Kieran-who/kia-tasman-fitout/docs/v0.8-concept.md

# v0.8: detailed model and full wiring diagram

Status: **eighth iteration.** The interference check reports **0 clashes** (travel + camp) after all detail passes were merged. Measurements are still the `[EST]` values in `cad/params.py` unless a published figure replaced them (listed below).

- Renders: [`renders/v0.8/`](../renders/v0.8) (26 images)
- Wiring diagram: [`docs/wiring/`](wiring) (eight A3 sheets as HTML, PDF and SVG)

## 1. More detail in every component

Every purchased component and fabricated part was redrawn from published drawings and photos. Part names, anchors and groups are unchanged, so the BOM, wiring and viewer still line up.

| Area | What changed | Renders |
|---|---|---|
| Vehicle | Tasman cab and body shape, published overhangs (5410 mm overall) and track, 265/70R17 wheels, C-section chassis. The tub liner follows the owner photo: ribs, arch hump with its recessed well, recessed wall panels, tie-down rails, corner cleats, factory outlet housing, tailgate panel and tail lights | `vehicle_01`, `vehicle_02` |
| Lid, rack, tent | Load-Lid with hinges, gas struts and lock. Destroyer rails. Teardrop Vortex bars on tapered brackets. Panther Horizon shell lofted from the 23Zero drawing, with hinges, latches, ladder bracket and eArc cells | `vehicle_03` |
| Tent services box | Real IP66 inlet and outlet faces, Anderson SB50 and MC4 pair. The box grew to 315 × 125 so the Clipsal 56-series faces fit, and still clears the lid by 38 mm | `vehicle_04` |
| Roof | Wedgetail extrusions, fairing with flush light bar, BlueSolar frames and cells, Starlink Mini, cargo bars | `vehicle_05` |
| Battery bay | MultiPlus-II with connection area and glands; Orion XS and MPPTs with heatsinks and terminal hoods; iTech400X Pro cases, terminals and straps; MRBFs, PowerBars, ML-RBS, Class-T, SmartShunt, MIDI/MEGA holders, lugs, fan, slotted guard | `bay_01`–`bay_04` |
| Cabinets | Jointed ply carcasses; 48" and 22" three-member runners; finger-jointed drawer boxes; divider channels; paddle latches. Full rear control panel. Behind it: RCBO enclosure, fuse block, Cerbo, wiring duct and glands | `cabinets_01`–`04` |
| Slides | DZ9308 three-member profile with ball races and holes, lock lever worked from the rear pull by cable, L-track profile, flanged receivers, power-pod sockets at real size, igus-style chain links, fold-out legs with clevis, pins and swivel foot | `slides_01`–`04` |
| Example payload | CFX3 45 (694 × 398 × 476, published), NCE microwave, drawer module, food crate, straps with buckles | `slides_05` |

**Model size:** each GLB is 6.4 MB (was 3.6 MB) and the build takes about 85 s (was about 35 s). Small round features are low-poly prisms to keep the viewer responsive.

## 2. Full wiring diagram

Sheets **E1–E8** are generated by `tools/wiring/diagram.py` from the same cable list that routes the 3D cables. Cable IDs and lengths always match `bom/cable-schedule-v0.8.csv`, and the generator fails if a cable isn't drawn.

| Sheet | Content |
|---|---|
| E1 | Locations, and which cables share each run (computed from the routed model) |
| E2 | Battery bank, MRBFs, busbars, ML-RBS isolation, SmartShunt, Class-T, MultiPlus DC, earthing |
| E3 | FB1 fuse block ways and every 12 V outlet |
| E4 | Alternator → Orion XS with ignition sense; roof and tent arrays → MPPTs |
| E5 | 230 V: shore inlet + RCBO → MultiPlus → RCBOs → outlets, earth path |
| E6 | Cerbo GX ports, GX Touch, Home Assistant, switch wiring, remote on/off |
| E7 | Tent harness, gap-junction connectors J1–J4 with pinouts, and the detach procedure |
| E8 | Cable routes (plan and side), bundles, cable to buy |

The schedules are on the same page: cables, protection, fuse-block ways and the component register.

**Design changes made while drawing it:**
- **Cerbo GX MK2:** it has only 3 VE.Direct ports. The Orion XS now connects through a **VE.Direct-to-USB** interface (D4).
- **ML-RBS:** its control circuit gets its own **2 A feed from the bank side** (F10/RBF), so the switch can close the RBS again. SW1 is now 4-core.
- **New circuits:**
  - IGN: ignition sense to the Orion's remote H, so smart-alternator voltage detection isn't relied on.
  - FAN: fused inverter fan.
  - CGX: Cerbo power.
  - PE1: inverter case to the system − bus (Victron: same size as the DC −).
  - CHB: one chassis bond.
- **Rear-panel DC outlets:** each now has its own fuse (DO1A–D) instead of sharing one cable.
- **Pod and cabin boxes:** each gets local 15 A and 10 A fuses for its 12 V and USB-C sockets.
- **Roof panels now in parallel.** The 190 W and 130 W panels have different currents, so in series the 190 W panel would be held back. Both arrays get 2-pole DC isolators.
- **MPPT 100/30 fuse:** reduced to 40 A.
- **Keyed tent connectors:**
  - The two 230 V connectors differ in rating and gender: J1 is a 10 A socket on the vehicle side, J2 is a 15 A inlet on the vehicle side. The tent's outlet can't be plugged into its own inlet.
  - The 12 V Anderson is red and the PV Anderson is grey; the two colours don't mate.
- **Shore power:** gets its own RCBO in the tent services box.

## 3. Real products that changed the model

| Item | Was | Now (published) |
|---|---|---|
| iTech400X Pro terminals | + and − at opposite ends | **Both at one end** (top), so the bank cables are shorter |
| MultiPlus-II 12/3000 | 20 kg; DC at the rear end | **19 kg; DC terminals toward the front wall, AC toward the rear** |
| SmartSolar 100/30 | 130 wide × 186 tall | **186 wide × 130 tall × 70** |
| ML-RBS 7713 | 110 × 95 × 100 | **139 × 95 × 52**, studs out of the bottom end |
| PowerBar 600 A / Class-T 5502 / MRBF 5191 | smaller placeholders | 178 × 51 × 51 / ~178 × 51 × 58 / 61 × 45 × 20 |
| Blue Sea 5026 fuse block | 211 × 45 × 140 | **164 × 84 × 39** |
| Clipsal Iconic double GPO (pod) | 70 mm pod | 120 × 78 → **pod deepened to 85 mm**. Fridge well is now 751 mm (CFX3 45 is 694) |
| Rear panel GPO | "56-series double" | There is no 56-series double. An IP66 twin is ~146 × 117, bigger than the panel's 120 × 86 space |
| DZ9308 runners | 6.3 kg/pair | ~5.75 kg (interpolated; confirm a 46" E4 length exists) |
| Divider channel | 12 × 12 × 1.6 | too tight for 9 mm ply → 12.7 × 8 × 1.2 |
| Utility drawer runners | ~600 mm | 22" (559 mm) to fit the 609 mm box |
| Tasman | – | overhangs 855 / 1285 mm, track 1636 / 1624 mm |

## 4. Layout issues the detail exposed (need decisions)

1. **MultiPlus cable entry.** Its cable-entry end is only **8 mm** from the distribution board, which was also true in v0.7. The 2 × 50 mm² DC cables and the AC glands need about 100 mm to bend.
   - Proposed fix: pass-through grommets in the board, in line with the inverter's entries, with the Class-T and busbars directly behind.
   - The alternative is re-shuffling the distribution column; the bay is about 90 mm short for that.
2. **DZ9308 front lock lever.** The real lever sticks out 27 mm, but there are only 2.6 mm to the rear plate. The model works the lever by Bowden cable from the rear pull. On the build: trim the lever or use a cable-release kit.
3. **Cable chain.** A real igus E2.26 with 38 mm inner width is 55 wide, and the lane is 50 mm. Use a chain no more than 40 mm wide outside (smaller series, ~25 mm inner width), or widen the lane, which costs deck width.
4. **Rear-panel GPO.** It needs a smaller twin, two single 56-series outlets, or a panel re-layout.
5. **Tent fold-out side.** The detail agent read `reference/vehicle-tent-open.jpg` as opening toward the passenger side. The model keeps the **driver side**, as you specified. Shout if the photo is right.
6. **Load-Lid gas struts.** They are modelled inside the top of the tub walls `[CONFIRM]`. If yours mount inside the tub, they would affect the passenger cable tray and the upper drawers.

**Also fixed:** the cable chain was 69 mm short at full extension. Its fixed end now sits at mid-travel, and its length is travel/2 + πR.

## 5. Numbers (model)

| | v0.7 | v0.8 |
|---|---|---|
| Fit-out total | 483.7 kg | **496.7 kg** (+13 kg). Mostly the drawer boxes, which were under-weighted before and are now real 9 mm panels. Then the runner plate, latches and stile. Runners got lighter |
| Rear axle added (fit-out, travel) | 459 kg | **471 kg** |
| Example payload | 108.2 kg | 108.2 kg |
| Cables | 35 | **46**, 104.9 m routed |
| GLB per state | 3.6 MB | 6.4 MB |

## 6. Questions for v0.9

1. MultiPlus cable entry: is the pass-through-grommet fix OK?
2. Rear-panel GPO: smaller twin, two singles, or re-layout the panel?
3. Tent fold-out side and gas-strut position: can you confirm both?
4. Still open: fridge model, and real measurements (tub floor height for the legs, arch well, tie-down points).
