Kieran-who/kia-tasman-fitout/reference/23zero-panther-horizon-1600-top-drawing.png

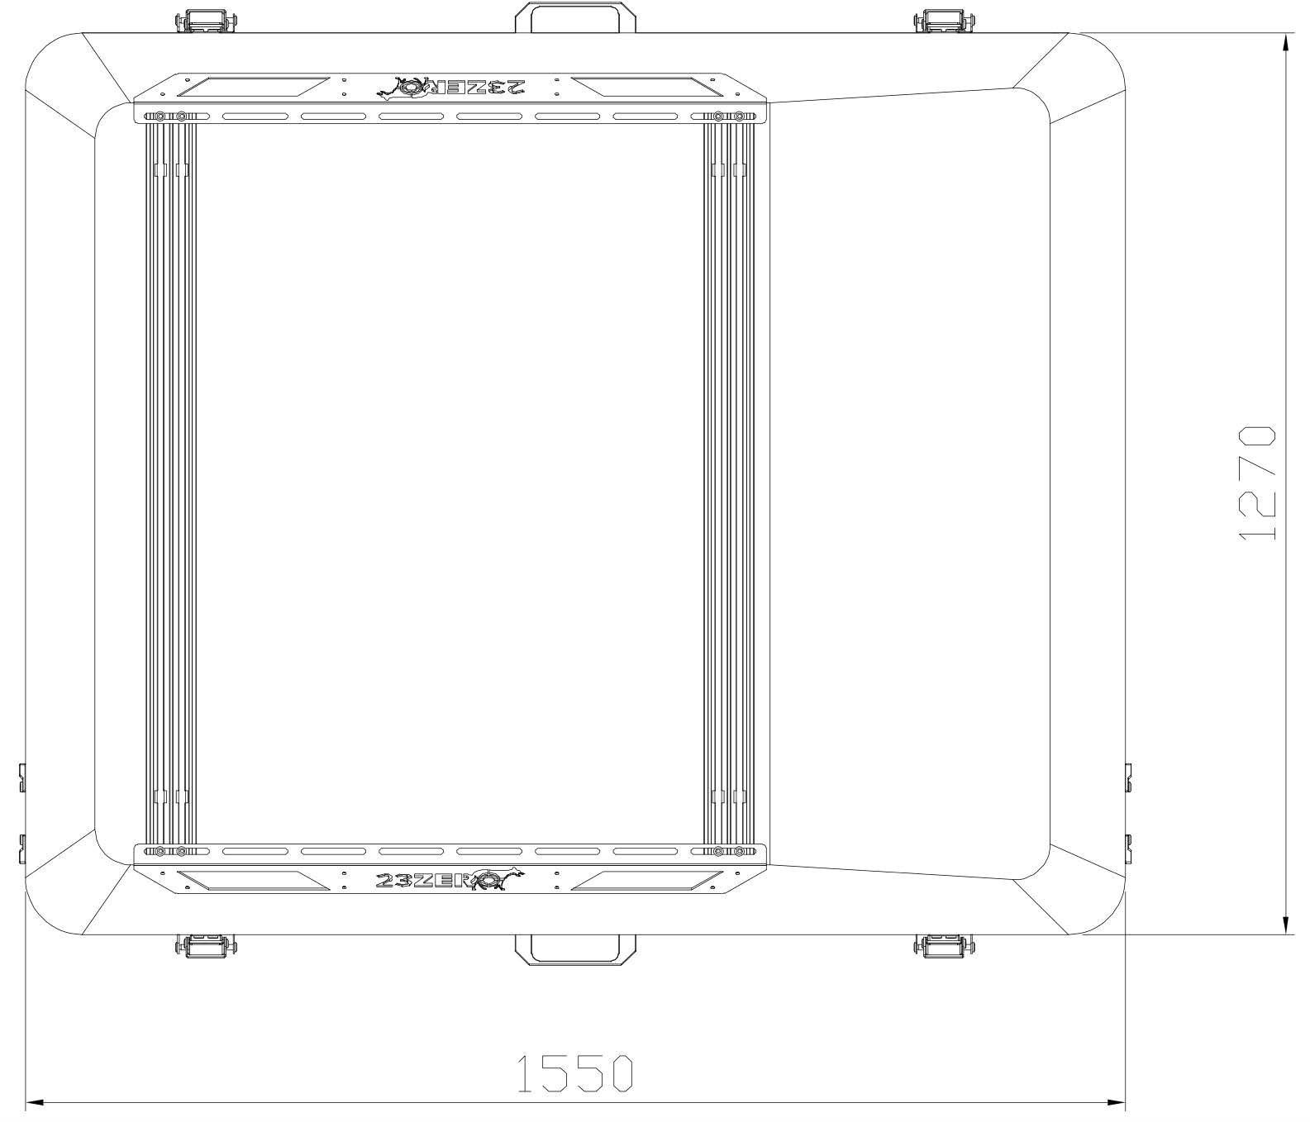
reference/23zero-panther-horizon-1600-top-drawing.png
