Kieran-who/kia-tasman-fitout/reference/tasman-tub-liner-arch-well.jpg

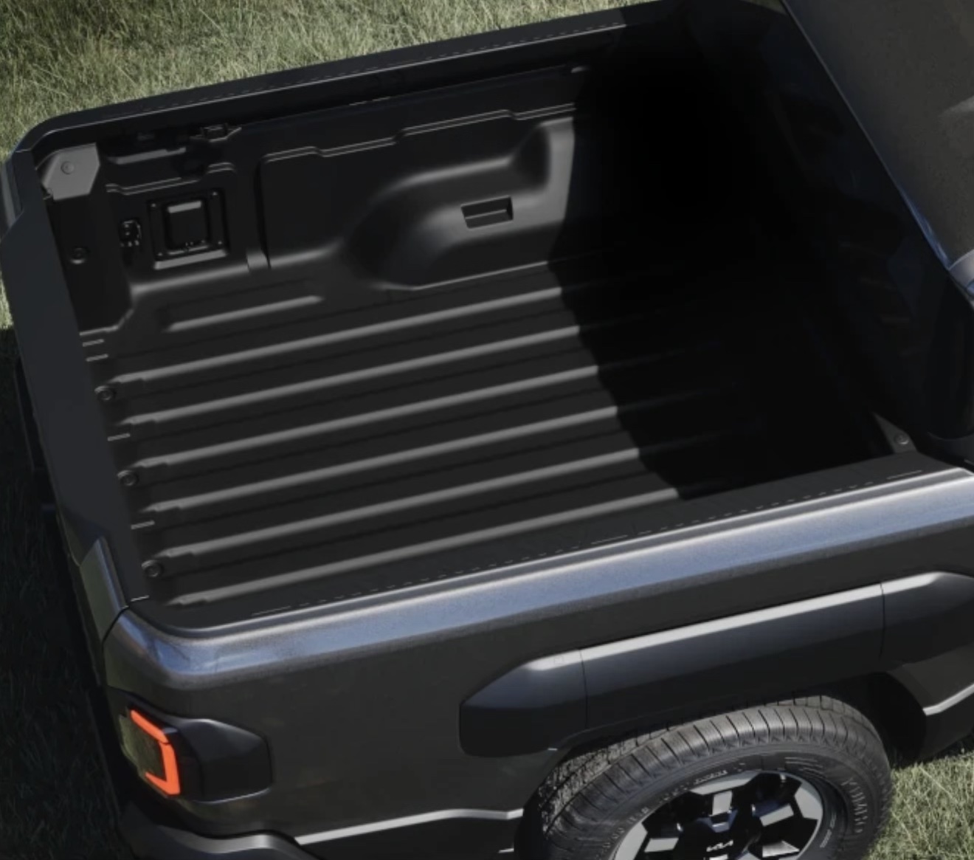
reference/tasman-tub-liner-arch-well.jpg
