Kieran-who/kia-tasman-fitout/reference/tent-closed-on-load-lid.jpg

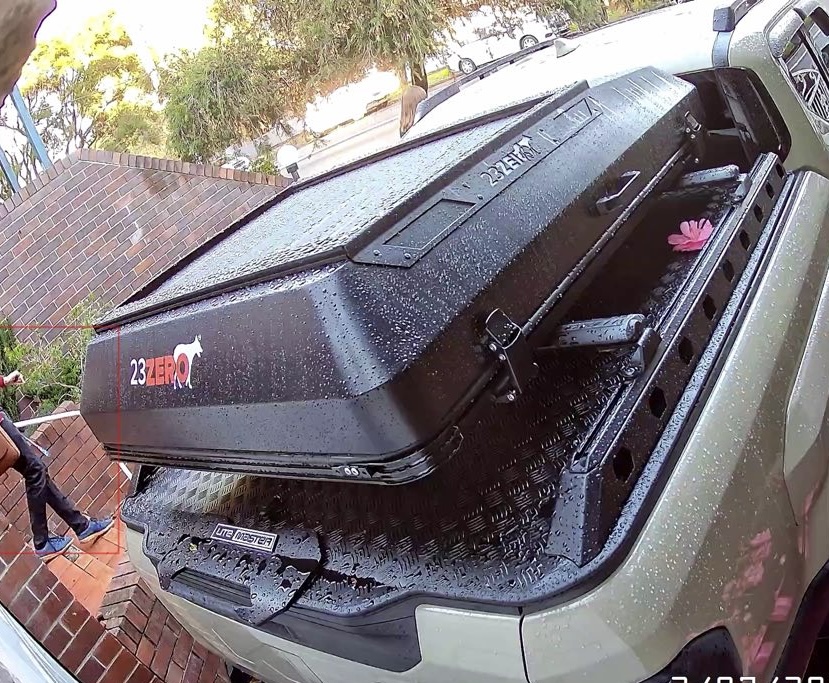
reference/tent-closed-on-load-lid.jpg
