Kieran-who/kia-tasman-fitout/reference/vehicle-tent-open.jpg

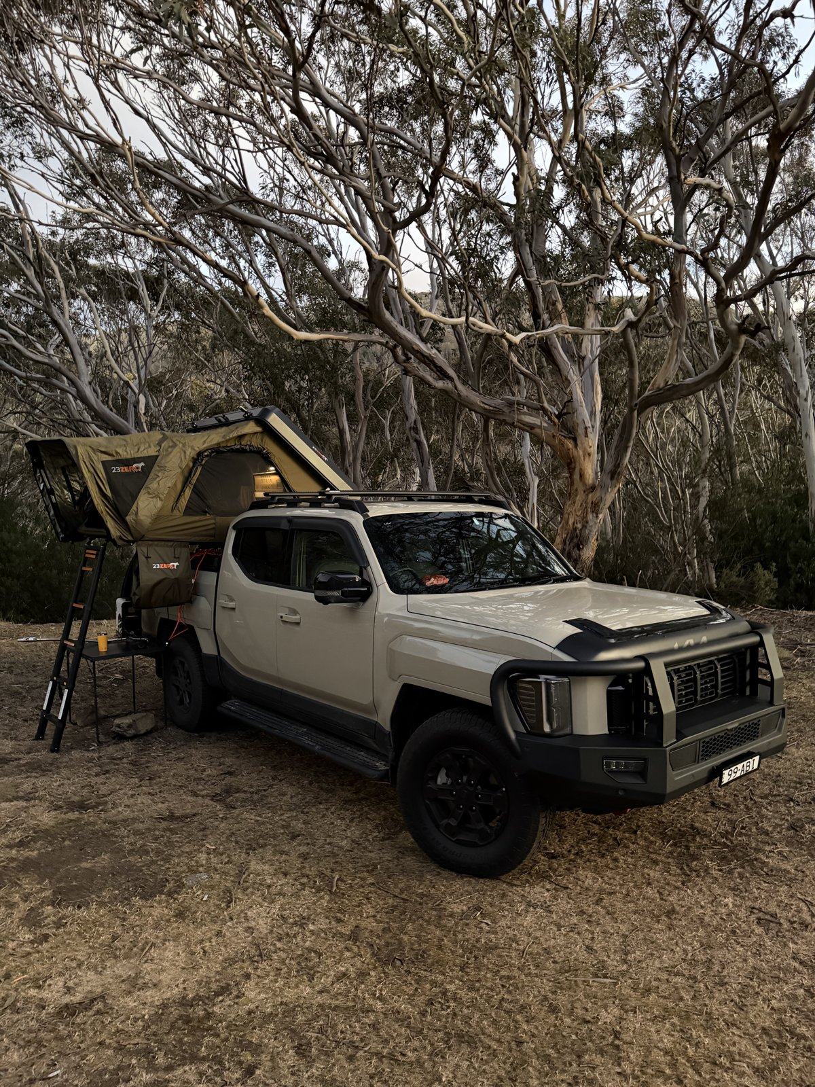
reference/vehicle-tent-open.jpg
