Kieran-who/kia-tasman-fitout/bom/cost-by-stage-v0.14.csv

stage | name | products AUD | cable AUD | materials AUD | stage total AUD | real prices AUD | running total AUD
1 | Power core | 7309 | 1234 | 769 | 9312 | 6374 | 9312
2 | Roof platform and solar | 3097 | 351 | 229 | 3677 | 2675 | 12989
3 | Slides and storage | 4268 | 131 | 1811 | 6210 | 32 | 19198
4 | 230 V and monitoring | 3688 | 578 | 0 | 4266 | 3104 | 23464
5 | Tent solar and cabin compute feed | 759 | 134 | 104 | 997 | 644 | 24462
6 | Under-tent storage | 996 | 5 | 371 | 1371 | 370 | 25833
7 | Visor and roof extras | 2944 | 108 | 41 | 3093 | 813 | 28926
