Kieran-who/kia-tasman-fitout/bom/product-list-v0.14.csv

system | item | model / part no. | qty | unit AUD inc GST | line AUD inc GST | price | source | price checked | dimensions mm | unit kg | status | stage | notes
energy storage | Lithium battery 12V 400Ah | iTechworld iTech400X Pro | 2 | 1996.0 | 3992.0 | actual | https://itechworld.com.au/products/12v-400ah-lithium-battery-with-bluetooth-itech400x-pro (iTechworld; sale price A$1,996 on 2026-10-23, regular A$3,499; has also shown A$2,499) | 2026-10-23 | 525x240x235 | 38 | owner-specified | 1 | mounted ON END (any orientation except upside down per iTechworld); 200 A continuous / 640 A 5 s, 150 A max charge (maker page 2026-10-23); no published low-temperature charge cut-off
distribution | MIDI/MEGA fuse holders + fuses | Blue Sea 5151 (MIDI) / 5502-type MEGA | 4 | 62.6 | 250.4 | actual | https://www.bluebottlemarine.com/products/blue-sea-systems-fuse-block-ami-or-midi.html + https://bluebottlemarine.com/products/blue-sea-ami-or-midi-fuses.html (Blue Bottle Marine; Blue Sea 7720B AMI/MIDI block A$57.60 + MIDI fuse A$5.00 (both sale); no AU listing for 5151; check the 7720B fuse range) | 2026-10-20 |  | 0.1 | proposed | 1:2,2:1,5:1 | F4 Orion 70 A, F5 MPPT roof 60 A, F6 MPPT tent 20 A, F7 fuse block 100 A MEGA (sheet E2)
monitoring | GX device | Victron Cerbo GX MK2 | 1 | 337.63 | 337.63 | actual | https://www.outbackmarine.com.au/victron-cerbo-gx-mk2 (Outback Marine; sale price, RRP A$526) | 2026-10-20 | 48x154x78 | 0.4 | proposed | 4 | Home Assistant: core Victron GX (MQTT) integration
monitoring | Touch display | Victron GX Touch 50 | 1 | 300.3 | 300.3 | actual | https://www.outbackmarine.com.au/victron-gx-touch-50-display (Outback Marine; sale price, RRP A$468) | 2026-10-20 | 87x128x12.5 | 0.2 | proposed | 4 | rear power panel
DC charging | DC-DC charger 50A | Victron Orion XS 12/12-50A | 1 | 465.0 | 465.0 | actual | https://www.mygenerator.com.au/victron-orion-xs-12-12-50a-dc-dc-battery-charger (MyGenerator; sale price, was A$587) | 2026-10-20 | 137x123x40 | 0.33 | proposed | 1 | input limit 25-30 A until alternator rating known
solar | MPPT roof array (PV1 + PV2) | Victron SmartSolar MPPT 100/30 | 1 | 199.0 | 199.0 | estimate | estimate: AU sale prices ~A$190-215 (RRP ~A$300); not checked this round |  | 130x186x70 | 1.3 | proposed | 2 | v0.13: back to the 100/30 - the visor panel moved to its own MPPT (U13)
solar | MPPT tent array | Victron SmartSolar MPPT 75/15 | 1 | 86.59 | 86.59 | actual | https://www.outbackmarine.com.au/victron-smartsolar-mppt-75-15-retail (Outback Marine; sale price, RRP A$135) | 2026-10-20 | 100x113x40 | 0.5 | proposed | 5
solar | Roof panel 190W | Victron BlueSolar 190 W (SPM041903903) | 1 | 180.07 | 180.07 | actual | https://www.outbackmarine.com.au/victron-solar-panel-190w-39-cells-mono-1485x668x30~211745 (Outback Marine; sale price, RRP A$270; current variant SPM041903904) | 2026-10-20 | 1485x668x30 | 10.5 | proposed | 2
solar | Roof panel 130W | Victron BlueSolar 130 W | 1 | 131.52 | 131.52 | actual | https://www.outbackmarine.com.au/victron-solar-panel-130w-36-cells-mono-1020x668x30 (Outback Marine; sale price, RRP A$197; SPM041303603) | 2026-10-20 | 1020x668x30 | 7.1 | proposed | 2 | leaves the Starlink pocket
solar | Tent flexible panel 100W | Sunman eArc 100 W | 2 | 229.0 | 458.0 | actual | https://www.solar4rvs.com.au/products/sunman-earc-100w-flexible-solar-panel (Solar4RVs; Sunman eArc 100 W Narrow SMF100J-2X14UW; MyGenerator A$299) | 2026-10-20 | 1093x552x2 | 2 | proposed | 5 | bonded to 3 mm ACM sheet across tent top bars
protection | DC fuse block 12-way + neg bus | Blue Sea 5026 | 1 | 86.35 | 86.35 | actual | https://www.bluebottlemarine.com/products/blue-sea-st-blade-fuse-block-with-cover-12-circuit-with-negative-bus.html (Blue Bottle Marine; sale price, RRP A$96.75) | 2026-10-20 | 164x84x39 | 0.6 | proposed | 1 | FB1 (sheet E3)
AC | RCBO 10 A 30 mA | Clipsal/Hager 1P+N | 3 | 33.1 | 99.3 | actual | https://www.sparkydirect.com.au/p/CLIPSAL-RCBE21030S-10amp-rcbo-1p-ResiMax (Sparky Direct; Clipsal RCBE210/30S; possibly clearance) | 2026-10-20 |  | 0.2 | proposed | 4 | rear GPOs / slide / tent - licensed electrician
AC | IP66 enclosure for RCBOs | Clipsal 56 series (TBC) | 1 | 30.0 | 30.0 | estimate | Jaycar SF4158 4-way IP66 breaker enclosure ~A$27-32 (listing unavailable) |  | 140x180x100 | 0.6 | proposed | 4 | inside power cabinet
AC | Flush double GPO (slide pod top) | Clipsal Iconic (TBC) | 1 | 8.53 | 8.53 | actual | https://www.sparkydirect.com.au/p/Clipsal-Iconic-3025VW-Double-Power-Point-10Amp-Vivid-White (Sparky Direct; Iconic 3025-VW, sale to 31 Oct 2026 (was A$9.89)) | 2026-10-20 | 116x73 | 0.2 | proposed | 4 | faces up on the power pod
AC | IP66 inlet 15A (shore) | Clipsal 56AI315 | 1 | 135.04 | 135.04 | actual | https://www.sparkydirect.com.au/p/CLIPSAL-56AI315-Appliance-Inlet-3-Flat-Pin-15Amp-IP66-56-SERIES (Sparky Direct; A$122.76 ex GST; Clipsal RRP A$290) | 2026-10-20 | 101x107x82 | 0.42 | proposed | 4 | tent services box
AC | Gap junction 230 V connectors | J1: IP66 10 A socket outlet 56SO310 (vehicle) + 10 A plug (tent); J2: IP66 15 A inlet 56AI315 (vehicle) + 15 A extension socket (tent) | 1 | 289.68 | 289.68 | actual | Sparky Direct: 56C310-GY A$71.54 + 56P310-EO plug A$25.34 (https://www.sparkydirect.com.au/p/CLIPSAL-56P310-EO-3-Pin-Flat-10Amp-Straight-Plug-IP66-56-Series) + 56AI315 A$135.04 + 56CSC315-EO extension socket A$57.76 (https://www.sparkydirect.com.au/p/CLIPSAL-56CSC315-EO-Extension-Socket-3-Flat-Pin-15Amp-IP66-56-series-Orange) (Sparky Direct; sum of four listed prices) | 2026-10-20 |  | 0.8 | proposed | 4 | keyed by rating and gender so the tent can't feed its own outlet (sheet E7)
DC | Anderson SB50 + flush housings | Anderson SB50 red / Altronics P7862 | 6 | 35.0 | 210.0 | estimate | Altronics P7862 flush housing A$23.25 inc GST + genuine SB50 red ~A$12 (Altronics) |  |  | 0.1 | proposed | 1:2,3:1,4:2,5:1 | X1-X5 + J3 (rear x2, pod, compute-box inlet in the cabin, tent 12 V, gap junction)
DC | 12V socket | Narva / Blue Sea | 2 | 31.99 | 63.98 | actual | https://autopro.com.au/ap/Autopro-Category/Brands/Narva/Narva-Heavy-Duty-Accessory-Socket/p/EL01840 (Autopro; Narva 81026BL) | 2026-10-20 |  | 0.05 | proposed | 1:1,3:1 | rear panel + power-slide pod (none in the cabin, v0.11)
wiring | IP66 junction box | generic polycarbonate | 1 | 55.0 | 55.0 | estimate | IP66 polycarbonate box ~200x150x100 ~A$40-50 + 3-4 IP68 glands (RS PRO IP66 120x200x75 is A$63 inc GST) |  | 175x40x175 | 1.8 | proposed | 4 | cab-tub gap (passenger front corner) - measure gap
wiring | Cable gland plate / split cable entry | icotek KEL (or plate + glands) | 2 | 85.0 | 170.0 | estimate | icotek KEL-ER split frame ~GBP35 ex VAT at RS UK (~A$80 inc GST) + grommets (RS Components; generic split entry plates ~A$20-30) |  |  | 0.2 | proposed | 1 | v0.13: gland plate in the old outlet hole (12 V rows + 230 V row) and the 12 V slot into the cabinet top
wiring | Cables | see bom/cable-totals-v0.13.csv | 1 |  | 0 | in cables | priced per metre in the cost summary (cable schedule) |  |  |  | proposed | 1 | lengths from the routed model (46 cables)
slides | L-track heavy duty | 35x13 | 3 | 35.0 | 105.0 | estimate | heavy-duty aluminium L-track in AU ~A$30-45/m (per metre) |  |  | 0.75 | proposed | 3 | deck centres + well filler (v0.12: no tracks in the well pan); model need 2.2 m
slides | Ball-lock receiver (flanged stainless bush 8mm) |  | 150 | 1.5 | 225.0 | estimate | 8 mm ID flanged stainless sleeve in bulk ~A$0.80-2.00 each (AliExpress / eBay) (AliExpress / eBay AU; locally machined stainless would cost several times more) |  | 22 OD | 0.03 | proposed | 3 | v0.6 edge-to-edge grid: 106 in the decks + 32 in the well filler, + spares
slides | Ball-lock pin 8 mm stainless (>= 32 mm grip) |  | 52 | 18.0 | 936.0 | estimate | 8 mm stainless ball-lock pin, 32-40 mm grip ~A$15-25 each in AU (bulk price may be lower) |  |  | 0.05 | proposed | 3 | 4 per module; 3 per leg (clevis lock + 2 section joints); edge fences 6 each, cross dividers 2 each; grip must reach under the RHS top wall at the edge rows
roof | Roof platform | Wedgetail Adventure WT-KT-1614U + WTM-KT-1614 | 1 | 2195.0 | 2195.0 | actual | https://roofrack.com.au/product/kia-tasman-dual-cab-2025-current-wedgetail-adventure-platform/ (Roof Rack Superstore; WT-KT-1614U incl. WTM-KT-1614 Tasman mount kit; pre-order discount seen at A$2,085) | 2026-10-20 | 1600x1450 | TBC | proposed | 2 | factory roof points
roof | Recessed solar brackets | Wedgetail | 1 | 199.0 | 199.0 | estimate | no product page found for Wedgetail recessed solar brackets; standard WTA-SPB pair is A$117 at roofrack.com.au |  |  |  | proposed | 2
roof | Light bar ~40in flush | TBC | 1 | 309.0 | 309.0 | actual | https://frankiesautoelectrics.com.au/products/stedi-ledst3k-40l-st3k-41-5-low-profile-40-led-slim-light-bar (Frankie's Auto Electrics; Stedi ST3K 41.5 in slim bar; may be out of stock; Wedgetail light-bar plate WTA-LBS A$157 extra if needed) | 2026-10-20 |  | 3 | proposed | 7
roof | Starlink Mini mount | Wedgetail / Front Runner RRAC352 | 1 | 60.0 | 60.0 | actual | https://www.dometic.com/en-au/product/starlink-mini-quick-release-mount-rrac352 (Dometic / Front Runner; RRAC352 is made for Front Runner rails and may need adapting; Wedgetail WTA-LSLMM lockable mount is A$300) | 2026-10-20 |  | 0.7 | proposed | 2 | inside frame
roof | Cargo bars + risers | platform-compatible | 1 | 420.0 | 420.0 | estimate | Wedgetail Sides for 1600 mm platforms WTA-S16 A$360 (https://roofrack.com.au/product/wedgetail-adventure-accessory-sides-for-1600mm-platforms-wta-s16/) + ~A$60 risers/hardware (A$360 if the sides alone do the job) |  |  | 8.4 | proposed | 7 | removable
tent | Rhino-Rack Vortex bars + raised brackets | existing | 2 | 560.0 | 0 | owned | already owned, not counted; reference price: Vortex bar ~A$119 each + ~A$300-350 tall legs |  |  |  | existing | -
inverter/charger | Inverter/charger 3000 VA (2400 W) | Victron MultiPlus-II 12/3000/120-32 230V | 1 | 1667.45 | 1667.45 | actual | https://www.outbackmarine.com.au/multiplus-ii-12-3000-70-32-230v-PMP122305010 (Outback Marine; sale price, RRP A$2,597; PMP122305010) | 2026-10-20 | 546x275x147 | 20 | proposed | 4 | lying flat beside the batteries (not above); 120 A charger; 32 A transfer; kettle OR microwave
inverter/charger | Cooling fan 12V 92mm thermostatic | generic | 1 | 19.95 | 19.95 | actual | https://jaycar-prod.australia-southeast1.gcp.storefrontcloud.io/90mm-12v-dc-2-wire-fan/p/YX2521 (Jaycar; YX2521 92 mm, sale price; plain fan, not thermostatic) | 2026-10-20 | 92x92x25 | 0.3 | proposed | 4 | above the inverter, under the charging board
protection | Terminal fuse 300 A (per battery) | Blue Sea 5191 MRBF + 300 A | 2 | 70.55 | 141.1 | estimate | holder BS-5191B A$40.60 at https://www.bluebottlemarine.com/products/blue-sea-mrbf-terminal-fuse-block-30-to-300a.html + 300 A MRBF fuse ~A$30 (top of the A$23-30 range) (Blue Bottle Marine; holder price real, fuse estimated) |  | 40x35x14 | 0.1 | proposed | 1 | on each battery + terminal
protection | Terminal fuse 30 A (power-slide feed, F17) | Blue Sea 5191 MRBF block + 30 A MRBF fuse | 1 | 65.0 | 65.0 | estimate | block A$40.60 at https://www.bluebottlemarine.com/products/blue-sea-mrbf-terminal-fuse-block-30-to-300a.html + MRBF fuse ~A$23-30 |  | 61x45x20 | 0.05 | proposed | 3 | v0.12: on the BB3 spare stud; DO2 now fed from the bay (FB1 way 5 freed)
protection | Class-T 400 A (inverter feed) | Blue Sea 5502 + 5121 | 1 | 207.9 | 207.9 | estimate | 5502 holder A$100 at https://www.bluebottlemarine.com/products/blue-sea-class-t-fuse-block-with-insulating-cover-225-to-400a.html + 400 A Class-T fuse ~A$108 (top of the A$73-108 range) (Blue Bottle Marine; holder price real, fuse estimated) |  | 115x70x75 | 0.5 | proposed | 4 | Victron spec for MultiPlus-II 12/3000
protection | Remote battery switch 500 A | Blue Sea ML-RBS 7713 (12 V) | 1 | 478.4 | 478.4 | actual | https://www.bluebottlemarine.com/products/blue-sea-ml-series-remote-battery-switch-auto-release-500a.html (Blue Bottle Marine; sale price, RRP A$536; control switch not included) | 2026-10-20 | 110x95x100 | 0.9 | proposed | 1 | latching, manual override; controlled from the rear panel
protection | Switch for ML-RBS + inverter remote | IP66 illuminated rockers / Blue Sea ML-RBS contura switch | 2 | 36.0 | 72.0 | estimate | Carling Contura II illuminated base A$27.35 inc GST at swe-check.com.au + actuator ~A$8-9 (Swe-Check) |  |  | 0.05 | proposed | 1:1,4:1 | rear control panel
distribution | Busbars 600 A (bank +/-, system +/-) | Blue Sea PowerBar 600A (part TBC) | 4 | 169.95 | 679.8 | actual | https://www.bluebottlemarine.com/products/blue-sea-powerbar-4-terminal-bus-bar-600a.html (Blue Bottle Marine; 2104B 4-stud, sale price, RRP A$190.40) | 2026-10-20 | 200x50x45 | 0.6 | proposed | 1
monitoring | Battery shunt 500A | Victron SmartShunt 500A | 1 | 143.39 | 143.39 | actual | https://www.outbackmarine.com.au/victron-smartshunt-500a-50mv (Outback Marine; sale price, RRP A$223) | 2026-10-20 | 46x120x54 | 0.2 | proposed | 1
AC | Rear double GPO + weatherproof cover | Clipsal Iconic horizontal double (120x78, as on the power pod) + clear flip cover | 1 | 33.1 | 33.1 | actual | https://www.sparkydirect.com.au/p/CLIPSAL-Iconic-O3025-XW-Double-Weatherproof-Power-Point-10amp-White-IP54 (Sparky Direct; Iconic Outdoor O3025-XW IP54 with hinged cover (instead of a separate flip cover)) | 2026-10-20 | 120x78 | 0.4 | proposed | 4 | v0.9: fits the panel envelope; panel is recessed 105 mm behind the tailgate, under the lid - electrician to confirm the IP rating needed
AC | IP66 outlet 10A | Clipsal 56SO310A | 1 | 71.54 | 71.54 | actual | https://www.sparkydirect.com.au/p/Clipsal-56C310-GY-3-Pin-10Amp-Switched-Socket-Outlet-IP66-56-Series (Sparky Direct; Clipsal 56C310-GY (no listing for 56SO310)) | 2026-10-20 | 101x107x77 | 0.4 | proposed | 4 | tent heater
storage | Full-extension runners 48in light/medium duty | TBC (e.g. 1219 mm, 45-70 kg/pair) | 4 | 65.0 | 260.0 | estimate | 1219 mm 45-70 kg full-extension runners ~A$110-150 per pair in AU (per runner) |  | 1219x45x13 | 1.6 | proposed | 3 | upper drawers (2 pairs)
storage | Side-mount runners 22 in (559 mm) | TBC | 2 | 18.0 | 36.0 | estimate | 22 in (559 mm) full-extension side-mount runners ~A$30-40 per pair (per runner) |  | 559x45x13 | 1.0 | proposed | 3 | lower utility drawer (1 pair; ~600 mm runners do not fit the 609 mm box)
storage | Cable tray / wall channel | 3 mm aluminium angle (fabricated) | 1 |  | 0 | in materials | raw material priced in the cost summary (cut list) |  | 1380 long |  | proposed | 1 | passenger wall above the upper drawer
slides | Locking slide 46in (handed L/R) | Accuride DZ9308 46" | 4 | 520.0 | 2080.0 | estimate | no AU listing for DZ9308 46 in; EU retail DZ9308 ~EUR241 per slide at shorter length, scaled to 46 in ~A$500-550 per runner (per runner; ask RS Australia or Metrol for a quote) |  | 1168.4x76.2x19.1 | 6.3 | proposed | 3 | 1 pair per slide, side-mounted under the covered deck
slides | Cable drag chain | igus E2.15.30 (30 mm inner, 37.8 x 19.3 outer), R75, ~0.82 m lying on its side + end brackets | 1 | 110.0 | 110.0 | estimate | igus E2.15 ~A$50-70 for 0.8 m + ~A$40 mounting brackets |  | 38 wide | 0.8 | proposed | 3 | v0.12: under the power deck on a 3 mm glide tray (below the raised fridge-well pan); fixed end at mid-travel
slides | Fold-out telescopic legs (fabricated) | 6060 SHS 32x32x2 / 25x25x2 / 19x19x1.6 nested, 380/370/360 long; 8 mm holes at 25 mm | 4 |  | 0 | in materials | raw material priced in the cost summary (cut list) |  | closed 380, reach ~1000 below the pivot | 0.6 | proposed | 3 | v0.7: clevis-mounted under each deck, fold across + clip; nylon/UHMW slide pads in each joint
slides | Leg clevis + pivot | 2 x 6 mm 5052 plates + M10 shoulder bolt + nyloc | 4 | 30.0 | 120.0 | estimate | 2 small 6 mm aluminium plates (laser cut) ~A$8-10 each + M10 stainless shoulder bolt ~A$8-10 + nyloc |  |  | 0.1 | proposed | 3 | bolts through the RHS side member; second hole for a ball-lock pin locks the leg vertical
slides | Swivel levelling foot M10 | 40 mm pad | 4 | 6.0 | 24.0 | estimate | M10 swivel levelling foot 40 mm pad ~A$4-8 |  |  | 0.15 | proposed | 3 | final height trim after the leg is pinned
slides | Leg stow clip | spring tool clip 32 mm on a UHMW block under the deck | 4 | 6.0 | 24.0 | estimate | 32 mm spring tool clip ~A$1.50 + UHMW block offcut ~A$4 |  |  | 0.05 | proposed | 3 | holds the folded leg; add a velcro/rubber strap if it rattles
DC | Dual USB-C socket (100 W PD + 20 W) | Treklo dual USB-C 120 W flush mount (100 W PD + 20 W), 12-24 V | 2 | 88.0 | 176.0 | actual | https://campervanbuilders.com.au/products/dual-usb-c-120w-socket-flush-mount-waterproof (Campervan Builders; showed sold out) | 2026-10-20 | ~29 round cutout | 0.05 | proposed | 1 | rear panel x2: 2 x 100 W + 2 x 20 W ports on one ATC 25 A / 4 mm2 feed; none on the pod or in the cabin (v0.11)
storage | Aluminium U-channel for divider slots | 12.7x8x1.2 6060 (10.3 mm gap for 9 mm ply) | 40 | 3.5 | 140.0 | estimate | small aluminium channel ~A$10/m at Bunnings (Metal Mate 16x12x1.6 1 m A$10.38), per 300 mm piece (Bunnings / metal supplier; 12.7x8x1.2 is not a Bunnings size) |  | ~190 long each | 0.03 | proposed | 3 | upper drawers, 120 mm pitch both sides (12x12x1.6 is too tight for 9 mm ply)
storage | Lift-out dividers | 9 mm ply | 6 |  | 0 | in materials | raw material priced in the cost summary (cut list) |  | ~125x190 |  | proposed | 3 | upper drawers
slides | Deck carrier L-angle | 60x40x3 6060 aluminium | 4 |  | 0 | in materials | raw material priced in the cost summary (cut list) |  | 1174 long | 0.9 | proposed | 3 | top leg over the runner carries the ply edge
slides | Fridge-well filler (fabricated) | 15 mm ply panel 758x415 on 2 x 18 mm ply risers + L-track 736 | 1 |  | 0 | in materials | raw material priced in the cost summary (cut list) |  | 758x415x~90 | 5.0 | option | 3 | v0.6: lifts out when a fridge is fitted; risers stud into the well L-tracks; see cut list (well_filler)
slides | Flush folding tie-down rings (fridge straps) | stainless flush D-ring, riveted to the well pan | 4 | 12.0 | 48.0 | estimate | flush folding tie-down ring ~A$8-15 each |  |  | 0.05 | proposed | 3 | v0.12: replace the pan L-tracks (the fridge now stands on the pan, 18 mm under the lid)
slides | Example edge fence / cross divider (fabricated) | 12 mm ply wall 95 high on 60x6 6060 flat foot | 6 |  | 0 | in materials | raw material priced in the cost summary (cut list) |  |  | 1.7 | option | 3 | v0.6 example modules: wall flush with the deck edge, pins in the edge receiver row; see cut list (modules)
monitoring | VE.Direct to USB interface | Victron ASS030530010 | 2 | 39.45 | 78.9 | actual | https://www.solar4rvs.com.au/products/victron-ve-direct-to-usb-interface-cable (Solar4RVs; sale price; Outback Marine A$48.01) | 2026-10-20 |  | 0.05 | proposed | 4:1,7:1 | Orion XS (D4) and the visor MPPT (D5)
monitoring | VE.Direct cables | Victron VE.Direct cable (lengths per schedule) | 3 | 18.79 | 56.37 | actual | https://www.outbackmarine.com.au/ve.direct-1.8m-cable-victron-ass030530218 (Outback Marine; 1.8 m, sale price) | 2026-10-20 |  | 0.05 | proposed | 4 | SmartShunt, MPPT 100/50, MPPT 75/15 - D2
monitoring | RJ45 VE.Bus cable | Victron RJ45 UTP 5 m | 1 | 25.0 | 25.0 | actual | https://www.solar4rvs.com.au/products/victron-cat5e-rj45-utp-ethernet-patch-cable-5m (Solar4RVs; sale price) | 2026-10-20 |  | 0.1 | proposed | 4 | D1
protection | ML-RBS remote switch | Blue Sea 2155 Contura SPDT ON-ON with LED | 1 | 50.75 | 50.75 | actual | https://bluebottlemarine.com/products/blue-sea-contura-remote-control-switch-spdt-on-on.html (Blue Bottle Marine; Blue Sea 2155, sale price, RRP A$56.90) | 2026-10-20 |  | 0.05 | proposed | 1 | S1 - check whether it is included with the 7713
protection | Inline ATC fuse holders | weatherproof inline ATC | 4 | 10.14 | 40.56 | actual | https://maxiparts.com.au/ELN5440610-weatherproof-ats-blade-fuse-holder-bulk (Maxiparts; Narva 54406BL single) | 2026-10-20 |  | 0.03 | proposed | 1:2,4:2 | F10 2 A (RBS feed), F12 5 A (fan), + spares
protection | Add-a-fuse (ignition sense) | mini/micro add-a-fuse to suit the Tasman fuse box | 1 | 5.95 | 5.95 | actual | https://jaycar.com.au/p/SF5125 (Jaycar; sale price (was A$7.95)) | 2026-10-20 |  | 0.02 | proposed | 1 | F9 2 A - IGN to Orion XS remote H
protection | MIDI fuse holder at start battery | Blue Sea 5151 + 60 A MIDI | 1 | 62.6 | 62.6 | actual | https://www.bluebottlemarine.com/products/blue-sea-systems-fuse-block-ami-or-midi.html + https://bluebottlemarine.com/products/blue-sea-ami-or-midi-fuses.html (Blue Bottle Marine; 7720B block A$57.60 + 60 A MIDI fuse A$5.00 (sale)) | 2026-10-20 |  | 0.1 | proposed | 1 | F8 - ALT
protection | RCBO 16 A 30 mA 2-pole (shore in, Q4) | 2-pole RCBO 16 A 30 mA (switches active and neutral) | 1 | 95.0 | 95.0 | estimate | estimate: 2-pole RCBO 16 A 30 mA ~A$80-110 at AU wholesalers |  |  | 0.2 | proposed | 4 | v0.13: double-pole isolation at the inlet (campsite polarity unknown), AS/NZS 3001.2
protection | 2-pole DC PV isolator 32 A | e.g. NHP / Suntree 2P 32 A DC | 3 | 36.78 | 110.34 | actual | https://sparkydirect.com.au/p/NHP-NL432PV-Enclosed-DC-Isolating-Switch-32A-1500V-IP66-4-Pole (Sparky Direct; NHP NL432PV enclosed 4-pole (wire as 2-pole); unusually low price) | 2026-10-20 |  | 0.3 | proposed | 2:1,5:1,7:1 | QP1 roof, QP2 tent, QP3 visor (v0.13)
solar | MC4 Y-branch pair | MC4 2-to-1 branch (+ and -) | 1 | 8.8 | 8.8 | actual | https://solarshop.baywa-re.com.au/MC4-compatible-Y-branch-socket-Pair (BayWa r.e. Solar Shop; A$8.00 ex GST) | 2026-10-20 |  | 0.1 | proposed | 2 | roof panels in parallel
DC | Anderson SB50 grey (PV) | Anderson SB50 grey + housing | 2 | 37.0 | 74.0 | estimate | Altronics P7862 housing ~A$23.25 + genuine SB50 grey ~A$13-14 |  |  | 0.1 | proposed | 5 | J4 tent PV - grey and red SB50 can't mate
DC | Local fuse holder (pod) | 2-way ATC holder + M6 +/- studs | 1 | 12.0 | 12.0 | estimate | 2-way ATC holder ~A$10-15 (Jaycar SZ2044 single A$10.25) |  |  | 0.1 | proposed | 3 | FB2: X3 Anderson 20 A (F14), X7 12 V socket 15 A (F13)
wiring | Earth conductor | 50 mm2 green/yellow + lugs | 1 |  | 0 | in cables | priced per metre in the cost summary (cable schedule) |  |  |  | proposed | 4 | PE1 MultiPlus case to BB4 (Victron: same size as DC -)
wiring | Chassis bond | 25 mm2 black + lug to chassis rail | 1 |  | 0 | in cables | priced per metre in the cost summary (cable schedule) |  |  |  | proposed | 1 | CHB single DC-/PE bond
distribution | Edge grommet strip | rubber U-section edge trim for 6 mm plate (~0.5 m) | 1 | 8.0 | 8.0 | estimate | rubber U-section edge trim ~A$5-15/m |  |  | 0.05 | proposed | 4 | v0.9: lines the cable window in the distribution board (MultiPlus DC/AC cables pass straight through)
under-tent | Flat jerry can 30 L (water) | OnTrack Outdoor slimline 30 L (army green) | 1 | 259.9 | 259.9 | actual | https://ontrackoutdoor.com.au/products/jerry-can (OnTrack Outdoor; 30 L army green; yellow/black is A$229.90) | 2026-10-20 | 860x340x150 | 3.5 | proposed | 6 | captive on the lid, filled/drawn in place; confirm food-grade for drinking water
under-tent | Diesel pack 1 gal (3.8 L) | RotopaX 1 gal diesel + pack mount (+ lock) | 1 | 270.0 | 270.0 | estimate | 1 gal fuel pack ~A$100-120 (Barrett A$100) + LOX lockable mount A$125-207 |  | 340x240x76 | 1.0 | proposed | 6 | refills the 3 L heater tank once
under-tent | Fire extinguisher 2 kg ABE dry powder | AS/NZS 1841.5 | 1 | 55.0 | 55.0 | estimate | 2 kg ABE ~A$50-67 in AU (Atom Fireworld snippet A$66.96; FirePro 2.5 kg ~A$46) |  | ~110 dia x 430 | 3.6 | proposed | 1 | rear-passenger corner of the lid, quick-release bracket
under-tent | Quick-release extinguisher bracket | strap-type quick release (e.g. Front Runner / Rhino-Rack) | 1 | 60.0 | 60.0 | estimate | generic quick-release vehicle extinguisher bracket ~A$40-80 |  |  | 0.6 | proposed | 1
under-tent | Drawer runners 36 in full-extension locking | side-mount pair ~45 kg rated (TBC) | 1 | 120.0 | 120.0 | estimate | Giantz 227 kg locking slides 914-1829 mm ~A$120 per pair (914 mm variant not confirmed) (per pair) |  | 914 long | 3.0 | proposed | 6 | rear-loading under-tent drawer
under-tent | Rivnuts M8 aluminium | flanged M8 rivnuts | 80 | 1.37 | 109.6 | actual | https://au.element14.com/laser/3643/riveting-nuts-8mm-pk10/dp/2503743 (element14 Australia; Laser 3643 M8 aluminium rivnut, 10-pack A$13.73 inc GST / 10) | 2026-10-20 |  |  | proposed | 6 | cross-bars at 100 mm pitch
under-tent | Rail T-track clamps | T-bolts/nuts to suit Destroyer rail T-track + 40x40 angle brackets | 10 | 5.0 | 50.0 | estimate | M8 T-bolt/T-nut ~A$1-2 + 40x40 angle bracket ~A$2-3 (must match the rail T-slot) |  |  | 0.1 | proposed | 6 | clamp each cross-bar end
under-tent | Cam-buckle straps 25 mm |  | 2 | 8.0 | 16.0 | estimate | 25 mm cam-buckle strap ~A$5-10 |  |  | 0.15 | proposed | 6 | water can hold-down
under-tent | Folding table | Wanderer Lightweight Steel Folding Table II (BCF 652538) | 1 | 69.99 | 0 | owned | already owned, not counted; reference price: https://www.bcf.com.au/p/wanderer-lightweight-steel-folding-table-ii/652538.html (BCF; Club BCF A$49.99) | 2026-10-20 | 800x600x40 packed | 4.6 | owner | - | stored flat in the drawer
visor | Visor solar panel ~250 W | semi-flexible monocrystalline, bonded to 10 mm aluminium honeycomb; ~1300 x 1000 | 1 | 399.0 | 399.0 | actual | https://www.solar4rvs.com.au/products/sunman-earc-230w-flexible-solar-panel (Solar4RVs; nearest match: Sunman eArc 230 W flexible SMF230J-8X8UW-S; size not confirmed; honeycomb backing not included) | 2026-10-20 | 1300x1000x25 | 8.5 | proposed | 7 | PV5 - size to the platform; confirm Voc < 25 V so the parallel array stays inside the 100/50 limits
visor | Linear guide rail + carriage | aluminium profile rail with 2 wheel/ball carriages (e.g. igus drylin W or 40-series V-slot) | 2 | 140.0 | 280.0 | estimate | V-slot 2040 x 1500 mm + 2 gantry plates + 8 wheel kits (Maker Store AU range ~A$147 per profile, gantry plate A$14.65) (Maker Store (AU); igus drylin W rail alone is ~A$280+) |  | 1400 long | 3.0 | proposed | 7 | under the platform at Y +/-560; hung on 40x5 straps from the platform side rails
visor | Slide gearmotor 12 V worm, self-locking | e.g. 12 V 50-80 rpm worm gearmotor, ~10 Nm, hex-ended shaft | 1 | 65.0 | 65.0 | estimate | 5840-class / wiper-style 12 V worm gearmotor ~A$45-80 delivered; no AU stockist of a ~10 Nm self-locking unit found (eBay AU / AliExpress; check rated (not stall) torque) |  |  | 2.6 | proposed | 7 | M2 - rear cross-member; manual 8 mm hex override
visor | HTD 5M belts, pulleys and cross shaft | HTD 5M 15 mm belt x2, 4 pulleys, 12 mm shaft + 2 pillow blocks | 1 | 200.0 | 200.0 | estimate | 2 x HTD 1500-5M-15 belts ~A$25, 4 x HTD5M 15 mm pulleys 12 mm bore ~A$20-30, 12 mm shaft ~A$30, 2 pillow blocks ~A$10 (Maker Store / Miniature Bearings / AliExpress) |  |  | 1.2 | proposed | 7 | one shaft drives both carriages so the panel can't rack
visor | Tilt drive, worm rotary actuator 12 V | e.g. slewing-drive / worm rotary actuator, >= 40 Nm, self-locking | 2 | 140.0 | 280.0 | estimate | 12 V worm rotary actuator / small slewing drive 40-60 Nm ~US$70-110 on AliExpress; no AU listing found (AliExpress; at ~1.52 AUD/USD, plus A$15-30 shipping; industrial slewing drives A$300+) |  |  | 1.4 | proposed | 7 | M3, M4 at the hinge-beam ends; hard stop at 22 deg
visor | Solenoid latch 12 V, spring-locked | fail-locked (power to release) bolt latch, IP65 | 2 | 14.3 | 28.6 | actual | https://core-electronics.com.au/electric-solenoid-lock.html (Core Electronics; DFRobot FIT0620, A$13.00 ex GST; fail-locked but not IP-rated (needs a boot); max ~5 s energised) | 2026-10-20 |  | 0.2 | proposed | 7 | Y1, Y2 - pins into the front stow brackets
visor | Limit switches | IP67 roller-lever micro switch, NO | 4 | 15.0 | 60.0 | estimate | IP67 sealed roller-lever micro switch (Omron D2VW / Honeywell class) ~A$10-25 at RS / element14 AU (RS / element14 AU) |  |  | 0.05 | proposed | 7 | B1 stowed, B2 deployed, B3 tilt 0, B4 tilt 21 deg
visor | Visor controller | 12 V PLC / micro-controller (e.g. Controllino MINI) + 2 x dual H-bridge (e.g. Cytron MDD20A) in an IP66 box | 1 | 470.0 | 470.0 | estimate | Controllino MINI ~A$327 inc GST (RS AU listing, page not confirmed) + 2 x Cytron MDD20A ~A$45 + IP66 enclosure ~A$45 + buzzer ~A$5 (RS Australia / Cytron; a cheaper 12 V PLC could save ~A$150) |  | 200x150x80 | 1.0 | proposed | 7 | U11 - sequence and interlocks per sheet E9; buzzer BZ1 on the lid
visor | Visor deploy / stow button | momentary ON-OFF-ON rocker with LED (e.g. Carling / Blue Sea Contura) | 1 | 40.0 | 40.0 | estimate | Illuminated momentary (ON)-OFF-(ON) Carling V-series / Blue Sea Contura ~A$35-45 in AU (e.g. Blue Sea 8234 / 7944, Carling VLD2A60B) |  |  | 0.05 | proposed | 7 | S3 - rear panel
visor | Cable chain for the visor PV and motor leads | igus E2.15 chain ~1400 mm + high-flex 4 mm2 solar cable | 1 | 150.0 | 150.0 | estimate | igus E2.15 ~EUR33/m: 1.4 m + brackets ~A$130, plus 4 m of 4 mm2 high-flex solar cable ~A$25 (igus / TME; at ~1.65 AUD/EUR, plus shipping) |  |  | 0.6 | proposed | 7 | beside the left rail; PVV 4 mm2 + tilt/latch/limit leads
visor | Visor hardware | hinge beam (RHS 50x25), hinge arms, hard-stop blocks, bumper, straps | 1 |  | 0 | in materials | raw material priced in the cost summary (cut list) |  |  | 2.0 | fabricated | 7 | see cut list
protection | ATC 20 A blade (FB1 way 10) | ATC 20 A | 1 | 1.5 | 1.5 | estimate | 20 A ATC blade fuse ~A$1-2 |  |  | 0 | proposed | 7 | VIS - visor drive feed
solar | MPPT visor panel (U13) | Victron SmartSolar MPPT 100/20 | 1 | 165.0 | 165.0 | estimate | estimate: AU sale prices ~A$150-180 (RRP ~A$240) |  | 100x113x40 | 0.6 | proposed | 7 | v0.13: visor on its own charger - its panel voltage need not match PV1/PV2
AC | Main switch 2-pole 32 A (Q0, inverter supply) | DIN 2-pole isolator 32 A in the RCBO enclosure | 1 | 30.0 | 30.0 | estimate | estimate: 2-pole DIN isolator ~A$20-40 |  |  |  | proposed | 4 | v0.13: AS/NZS 3001.2 main switch for the inverter output, in the RCBO enclosure's spare way
wiring | Split corrugated conduit NW48 (12 V, outside) | black PA split conduit ~50 mm ID, UV / heat rated | 4 | 14.0 | 56.0 | estimate | estimate: ~A$10-18/m |  |  |  | proposed | 1 | R15, R17: wall cavity, under the floor, rail to the gap
wiring | Split corrugated conduit 25-40 mm (12 V branches) | black PA split conduit, assorted | 6 | 6.0 | 36.0 | estimate | estimate: ~A$4-8/m |  |  |  | proposed | 1:4,2:1,5:1 | R18-R21, R23, R25 (cabin, engine bay, gap and cab-back risers)
wiring | Orange corrugated conduit 25 mm (230 V, outside) | heavy-duty orange corrugated conduit 25 mm | 4 | 3.5 | 14.0 | estimate | estimate: ~A$2-5/m |  |  |  | proposed | 4 | R14, R16, R22: the 230 V cables segregated from 12 V
wiring | Rubber-lined P-clips + M6 rivnuts | stainless P-clips 25-55 mm with EPDM lining, M6 steel rivnuts | 45 | 2.2 | 99.0 | estimate | estimate: ~A$1.5-3 each |  |  |  | proposed | 1:35,4:10 | every 300 mm on the rail and risers; rivnuts into the rail web, no welding or drilling the flanges
wiring | Grommets and tie mounts | floor grommet, junction-box glands, end-member grommets, adhesive tie mounts, ties | 1 | 60.0 | 60.0 | estimate | estimate |  |  |  | proposed | 1 | cabin floor, junction box (230 V / 12 V sides), platform end member, wall channel
wiring | Spiral wrap, UV stable (tent harnesses) | black spiral wrap 20-25 mm | 4 | 4.0 | 16.0 | estimate | estimate: ~A$3-5/m |  |  |  | proposed | 4 | T1A / T1D
wiring | Stick-on cable clamps (cab back riser) | VHB-backed cable clamps for 32 mm conduit | 6 | 3.0 | 18.0 | estimate | estimate |  |  |  | proposed | 2 | R25 up the back of the cab
slides | Chain separator | igus E2.15 separators (230 V / 12 V) | 4 | 4.0 | 16.0 | estimate | estimate |  |  |  | proposed | 3 | AC3 and DO2 kept apart in the chain
cold weather | Battery temperature sensor (TT1) | Victron temperature sensor for BMV-712 / SmartShunt (ASS000100000) | 1 | 45.2 | 45.2 | actual | https://www.solar4rvs.com.au/products/victron-temperature-sensor-smart-shunt-bmv-712 (Solar4RVs; sale price, was A$59.40; Frankie's Auto Electrics A$43.19) | 2026-10-23 | M10 ring lug | 0.05 | proposed | 1 | v0.14: TS1 - lug on battery 1 + post under the MRBF (M10 lug on the M8 post with a washer), red to SmartShunt V+, black to Aux; replaces the Vbatt+ lead. DVCC shared temperature sense; chargers' low-temp cut-off +3 C
cold weather | Battery heater pads 50 W (HP1/HP2) | 12 V 50 W silicone heater pad ~175 x 215, self-adhesive, with bonded 50 C NC thermal cut-out | 2 | 35.0 | 70.0 | estimate | made-to-size 12 V silicone pads ~A$25-45 each (UK Wolverine 50 W 3400051 GBP 77 is the branded option) |  | 175x215x1.5 | 0.1 | proposed | 1 | v0.14: one on each battery's facing side, between the cage straps; 0.13 W/cm2; confirm with iTechworld the case tolerates 50 C locally
cold weather | Battery heater control (TH1) | 12 V digital thermostat with NTC probe + 30 A automotive relay + IP65 box 60 x 22 x 64 | 1 | 55.0 | 55.0 | estimate | thermostat module ~A$15-25 + relay/base ~A$15 + small IP65 box ~A$15 |  | 22x60x64 | 0.25 | proposed | 1 | v0.14: ON below +3 C, OFF above +8 C; probe (HTS) on battery 2's lid face; sits on the rear foam behind the batteries
cold weather | Battery bay insulation | Closed-cell foil-faced foam: 20 mm (rear), 15 mm (inboard), 6 mm (top, on the lid), 4 mm (front, outer) | 1 | 60.0 | 60.0 | estimate | closed-cell foam / foil-faced XPE sheets ~A$40-70 for the set |  | see model | 0.53 | proposed | 1 | v0.14: rear 242-262 x, notched for the pad leads; nothing above or below the batteries (no room)
cold weather | Inline ATC fuse holders (F18 battery heater 10 A) | weatherproof inline ATC + 10 A blade | 1 | 11.5 | 11.5 | actual | https://maxiparts.com.au/ELN5440610-weatherproof-ats-blade-fuse-holder-bulk (Maxiparts; Narva 54406BL single) + ATC blade ~A$1.5 | 2026-10-20 |  | 0.03 | proposed | 1 | v0.14: HTR on BB3 stud 4 (after QS1)
cold weather | Water can jacket | Closed-cell foam jacket, fabric covered: 30 mm top (grooved over the tent under-rail), 18-20 mm sides and closed end, cap end open | 1 | 80.0 | 80.0 | estimate | DIY: closed-cell foam ~A$35 + canvas/Cordura cover ~A$45 |  | 380x880x183 | 0.6 | proposed | 6 | v0.14: sits over the can straps; 3 mm under the tent base
cold weather | Water can heater pad 50 W (HP3) | 12 V 50 W silicone pad ~160 x 735 with bonded 45 C NC cut-out, on 3 mm closed-cell foam | 1 | 45.0 | 45.0 | estimate | made-to-size 12 V silicone pad ~A$35-50 + foam strip |  | 160x735x1.5 | 0.15 | proposed | 6 | v0.14: between cross-bars 0 and 1, under the can
cold weather | Water heater control (TH2 + F19 + XW) | 12 V thermostat + relay, inline ATC 5 A, Deutsch DT 4-pin plug pair | 1 | 45.0 | 45.0 | estimate | thermostat ~A$20 + ATC holder ~A$11 + DT 4-pin kit ~A$15 |  |  | 0.15 | proposed | 6 | v0.14: inside the tent services box, from X5's 12 V (T1D / DO5); WHT lead unplugs at XW when the tent comes off
