Kieran-who/kia-tasman-fitout/docs/measurements/measurements.csv

id | section | measure | how | model assumes | param | value label | your value | notes
T1 | 1 Tub: floor, walls and tailgate | Floor length on the centreline | FROM the inside face of the closed tailgate TO the X0 straight edge on the front wall, along the centreline tape at rib-top height (laser: back of the laser on the tailgate). Your laser photo read 1.508 m: say where the laser's back was | 1512 | TUB_L | mm
T2 | 1 Tub: floor, walls and tailgate | Floor length beside the arches | Rear end of each arch → tailgate inside face, 50 mm in from the side wall | 652 | TL − ARCH_L | Driver
T2 | 1 Tub: floor, walls and tailgate | Floor length beside the arches | Rear end of each arch → tailgate inside face, 50 mm in from the side wall | 652 | TL − ARCH_L | Passenger
T3 | 1 Tub: floor, walls and tailgate | Width wall to wall behind the arches | FROM the passenger wall TO the driver wall, square across at X ≈ 1000 (between the arch and the rib), on the flat of the liner: at the floor, 270 high, and just under the lid rail | 1572 | TUB_W | Floor
T3 | 1 Tub: floor, walls and tailgate | Width wall to wall behind the arches | FROM the passenger wall TO the driver wall, square across at X ≈ 1000 (between the arch and the rib), on the flat of the liner: at the floor, 270 high, and just under the lid rail | 1572 | TUB_W | 270 high
T3 | 1 Tub: floor, walls and tailgate | Width wall to wall behind the arches | FROM the passenger wall TO the driver wall, square across at X ≈ 1000 (between the arch and the rib), on the flat of the liner: at the floor, 270 high, and just under the lid rail | 1572 | TUB_W | Rail
T4 | 1 Tub: floor, walls and tailgate | Width at the tailgate | FROM housing face TO housing face (between the two tail-light housings, C1/C2) at X ≈ 1460; and wall to wall just forward of the housings | 1572 | TUB_W | Housings
T4 | 1 Tub: floor, walls and tailgate | Width at the tailgate | FROM housing face TO housing face (between the two tail-light housings, C1/C2) at X ≈ 1460; and wall to wall just forward of the housings | 1572 | TUB_W | Walls fwd
T5 | 1 Tub: floor, walls and tailgate | Width above the arches at the front | Wall to wall at X ≈ 50, just above arch height and at rail height | 1572 | TUB_W | Above arch
T5 | 1 Tub: floor, walls and tailgate | Width above the arches at the front | Wall to wall at X ≈ 50, just above arch height and at rail height | 1572 | TUB_W | Rail
T6 | 1 Tub: floor, walls and tailgate | Tub depth | Rib top → top of the tub rail (inside edge), at each corner | 540 | TUB_D | Front D
T6 | 1 Tub: floor, walls and tailgate | Tub depth | Rib top → top of the tub rail (inside edge), at each corner | 540 | TUB_D | Front P
T6 | 1 Tub: floor, walls and tailgate | Tub depth | Rib top → top of the tub rail (inside edge), at each corner | 540 | TUB_D | Rear D
T6 | 1 Tub: floor, walls and tailgate | Tub depth | Rib top → top of the tub rail (inside edge), at each corner | 540 | TUB_D | Rear P
T7 | 1 Tub: floor, walls and tailgate | Front wall lean | Level held vertical against the front wall: gap at rail height (+ = wall leans back) | 0 | - | mm
T8 | 1 Tub: floor, walls and tailgate | Side wall lean | Same on each side wall behind the arch (+ = tub wider at the top) | 0 | - | Driver
T8 | 1 Tub: floor, walls and tailgate | Side wall lean | Same on each side wall behind the arch (+ = tub wider at the top) | 0 | - | Passenger
T9 | 1 Tub: floor, walls and tailgate | Corner radii | Floor-to-wall radius, and the radius in the front corners (vertical) | – | - | Floor/wall
T9 | 1 Tub: floor, walls and tailgate | Corner radii | Floor-to-wall radius, and the radius in the front corners (vertical) | – | - | Front corners
T10 | 1 Tub: floor, walls and tailgate | Floor ribs (detail a) | Rib height above the valleys, rib top width, pitch, how many, Y of the middle rib, X where they start and end | 14 / 45 / 100 | RIB_H, RIB_W, RIB_PITCH | Height
T10 | 1 Tub: floor, walls and tailgate | Floor ribs (detail a) | Rib height above the valleys, rib top width, pitch, how many, Y of the middle rib, X where they start and end | 14 / 45 / 100 | RIB_H, RIB_W, RIB_PITCH | Top width
T10 | 1 Tub: floor, walls and tailgate | Floor ribs (detail a) | Rib height above the valleys, rib top width, pitch, how many, Y of the middle rib, X where they start and end | 14 / 45 / 100 | RIB_H, RIB_W, RIB_PITCH | Pitch
T10 | 1 Tub: floor, walls and tailgate | Floor ribs (detail a) | Rib height above the valleys, rib top width, pitch, how many, Y of the middle rib, X where they start and end | 14 / 45 / 100 | RIB_H, RIB_W, RIB_PITCH | Count
T10 | 1 Tub: floor, walls and tailgate | Floor ribs (detail a) | Rib height above the valleys, rib top width, pitch, how many, Y of the middle rib, X where they start and end | 14 / 45 / 100 | RIB_H, RIB_W, RIB_PITCH | Mid rib Y
T10 | 1 Tub: floor, walls and tailgate | Floor ribs (detail a) | Rib height above the valleys, rib top width, pitch, how many, Y of the middle rib, X where they start and end | 14 / 45 / 100 | RIB_H, RIB_W, RIB_PITCH | Start X
T10 | 1 Tub: floor, walls and tailgate | Floor ribs (detail a) | Rib height above the valleys, rib top width, pitch, how many, Y of the middle rib, X where they start and end | 14 / 45 / 100 | RIB_H, RIB_W, RIB_PITCH | End X
T11 | 1 Tub: floor, walls and tailgate | Liner thickness (detail f) | Calipers on an exposed liner edge (rail lip or tailgate gap) | 8 | LINER_ALLOW | mm
T12 | 1 Tub: floor, walls and tailgate | Liner type | Drop-in or spray-in? How is it fixed? Can it come out to bolt through the floor? | drop-in | - | notes
T13 | 1 Tub: floor, walls and tailgate | Tub rail cap (detail f) | Width of the rail's flat top, how far its inside lip overhangs the wall, lip depth | – | - | Cap width
T13 | 1 Tub: floor, walls and tailgate | Tub rail cap (detail f) | Width of the rail's flat top, how far its inside lip overhangs the wall, lip depth | – | - | Lip overhang
T13 | 1 Tub: floor, walls and tailgate | Tub rail cap (detail f) | Width of the rail's flat top, how far its inside lip overhangs the wall, lip depth | – | - | Lip depth
T14 | 1 Tub: floor, walls and tailgate | Tailgate inner panel | Thickness inside face → outer skin at mid-height; note any handles or bulges facing the tub | 60 | TAILGATE_T | Thickness
T14 | 1 Tub: floor, walls and tailgate | Tailgate inner panel | Thickness inside face → outer skin at mid-height; note any handles or bulges facing the tub | 60 | TAILGATE_T | Bulges?
T15 | 1 Tub: floor, walls and tailgate | Tailgate opening | Clear width between the latch pillars at the floor and at the top; height of the closed tailgate top above the floor | – / 525 | TAILGATE_H | Width floor
T15 | 1 Tub: floor, walls and tailgate | Tailgate opening | Clear width between the latch pillars at the floor and at the top; height of the closed tailgate top above the floor | – / 525 | TAILGATE_H | Width top
T15 | 1 Tub: floor, walls and tailgate | Tailgate opening | Clear width between the latch pillars at the floor and at the top; height of the closed tailgate top above the floor | – / 525 | TAILGATE_H | Height
T16 | 1 Tub: floor, walls and tailgate | Tailgate open | Tailgate down: its top surface vs the tub floor (+ above / − below), its length from the hinge, the cable stay rating | – | - | Height diff
T16 | 1 Tub: floor, walls and tailgate | Tailgate open | Tailgate down: its top surface vs the tub floor (+ above / − below), its length from the hinge, the cable stay rating | – | - | Length
T16 | 1 Tub: floor, walls and tailgate | Tailgate open | Tailgate down: its top surface vs the tub floor (+ above / − below), its length from the hinge, the cable stay rating | – | - | Rating kg
T17 | 1 Tub: floor, walls and tailgate | Holes in the floor | X, Y of any drain holes or existing bolt holes (lift the liner if it's drop-in) | – | - | notes
W1 | 2 Wheel arches | Arch start | Gap from the front wall to the front of each arch at the floor and at the top (0 if they meet) | 0 | - | D floor
W1 | 2 Wheel arches | Arch start | Gap from the front wall to the front of each arch at the floor and at the top (0 if they meet) | 0 | - | D top
W1 | 2 Wheel arches | Arch start | Gap from the front wall to the front of each arch at the floor and at the top (0 if they meet) | 0 | - | P floor
W1 | 2 Wheel arches | Arch start | Gap from the front wall to the front of each arch at the floor and at the top (0 if they meet) | 0 | - | P top
W2 | 2 Wheel arches | Arch length | Front → rear end of each arch along its inner face, at the floor and at the top | 860 | ARCH_L | D floor
W2 | 2 Wheel arches | Arch length | Front → rear end of each arch along its inner face, at the floor and at the top | 860 | ARCH_L | D top
W2 | 2 Wheel arches | Arch length | Front → rear end of each arch along its inner face, at the floor and at the top | 860 | ARCH_L | P floor
W2 | 2 Wheel arches | Arch length | Front → rear end of each arch along its inner face, at the floor and at the top | 860 | ARCH_L | P top
W3 | 2 Wheel arches | Arch height | Rib top → top of each arch at the front, middle and rear of its flat top | 290 | ARCH_H | D front
W3 | 2 Wheel arches | Arch height | Rib top → top of each arch at the front, middle and rear of its flat top | 290 | ARCH_H | D mid
W3 | 2 Wheel arches | Arch height | Rib top → top of each arch at the front, middle and rear of its flat top | 290 | ARCH_H | D rear
W3 | 2 Wheel arches | Arch height | Rib top → top of each arch at the front, middle and rear of its flat top | 290 | ARCH_H | P front
W3 | 2 Wheel arches | Arch height | Rib top → top of each arch at the front, middle and rear of its flat top | 290 | ARCH_H | P mid
W3 | 2 Wheel arches | Arch height | Rib top → top of each arch at the front, middle and rear of its flat top | 290 | ARCH_H | P rear
W4 | 2 Wheel arches | Width between the arches (floor) | FROM the inner face of the passenger arch TO the inner face of the driver arch, square across just above the floor, at X ≈ 100, 430 and 760 (photo P1) | 1170 | ARCH_GAP | Front
W4 | 2 Wheel arches | Width between the arches (floor) | FROM the inner face of the passenger arch TO the inner face of the driver arch, square across just above the floor, at X ≈ 100, 430 and 760 (photo P1) | 1170 | ARCH_GAP | Mid
W4 | 2 Wheel arches | Width between the arches (floor) | FROM the inner face of the passenger arch TO the inner face of the driver arch, square across just above the floor, at X ≈ 100, 430 and 760 (photo P1) | 1170 | ARCH_GAP | Rear
W5 | 2 Wheel arches | Width between the arches (top) | Same three positions, just below the top radius | 1170 | ARCH_GAP | Front
W5 | 2 Wheel arches | Width between the arches (top) | Same three positions, just below the top radius | 1170 | ARCH_GAP | Mid
W5 | 2 Wheel arches | Width between the arches (top) | Same three positions, just below the top radius | 1170 | ARCH_GAP | Rear
W6 | 2 Wheel arches | Arch intrusion | Side wall face → arch inner face at mid-length | 201 | ARCH_IN | Driver
W6 | 2 Wheel arches | Arch intrusion | Side wall face → arch inner face at mid-length | 201 | ARCH_IN | Passenger
W7 | 2 Wheel arches | Arch top shape | Flat width of the top (wall → start of the radius) and the radius on its inboard edge | – / 70 | ARCH_R | D flat
W7 | 2 Wheel arches | Arch top shape | Flat width of the top (wall → start of the radius) and the radius on its inboard edge | – / 70 | ARCH_R | D radius
W7 | 2 Wheel arches | Arch top shape | Flat width of the top (wall → start of the radius) and the radius on its inboard edge | – / 70 | ARCH_R | P flat
W7 | 2 Wheel arches | Arch top shape | Flat width of the top (wall → start of the radius) and the radius on its inboard edge | – / 70 | ARCH_R | P radius
W8 | 2 Wheel arches | Arch rear end | Vertical, sloped or curved? How far the top's rear edge sits forward of the floor's rear edge | vertical | - | Driver
W8 | 2 Wheel arches | Arch rear end | Vertical, sloped or curved? How far the top's rear edge sits forward of the floor's rear edge | vertical | - | Passenger
W9 | 2 Wheel arches | Arch well (detail e) | The recess in each arch face: X of its front and rear edges, Z of its bottom and top, depth | 620–780 / 195–245 / 35 | ARCH_POCKET | D x0
W9 | 2 Wheel arches | Arch well (detail e) | The recess in each arch face: X of its front and rear edges, Z of its bottom and top, depth | 620–780 / 195–245 / 35 | ARCH_POCKET | D x1
W9 | 2 Wheel arches | Arch well (detail e) | The recess in each arch face: X of its front and rear edges, Z of its bottom and top, depth | 620–780 / 195–245 / 35 | ARCH_POCKET | D z0
W9 | 2 Wheel arches | Arch well (detail e) | The recess in each arch face: X of its front and rear edges, Z of its bottom and top, depth | 620–780 / 195–245 / 35 | ARCH_POCKET | D z1
W9 | 2 Wheel arches | Arch well (detail e) | The recess in each arch face: X of its front and rear edges, Z of its bottom and top, depth | 620–780 / 195–245 / 35 | ARCH_POCKET | D depth
W9 | 2 Wheel arches | Arch well (detail e) | The recess in each arch face: X of its front and rear edges, Z of its bottom and top, depth | 620–780 / 195–245 / 35 | ARCH_POCKET | P x0
W9 | 2 Wheel arches | Arch well (detail e) | The recess in each arch face: X of its front and rear edges, Z of its bottom and top, depth | 620–780 / 195–245 / 35 | ARCH_POCKET | P x1
W9 | 2 Wheel arches | Arch well (detail e) | The recess in each arch face: X of its front and rear edges, Z of its bottom and top, depth | 620–780 / 195–245 / 35 | ARCH_POCKET | P z0
W9 | 2 Wheel arches | Arch well (detail e) | The recess in each arch face: X of its front and rear edges, Z of its bottom and top, depth | 620–780 / 195–245 / 35 | ARCH_POCKET | P z1
W9 | 2 Wheel arches | Arch well (detail e) | The recess in each arch face: X of its front and rear edges, Z of its bottom and top, depth | 620–780 / 195–245 / 35 | ARCH_POCKET | P depth
W10 | 2 Wheel arches | Space above the arch | Arch top → underside of the closed Load-Lid (lowest part of its frame), front and rear of each arch | 258 | UNDER_LID_Z − ARCH_H | D front
W10 | 2 Wheel arches | Space above the arch | Arch top → underside of the closed Load-Lid (lowest part of its frame), front and rear of each arch | 258 | UNDER_LID_Z − ARCH_H | D rear
W10 | 2 Wheel arches | Space above the arch | Arch top → underside of the closed Load-Lid (lowest part of its frame), front and rear of each arch | 258 | UNDER_LID_Z − ARCH_H | P front
W10 | 2 Wheel arches | Space above the arch | Arch top → underside of the closed Load-Lid (lowest part of its frame), front and rear of each arch | 258 | UNDER_LID_Z − ARCH_H | P rear
F1 | 3 Factory fittings in the tub | Factory 240 V outlet (detail d) | Centre X from the front wall, centre Z above the floor, housing width × height, how far it stands proud | 1330 / 400 | FACTORY_OUTLET | X
F1 | 3 Factory fittings in the tub | Factory 240 V outlet (detail d) | Centre X from the front wall, centre Z above the floor, housing width × height, how far it stands proud | 1330 / 400 | FACTORY_OUTLET | Z
F1 | 3 Factory fittings in the tub | Factory 240 V outlet (detail d) | Centre X from the front wall, centre Z above the floor, housing width × height, how far it stands proud | 1330 / 400 | FACTORY_OUTLET | W
F1 | 3 Factory fittings in the tub | Factory 240 V outlet (detail d) | Centre X from the front wall, centre Z above the floor, housing width × height, how far it stands proud | 1330 / 400 | FACTORY_OUTLET | H
F1 | 3 Factory fittings in the tub | Factory 240 V outlet (detail d) | Centre X from the front wall, centre Z above the floor, housing width × height, how far it stands proud | 1330 / 400 | FACTORY_OUTLET | Proud
F2 | 3 Factory fittings in the tub | Behind the outlet | With the outlet removed: hole size in the steel, cavity depth behind (model: 49 mm between liner and skin), and the way out at the cavity bottom for a 50 mm and a 25 mm conduit (routes R14 / R15, sheet E12) | – / 49 | - | Hole W
F2 | 3 Factory fittings in the tub | Behind the outlet | With the outlet removed: hole size in the steel, cavity depth behind (model: 49 mm between liner and skin), and the way out at the cavity bottom for a 50 mm and a 25 mm conduit (routes R14 / R15, sheet E12) | – / 49 | - | Hole H
F2 | 3 Factory fittings in the tub | Behind the outlet | With the outlet removed: hole size in the steel, cavity depth behind (model: 49 mm between liner and skin), and the way out at the cavity bottom for a 50 mm and a 25 mm conduit (routes R14 / R15, sheet E12) | – / 49 | - | Cavity
F2 | 3 Factory fittings in the tub | Behind the outlet | With the outlet removed: hole size in the steel, cavity depth behind (model: 49 mm between liner and skin), and the way out at the cavity bottom for a 50 mm and a 25 mm conduit (routes R14 / R15, sheet E12) | – / 49 | - | Exit
F3 | 3 Factory fittings in the tub | Tie-down points | Every tie-down or rail: wall, X, Z, type and how far it stands proud | none on the arches | - | notes
F4 | 3 Factory fittings in the tub | Other protrusions | Bolt heads, cleats, liner bosses, light: position and how far they stand proud | – | - | notes
C1 | 3b Rear corners: tail-light housings (added 2026-10-25; photo pages P1-P5) | Tail-light housing, driver | FROM X0 TO the housing's front face where it leaves the side wall (red line on P2, mirrored), and TO where it meets the tailgate seal. How far it comes in: straight edge flat on the side wall forward of it, measure square to the housing face, at the floor, 270 high and under the rail. Z of its bottom and top | 1332 / in 80 (photo est) | TAIL_BULGE_L, TAIL_BULGE_IN | X start
C1 | 3b Rear corners: tail-light housings (added 2026-10-25; photo pages P1-P5) | Tail-light housing, driver | FROM X0 TO the housing's front face where it leaves the side wall (red line on P2, mirrored), and TO where it meets the tailgate seal. How far it comes in: straight edge flat on the side wall forward of it, measure square to the housing face, at the floor, 270 high and under the rail. Z of its bottom and top | 1332 / in 80 (photo est) | TAIL_BULGE_L, TAIL_BULGE_IN | X end
C1 | 3b Rear corners: tail-light housings (added 2026-10-25; photo pages P1-P5) | Tail-light housing, driver | FROM X0 TO the housing's front face where it leaves the side wall (red line on P2, mirrored), and TO where it meets the tailgate seal. How far it comes in: straight edge flat on the side wall forward of it, measure square to the housing face, at the floor, 270 high and under the rail. Z of its bottom and top | 1332 / in 80 (photo est) | TAIL_BULGE_L, TAIL_BULGE_IN | In floor
C1 | 3b Rear corners: tail-light housings (added 2026-10-25; photo pages P1-P5) | Tail-light housing, driver | FROM X0 TO the housing's front face where it leaves the side wall (red line on P2, mirrored), and TO where it meets the tailgate seal. How far it comes in: straight edge flat on the side wall forward of it, measure square to the housing face, at the floor, 270 high and under the rail. Z of its bottom and top | 1332 / in 80 (photo est) | TAIL_BULGE_L, TAIL_BULGE_IN | In 270
C1 | 3b Rear corners: tail-light housings (added 2026-10-25; photo pages P1-P5) | Tail-light housing, driver | FROM X0 TO the housing's front face where it leaves the side wall (red line on P2, mirrored), and TO where it meets the tailgate seal. How far it comes in: straight edge flat on the side wall forward of it, measure square to the housing face, at the floor, 270 high and under the rail. Z of its bottom and top | 1332 / in 80 (photo est) | TAIL_BULGE_L, TAIL_BULGE_IN | In rail
C1 | 3b Rear corners: tail-light housings (added 2026-10-25; photo pages P1-P5) | Tail-light housing, driver | FROM X0 TO the housing's front face where it leaves the side wall (red line on P2, mirrored), and TO where it meets the tailgate seal. How far it comes in: straight edge flat on the side wall forward of it, measure square to the housing face, at the floor, 270 high and under the rail. Z of its bottom and top | 1332 / in 80 (photo est) | TAIL_BULGE_L, TAIL_BULGE_IN | Z bottom
C1 | 3b Rear corners: tail-light housings (added 2026-10-25; photo pages P1-P5) | Tail-light housing, driver | FROM X0 TO the housing's front face where it leaves the side wall (red line on P2, mirrored), and TO where it meets the tailgate seal. How far it comes in: straight edge flat on the side wall forward of it, measure square to the housing face, at the floor, 270 high and under the rail. Z of its bottom and top | 1332 / in 80 (photo est) | TAIL_BULGE_L, TAIL_BULGE_IN | Z top
C2 | 3b Rear corners: tail-light housings (added 2026-10-25; photo pages P1-P5) | Tail-light housing, passenger | Same as C1 on the passenger (outlet) side: photo P2 | 1332 / in 80 (photo est) | TAIL_BULGE_L, TAIL_BULGE_IN | X start
C2 | 3b Rear corners: tail-light housings (added 2026-10-25; photo pages P1-P5) | Tail-light housing, passenger | Same as C1 on the passenger (outlet) side: photo P2 | 1332 / in 80 (photo est) | TAIL_BULGE_L, TAIL_BULGE_IN | X end
C2 | 3b Rear corners: tail-light housings (added 2026-10-25; photo pages P1-P5) | Tail-light housing, passenger | Same as C1 on the passenger (outlet) side: photo P2 | 1332 / in 80 (photo est) | TAIL_BULGE_L, TAIL_BULGE_IN | In floor
C2 | 3b Rear corners: tail-light housings (added 2026-10-25; photo pages P1-P5) | Tail-light housing, passenger | Same as C1 on the passenger (outlet) side: photo P2 | 1332 / in 80 (photo est) | TAIL_BULGE_L, TAIL_BULGE_IN | In 270
C2 | 3b Rear corners: tail-light housings (added 2026-10-25; photo pages P1-P5) | Tail-light housing, passenger | Same as C1 on the passenger (outlet) side: photo P2 | 1332 / in 80 (photo est) | TAIL_BULGE_L, TAIL_BULGE_IN | In rail
C2 | 3b Rear corners: tail-light housings (added 2026-10-25; photo pages P1-P5) | Tail-light housing, passenger | Same as C1 on the passenger (outlet) side: photo P2 | 1332 / in 80 (photo est) | TAIL_BULGE_L, TAIL_BULGE_IN | Z bottom
C2 | 3b Rear corners: tail-light housings (added 2026-10-25; photo pages P1-P5) | Tail-light housing, passenger | Same as C1 on the passenger (outlet) side: photo P2 | 1332 / in 80 (photo est) | TAIL_BULGE_L, TAIL_BULGE_IN | Z top
C3 | 3b Rear corners: tail-light housings (added 2026-10-25; photo pages P1-P5) | Housing shape | Flat or curved face? Square, sloped or rounded front edge (sketch it)? Any lip where it meets the wall? Same both sides? | – | - | notes
C4 | 3b Rear corners: tail-light housings (added 2026-10-25; photo pages P1-P5) | Access plugs | Each push-rivet plug or cap on the housings: X, Z, diameter, what's behind it (lamp bolts, globe, wiring) and how much hand room it needs. Anything built here must leave these reachable | – | - | D X
C4 | 3b Rear corners: tail-light housings (added 2026-10-25; photo pages P1-P5) | Access plugs | Each push-rivet plug or cap on the housings: X, Z, diameter, what's behind it (lamp bolts, globe, wiring) and how much hand room it needs. Anything built here must leave these reachable | – | - | D Z
C4 | 3b Rear corners: tail-light housings (added 2026-10-25; photo pages P1-P5) | Access plugs | Each push-rivet plug or cap on the housings: X, Z, diameter, what's behind it (lamp bolts, globe, wiring) and how much hand room it needs. Anything built here must leave these reachable | – | - | D dia
C4 | 3b Rear corners: tail-light housings (added 2026-10-25; photo pages P1-P5) | Access plugs | Each push-rivet plug or cap on the housings: X, Z, diameter, what's behind it (lamp bolts, globe, wiring) and how much hand room it needs. Anything built here must leave these reachable | – | - | P X
C4 | 3b Rear corners: tail-light housings (added 2026-10-25; photo pages P1-P5) | Access plugs | Each push-rivet plug or cap on the housings: X, Z, diameter, what's behind it (lamp bolts, globe, wiring) and how much hand room it needs. Anything built here must leave these reachable | – | - | P Z
C4 | 3b Rear corners: tail-light housings (added 2026-10-25; photo pages P1-P5) | Access plugs | Each push-rivet plug or cap on the housings: X, Z, diameter, what's behind it (lamp bolts, globe, wiring) and how much hand room it needs. Anything built here must leave these reachable | – | - | P dia
C4 | 3b Rear corners: tail-light housings (added 2026-10-25; photo pages P1-P5) | Access plugs | Each push-rivet plug or cap on the housings: X, Z, diameter, what's behind it (lamp bolts, globe, wiring) and how much hand room it needs. Anything built here must leave these reachable | – | - | Hand room
C5 | 3b Rear corners: tail-light housings (added 2026-10-25; photo pages P1-P5) | Clear length behind the arch | Rear end of the arch → front face of the tail-light housing, 50 mm in from the side wall, at the floor, 270 high and just below the rail | 652 | TL − ARCH_L | D floor
C5 | 3b Rear corners: tail-light housings (added 2026-10-25; photo pages P1-P5) | Clear length behind the arch | Rear end of the arch → front face of the tail-light housing, 50 mm in from the side wall, at the floor, 270 high and just below the rail | 652 | TL − ARCH_L | D 270
C5 | 3b Rear corners: tail-light housings (added 2026-10-25; photo pages P1-P5) | Clear length behind the arch | Rear end of the arch → front face of the tail-light housing, 50 mm in from the side wall, at the floor, 270 high and just below the rail | 652 | TL − ARCH_L | D rail
C5 | 3b Rear corners: tail-light housings (added 2026-10-25; photo pages P1-P5) | Clear length behind the arch | Rear end of the arch → front face of the tail-light housing, 50 mm in from the side wall, at the floor, 270 high and just below the rail | 652 | TL − ARCH_L | P floor
C5 | 3b Rear corners: tail-light housings (added 2026-10-25; photo pages P1-P5) | Clear length behind the arch | Rear end of the arch → front face of the tail-light housing, 50 mm in from the side wall, at the floor, 270 high and just below the rail | 652 | TL − ARCH_L | P 270
C5 | 3b Rear corners: tail-light housings (added 2026-10-25; photo pages P1-P5) | Clear length behind the arch | Rear end of the arch → front face of the tail-light housing, 50 mm in from the side wall, at the floor, 270 high and just below the rail | 652 | TL − ARCH_L | P rail
C6 | 3b Rear corners: tail-light housings (added 2026-10-25; photo pages P1-P5) | Clear width beside the housing | Inner face of the housing → centreline of the tub at 270 high (shows how much is left outboard of the slides) | 786 | TUB_W / 2 | Driver
C6 | 3b Rear corners: tail-light housings (added 2026-10-25; photo pages P1-P5) | Clear width beside the housing | Inner face of the housing → centreline of the tub at 270 high (shows how much is left outboard of the slides) | 786 | TUB_W / 2 | Passenger
C7 | 3b Rear corners: tail-light housings (added 2026-10-25; photo pages P1-P5) | Rib behind the arch | The vertical pressed rib between the arch and the outlet recess: X of its centre, width, how far it stands proud, full height or not | – | - | D X
C7 | 3b Rear corners: tail-light housings (added 2026-10-25; photo pages P1-P5) | Rib behind the arch | The vertical pressed rib between the arch and the outlet recess: X of its centre, width, how far it stands proud, full height or not | – | - | D width
C7 | 3b Rear corners: tail-light housings (added 2026-10-25; photo pages P1-P5) | Rib behind the arch | The vertical pressed rib between the arch and the outlet recess: X of its centre, width, how far it stands proud, full height or not | – | - | D proud
C7 | 3b Rear corners: tail-light housings (added 2026-10-25; photo pages P1-P5) | Rib behind the arch | The vertical pressed rib between the arch and the outlet recess: X of its centre, width, how far it stands proud, full height or not | – | - | P X
C7 | 3b Rear corners: tail-light housings (added 2026-10-25; photo pages P1-P5) | Rib behind the arch | The vertical pressed rib between the arch and the outlet recess: X of its centre, width, how far it stands proud, full height or not | – | - | P width
C7 | 3b Rear corners: tail-light housings (added 2026-10-25; photo pages P1-P5) | Rib behind the arch | The vertical pressed rib between the arch and the outlet recess: X of its centre, width, how far it stands proud, full height or not | – | - | P proud
C8 | 3b Rear corners: tail-light housings (added 2026-10-25; photo pages P1-P5) | Outlet recess | The recessed panel the factory outlet sits in: X of its front and rear edges, Z of its bottom and top, depth behind the wall face (photo P2: it looks lower and further forward than the model) | photo est X 1190, Z 210 | FACTORY_OUTLET | X front
C8 | 3b Rear corners: tail-light housings (added 2026-10-25; photo pages P1-P5) | Outlet recess | The recessed panel the factory outlet sits in: X of its front and rear edges, Z of its bottom and top, depth behind the wall face (photo P2: it looks lower and further forward than the model) | photo est X 1190, Z 210 | FACTORY_OUTLET | X rear
C8 | 3b Rear corners: tail-light housings (added 2026-10-25; photo pages P1-P5) | Outlet recess | The recessed panel the factory outlet sits in: X of its front and rear edges, Z of its bottom and top, depth behind the wall face (photo P2: it looks lower and further forward than the model) | photo est X 1190, Z 210 | FACTORY_OUTLET | Z bottom
C8 | 3b Rear corners: tail-light housings (added 2026-10-25; photo pages P1-P5) | Outlet recess | The recessed panel the factory outlet sits in: X of its front and rear edges, Z of its bottom and top, depth behind the wall face (photo P2: it looks lower and further forward than the model) | photo est X 1190, Z 210 | FACTORY_OUTLET | Z top
C8 | 3b Rear corners: tail-light housings (added 2026-10-25; photo pages P1-P5) | Outlet recess | The recessed panel the factory outlet sits in: X of its front and rear edges, Z of its bottom and top, depth behind the wall face (photo P2: it looks lower and further forward than the model) | photo est X 1190, Z 210 | FACTORY_OUTLET | Depth
C9 | 3b Rear corners: tail-light housings (added 2026-10-25; photo pages P1-P5) | Arch top profile | Photos show a stepped arch top: X of each step and the height before and after it, each side; how far the rear end slopes | flat at 290 | ARCH_H | notes
C10 | 3b Rear corners: tail-light housings (added 2026-10-25; photo pages P1-P5) | Clear height under the lid hardware | FROM the rib tops (Z0) UP TO the lowest lid part above (skirt, rail, knob or strut), 100 mm in from each side wall, at X ≈ 100, 450, 900, 1250 and 1450. This is the real ceiling for the cabinets and drawers | 548 | UNDER_LID_Z | Driver X100
C10 | 3b Rear corners: tail-light housings (added 2026-10-25; photo pages P1-P5) | Clear height under the lid hardware | FROM the rib tops (Z0) UP TO the lowest lid part above (skirt, rail, knob or strut), 100 mm in from each side wall, at X ≈ 100, 450, 900, 1250 and 1450. This is the real ceiling for the cabinets and drawers | 548 | UNDER_LID_Z | Driver X450
C10 | 3b Rear corners: tail-light housings (added 2026-10-25; photo pages P1-P5) | Clear height under the lid hardware | FROM the rib tops (Z0) UP TO the lowest lid part above (skirt, rail, knob or strut), 100 mm in from each side wall, at X ≈ 100, 450, 900, 1250 and 1450. This is the real ceiling for the cabinets and drawers | 548 | UNDER_LID_Z | Driver X900
C10 | 3b Rear corners: tail-light housings (added 2026-10-25; photo pages P1-P5) | Clear height under the lid hardware | FROM the rib tops (Z0) UP TO the lowest lid part above (skirt, rail, knob or strut), 100 mm in from each side wall, at X ≈ 100, 450, 900, 1250 and 1450. This is the real ceiling for the cabinets and drawers | 548 | UNDER_LID_Z | Driver X1250
C10 | 3b Rear corners: tail-light housings (added 2026-10-25; photo pages P1-P5) | Clear height under the lid hardware | FROM the rib tops (Z0) UP TO the lowest lid part above (skirt, rail, knob or strut), 100 mm in from each side wall, at X ≈ 100, 450, 900, 1250 and 1450. This is the real ceiling for the cabinets and drawers | 548 | UNDER_LID_Z | Driver X1450
C10 | 3b Rear corners: tail-light housings (added 2026-10-25; photo pages P1-P5) | Clear height under the lid hardware | FROM the rib tops (Z0) UP TO the lowest lid part above (skirt, rail, knob or strut), 100 mm in from each side wall, at X ≈ 100, 450, 900, 1250 and 1450. This is the real ceiling for the cabinets and drawers | 548 | UNDER_LID_Z | Passenger X100
C10 | 3b Rear corners: tail-light housings (added 2026-10-25; photo pages P1-P5) | Clear height under the lid hardware | FROM the rib tops (Z0) UP TO the lowest lid part above (skirt, rail, knob or strut), 100 mm in from each side wall, at X ≈ 100, 450, 900, 1250 and 1450. This is the real ceiling for the cabinets and drawers | 548 | UNDER_LID_Z | Passenger X450
C10 | 3b Rear corners: tail-light housings (added 2026-10-25; photo pages P1-P5) | Clear height under the lid hardware | FROM the rib tops (Z0) UP TO the lowest lid part above (skirt, rail, knob or strut), 100 mm in from each side wall, at X ≈ 100, 450, 900, 1250 and 1450. This is the real ceiling for the cabinets and drawers | 548 | UNDER_LID_Z | Passenger X900
C10 | 3b Rear corners: tail-light housings (added 2026-10-25; photo pages P1-P5) | Clear height under the lid hardware | FROM the rib tops (Z0) UP TO the lowest lid part above (skirt, rail, knob or strut), 100 mm in from each side wall, at X ≈ 100, 450, 900, 1250 and 1450. This is the real ceiling for the cabinets and drawers | 548 | UNDER_LID_Z | Passenger X1250
C10 | 3b Rear corners: tail-light housings (added 2026-10-25; photo pages P1-P5) | Clear height under the lid hardware | FROM the rib tops (Z0) UP TO the lowest lid part above (skirt, rail, knob or strut), 100 mm in from each side wall, at X ≈ 100, 450, 900, 1250 and 1450. This is the real ceiling for the cabinets and drawers | 548 | UNDER_LID_Z | Passenger X1450
C11 | 3b Rear corners: tail-light housings (added 2026-10-25; photo pages P1-P5) | Tie-down pocket in each side wall | The C-shaped moulded pocket behind the arch (driver photo): X of its front and rear edges, Z of its bottom and top, depth. Is there a factory hook or loop in it? | – | - | D X0
C11 | 3b Rear corners: tail-light housings (added 2026-10-25; photo pages P1-P5) | Tie-down pocket in each side wall | The C-shaped moulded pocket behind the arch (driver photo): X of its front and rear edges, Z of its bottom and top, depth. Is there a factory hook or loop in it? | – | - | D X1
C11 | 3b Rear corners: tail-light housings (added 2026-10-25; photo pages P1-P5) | Tie-down pocket in each side wall | The C-shaped moulded pocket behind the arch (driver photo): X of its front and rear edges, Z of its bottom and top, depth. Is there a factory hook or loop in it? | – | - | D Z0
C11 | 3b Rear corners: tail-light housings (added 2026-10-25; photo pages P1-P5) | Tie-down pocket in each side wall | The C-shaped moulded pocket behind the arch (driver photo): X of its front and rear edges, Z of its bottom and top, depth. Is there a factory hook or loop in it? | – | - | D Z1
C11 | 3b Rear corners: tail-light housings (added 2026-10-25; photo pages P1-P5) | Tie-down pocket in each side wall | The C-shaped moulded pocket behind the arch (driver photo): X of its front and rear edges, Z of its bottom and top, depth. Is there a factory hook or loop in it? | – | - | D depth
C11 | 3b Rear corners: tail-light housings (added 2026-10-25; photo pages P1-P5) | Tie-down pocket in each side wall | The C-shaped moulded pocket behind the arch (driver photo): X of its front and rear edges, Z of its bottom and top, depth. Is there a factory hook or loop in it? | – | - | P same?
C12 | 3b Rear corners: tail-light housings (added 2026-10-25; photo pages P1-P5) | Wall step (ledge line) | The horizontal step along each side wall (photos P2, P4, P5): Z of the step at the front, over the arch and at the rear; how deep the step is (straight edge on the upper wall, measure in to the lower wall) | – | - | D Z front
C12 | 3b Rear corners: tail-light housings (added 2026-10-25; photo pages P1-P5) | Wall step (ledge line) | The horizontal step along each side wall (photos P2, P4, P5): Z of the step at the front, over the arch and at the rear; how deep the step is (straight edge on the upper wall, measure in to the lower wall) | – | - | D Z rear
C12 | 3b Rear corners: tail-light housings (added 2026-10-25; photo pages P1-P5) | Wall step (ledge line) | The horizontal step along each side wall (photos P2, P4, P5): Z of the step at the front, over the arch and at the rear; how deep the step is (straight edge on the upper wall, measure in to the lower wall) | – | - | D depth
C12 | 3b Rear corners: tail-light housings (added 2026-10-25; photo pages P1-P5) | Wall step (ledge line) | The horizontal step along each side wall (photos P2, P4, P5): Z of the step at the front, over the arch and at the rear; how deep the step is (straight edge on the upper wall, measure in to the lower wall) | – | - | P Z front
C12 | 3b Rear corners: tail-light housings (added 2026-10-25; photo pages P1-P5) | Wall step (ledge line) | The horizontal step along each side wall (photos P2, P4, P5): Z of the step at the front, over the arch and at the rear; how deep the step is (straight edge on the upper wall, measure in to the lower wall) | – | - | P Z rear
C12 | 3b Rear corners: tail-light housings (added 2026-10-25; photo pages P1-P5) | Wall step (ledge line) | The horizontal step along each side wall (photos P2, P4, P5): Z of the step at the front, over the arch and at the rear; how deep the step is (straight edge on the upper wall, measure in to the lower wall) | – | - | P depth
C13 | 3b Rear corners: tail-light housings (added 2026-10-25; photo pages P1-P5) | Notch in each arch top | The triangular notch near the front wall (photos P1, P4, P5): X and Z of its centre, width, depth | – | - | D X
C13 | 3b Rear corners: tail-light housings (added 2026-10-25; photo pages P1-P5) | Notch in each arch top | The triangular notch near the front wall (photos P1, P4, P5): X and Z of its centre, width, depth | – | - | D Z
C13 | 3b Rear corners: tail-light housings (added 2026-10-25; photo pages P1-P5) | Notch in each arch top | The triangular notch near the front wall (photos P1, P4, P5): X and Z of its centre, width, depth | – | - | D w
C13 | 3b Rear corners: tail-light housings (added 2026-10-25; photo pages P1-P5) | Notch in each arch top | The triangular notch near the front wall (photos P1, P4, P5): X and Z of its centre, width, depth | – | - | D depth
C13 | 3b Rear corners: tail-light housings (added 2026-10-25; photo pages P1-P5) | Notch in each arch top | The triangular notch near the front wall (photos P1, P4, P5): X and Z of its centre, width, depth | – | - | P X
C13 | 3b Rear corners: tail-light housings (added 2026-10-25; photo pages P1-P5) | Notch in each arch top | The triangular notch near the front wall (photos P1, P4, P5): X and Z of its centre, width, depth | – | - | P Z
L1 | 4 Load-Lid and Destroyer rails | Lid size | Overall length (along) and width (across) including edge trims | 1600 × 1720 | LID_L, LID_W | Length
L1 | 4 Load-Lid and Destroyer rails | Lid size | Overall length (along) and width (across) including edge trims | 1600 × 1720 | LID_L, LID_W | Width
L2 | 4 Load-Lid and Destroyer rails | Lid front edge | Lid front edge relative to the tub front wall face (− = ahead of the wall) | -25 | LID_X0 | mm
L3 | 4 Load-Lid and Destroyer rails | Lid rear edge | Lid rear edge relative to the closed tailgate's outer face (+ = overhangs) | – | - | mm
L4 | 4 Load-Lid and Destroyer rails | Lid thickness | Top skin → lowest part of its perimeter frame | 45 | LID_T | mm
L5 | 4 Load-Lid and Destroyer rails | Gap rail → lid | Tub rail top → lid underside at the four corners | 8 | LID_CLEAR | FD
L5 | 4 Load-Lid and Destroyer rails | Gap rail → lid | Tub rail top → lid underside at the four corners | 8 | LID_CLEAR | FP
L5 | 4 Load-Lid and Destroyer rails | Gap rail → lid | Tub rail top → lid underside at the four corners | 8 | LID_CLEAR | RD
L5 | 4 Load-Lid and Destroyer rails | Gap rail → lid | Tub rail top → lid underside at the four corners | 8 | LID_CLEAR | RP
L6 | 4 Load-Lid and Destroyer rails | Lid side skirt and lid rail (each side) | The UTE MASTER plate hanging below the lid, and the aluminium rail with holes under it (photos P2, P3): Z of the LOWEST edge of each (from the rib tops), and how far each stands in from the side wall. Full length, or where do they start and stop (X)? | skirt 490 / rail 488 (photo est) | LID_SKIRT, LID_BASE_RAIL | Skirt Z
L6 | 4 Load-Lid and Destroyer rails | Lid side skirt and lid rail (each side) | The UTE MASTER plate hanging below the lid, and the aluminium rail with holes under it (photos P2, P3): Z of the LOWEST edge of each (from the rib tops), and how far each stands in from the side wall. Full length, or where do they start and stop (X)? | skirt 490 / rail 488 (photo est) | LID_SKIRT, LID_BASE_RAIL | Skirt in
L6 | 4 Load-Lid and Destroyer rails | Lid side skirt and lid rail (each side) | The UTE MASTER plate hanging below the lid, and the aluminium rail with holes under it (photos P2, P3): Z of the LOWEST edge of each (from the rib tops), and how far each stands in from the side wall. Full length, or where do they start and stop (X)? | skirt 490 / rail 488 (photo est) | LID_SKIRT, LID_BASE_RAIL | Rail Z
L6 | 4 Load-Lid and Destroyer rails | Lid side skirt and lid rail (each side) | The UTE MASTER plate hanging below the lid, and the aluminium rail with holes under it (photos P2, P3): Z of the LOWEST edge of each (from the rib tops), and how far each stands in from the side wall. Full length, or where do they start and stop (X)? | skirt 490 / rail 488 (photo est) | LID_SKIRT, LID_BASE_RAIL | Rail in
L6 | 4 Load-Lid and Destroyer rails | Lid side skirt and lid rail (each side) | The UTE MASTER plate hanging below the lid, and the aluminium rail with holes under it (photos P2, P3): Z of the LOWEST edge of each (from the rib tops), and how far each stands in from the side wall. Full length, or where do they start and stop (X)? | skirt 490 / rail 488 (photo est) | LID_SKIRT, LID_BASE_RAIL | X start
L6 | 4 Load-Lid and Destroyer rails | Lid side skirt and lid rail (each side) | The UTE MASTER plate hanging below the lid, and the aluminium rail with holes under it (photos P2, P3): Z of the LOWEST edge of each (from the rib tops), and how far each stands in from the side wall. Full length, or where do they start and stop (X)? | skirt 490 / rail 488 (photo est) | LID_SKIRT, LID_BASE_RAIL | X end
L7 | 4 Load-Lid and Destroyer rails | Hinges and lock | Hinge type and positions; lock/latch positions and how far they reach into the tub | – | - | notes
L8 | 4 Load-Lid and Destroyer rails | Gas struts (inside the tub, front) | Lid closed. For BOTH ends of each strut: X (from X0), Z (from Z0) and distance from the side wall to the strut's centre; strut diameter (photos P1, P4, P5) | x 150–480, z 495–540 (photo est) | LID_STRUT | Driver Low X
L8 | 4 Load-Lid and Destroyer rails | Gas struts (inside the tub, front) | Lid closed. For BOTH ends of each strut: X (from X0), Z (from Z0) and distance from the side wall to the strut's centre; strut diameter (photos P1, P4, P5) | x 150–480, z 495–540 (photo est) | LID_STRUT | Driver Low Z
L8 | 4 Load-Lid and Destroyer rails | Gas struts (inside the tub, front) | Lid closed. For BOTH ends of each strut: X (from X0), Z (from Z0) and distance from the side wall to the strut's centre; strut diameter (photos P1, P4, P5) | x 150–480, z 495–540 (photo est) | LID_STRUT | Driver Low in
L8 | 4 Load-Lid and Destroyer rails | Gas struts (inside the tub, front) | Lid closed. For BOTH ends of each strut: X (from X0), Z (from Z0) and distance from the side wall to the strut's centre; strut diameter (photos P1, P4, P5) | x 150–480, z 495–540 (photo est) | LID_STRUT | Driver High X
L8 | 4 Load-Lid and Destroyer rails | Gas struts (inside the tub, front) | Lid closed. For BOTH ends of each strut: X (from X0), Z (from Z0) and distance from the side wall to the strut's centre; strut diameter (photos P1, P4, P5) | x 150–480, z 495–540 (photo est) | LID_STRUT | Driver High Z
L8 | 4 Load-Lid and Destroyer rails | Gas struts (inside the tub, front) | Lid closed. For BOTH ends of each strut: X (from X0), Z (from Z0) and distance from the side wall to the strut's centre; strut diameter (photos P1, P4, P5) | x 150–480, z 495–540 (photo est) | LID_STRUT | Driver High in
L8 | 4 Load-Lid and Destroyer rails | Gas struts (inside the tub, front) | Lid closed. For BOTH ends of each strut: X (from X0), Z (from Z0) and distance from the side wall to the strut's centre; strut diameter (photos P1, P4, P5) | x 150–480, z 495–540 (photo est) | LID_STRUT | Driver Dia
L8 | 4 Load-Lid and Destroyer rails | Gas struts (inside the tub, front) | Lid closed. For BOTH ends of each strut: X (from X0), Z (from Z0) and distance from the side wall to the strut's centre; strut diameter (photos P1, P4, P5) | x 150–480, z 495–540 (photo est) | LID_STRUT | Passenger Low X
L8 | 4 Load-Lid and Destroyer rails | Gas struts (inside the tub, front) | Lid closed. For BOTH ends of each strut: X (from X0), Z (from Z0) and distance from the side wall to the strut's centre; strut diameter (photos P1, P4, P5) | x 150–480, z 495–540 (photo est) | LID_STRUT | Passenger Low Z
L8 | 4 Load-Lid and Destroyer rails | Gas struts (inside the tub, front) | Lid closed. For BOTH ends of each strut: X (from X0), Z (from Z0) and distance from the side wall to the strut's centre; strut diameter (photos P1, P4, P5) | x 150–480, z 495–540 (photo est) | LID_STRUT | Passenger Low in
L8 | 4 Load-Lid and Destroyer rails | Gas struts (inside the tub, front) | Lid closed. For BOTH ends of each strut: X (from X0), Z (from Z0) and distance from the side wall to the strut's centre; strut diameter (photos P1, P4, P5) | x 150–480, z 495–540 (photo est) | LID_STRUT | Passenger High X
L8 | 4 Load-Lid and Destroyer rails | Gas struts (inside the tub, front) | Lid closed. For BOTH ends of each strut: X (from X0), Z (from Z0) and distance from the side wall to the strut's centre; strut diameter (photos P1, P4, P5) | x 150–480, z 495–540 (photo est) | LID_STRUT | Passenger High Z
L8 | 4 Load-Lid and Destroyer rails | Gas struts (inside the tub, front) | Lid closed. For BOTH ends of each strut: X (from X0), Z (from Z0) and distance from the side wall to the strut's centre; strut diameter (photos P1, P4, P5) | x 150–480, z 495–540 (photo est) | LID_STRUT | Passenger High in
L8 | 4 Load-Lid and Destroyer rails | Gas struts (inside the tub, front) | Lid closed. For BOTH ends of each strut: X (from X0), Z (from Z0) and distance from the side wall to the strut's centre; strut diameter (photos P1, P4, P5) | x 150–480, z 495–540 (photo est) | LID_STRUT | Passenger Dia
L9 | 4 Load-Lid and Destroyer rails | Star-knob clamps | Each star knob on the lid skirt (photos P2, P3): X, how far its tip is from the side wall, Z of its lowest point. How many per side? | 1160 / 1290 (photo est) | LID_KNOBS_X | Knob 1 D X
L9 | 4 Load-Lid and Destroyer rails | Star-knob clamps | Each star knob on the lid skirt (photos P2, P3): X, how far its tip is from the side wall, Z of its lowest point. How many per side? | 1160 / 1290 (photo est) | LID_KNOBS_X | Knob 1 D in
L9 | 4 Load-Lid and Destroyer rails | Star-knob clamps | Each star knob on the lid skirt (photos P2, P3): X, how far its tip is from the side wall, Z of its lowest point. How many per side? | 1160 / 1290 (photo est) | LID_KNOBS_X | Knob 1 D Z
L9 | 4 Load-Lid and Destroyer rails | Star-knob clamps | Each star knob on the lid skirt (photos P2, P3): X, how far its tip is from the side wall, Z of its lowest point. How many per side? | 1160 / 1290 (photo est) | LID_KNOBS_X | Knob 1 P X
L9 | 4 Load-Lid and Destroyer rails | Star-knob clamps | Each star knob on the lid skirt (photos P2, P3): X, how far its tip is from the side wall, Z of its lowest point. How many per side? | 1160 / 1290 (photo est) | LID_KNOBS_X | Knob 1 P in
L9 | 4 Load-Lid and Destroyer rails | Star-knob clamps | Each star knob on the lid skirt (photos P2, P3): X, how far its tip is from the side wall, Z of its lowest point. How many per side? | 1160 / 1290 (photo est) | LID_KNOBS_X | Knob 1 P Z
L9 | 4 Load-Lid and Destroyer rails | Star-knob clamps | Each star knob on the lid skirt (photos P2, P3): X, how far its tip is from the side wall, Z of its lowest point. How many per side? | 1160 / 1290 (photo est) | LID_KNOBS_X | Knob 2 D X
L9 | 4 Load-Lid and Destroyer rails | Star-knob clamps | Each star knob on the lid skirt (photos P2, P3): X, how far its tip is from the side wall, Z of its lowest point. How many per side? | 1160 / 1290 (photo est) | LID_KNOBS_X | Knob 2 D in
L9 | 4 Load-Lid and Destroyer rails | Star-knob clamps | Each star knob on the lid skirt (photos P2, P3): X, how far its tip is from the side wall, Z of its lowest point. How many per side? | 1160 / 1290 (photo est) | LID_KNOBS_X | Knob 2 D Z
L9 | 4 Load-Lid and Destroyer rails | Star-knob clamps | Each star knob on the lid skirt (photos P2, P3): X, how far its tip is from the side wall, Z of its lowest point. How many per side? | 1160 / 1290 (photo est) | LID_KNOBS_X | Knob 2 P X
L9 | 4 Load-Lid and Destroyer rails | Star-knob clamps | Each star knob on the lid skirt (photos P2, P3): X, how far its tip is from the side wall, Z of its lowest point. How many per side? | 1160 / 1290 (photo est) | LID_KNOBS_X | Knob 2 P in
L9 | 4 Load-Lid and Destroyer rails | Star-knob clamps | Each star knob on the lid skirt (photos P2, P3): X, how far its tip is from the side wall, Z of its lowest point. How many per side? | 1160 / 1290 (photo est) | LID_KNOBS_X | Knob 2 P Z
L9 | 4 Load-Lid and Destroyer rails | Star-knob clamps | Each star knob on the lid skirt (photos P2, P3): X, how far its tip is from the side wall, Z of its lowest point. How many per side? | 1160 / 1290 (photo est) | LID_KNOBS_X | Knob 3 D X
L9 | 4 Load-Lid and Destroyer rails | Star-knob clamps | Each star knob on the lid skirt (photos P2, P3): X, how far its tip is from the side wall, Z of its lowest point. How many per side? | 1160 / 1290 (photo est) | LID_KNOBS_X | Knob 3 D in
L9 | 4 Load-Lid and Destroyer rails | Star-knob clamps | Each star knob on the lid skirt (photos P2, P3): X, how far its tip is from the side wall, Z of its lowest point. How many per side? | 1160 / 1290 (photo est) | LID_KNOBS_X | Knob 3 D Z
L9 | 4 Load-Lid and Destroyer rails | Star-knob clamps | Each star knob on the lid skirt (photos P2, P3): X, how far its tip is from the side wall, Z of its lowest point. How many per side? | 1160 / 1290 (photo est) | LID_KNOBS_X | Knob 3 P X
L9 | 4 Load-Lid and Destroyer rails | Star-knob clamps | Each star knob on the lid skirt (photos P2, P3): X, how far its tip is from the side wall, Z of its lowest point. How many per side? | 1160 / 1290 (photo est) | LID_KNOBS_X | Knob 3 P in
L9 | 4 Load-Lid and Destroyer rails | Star-knob clamps | Each star knob on the lid skirt (photos P2, P3): X, how far its tip is from the side wall, Z of its lowest point. How many per side? | 1160 / 1290 (photo est) | LID_KNOBS_X | Knob 3 P Z
L10 | 4 Load-Lid and Destroyer rails | Destroyer rails (detail b) | Height above the lid top, width, length, X of the front and rear ends, Y of the rail centre from the centreline | 55 / 45 / – / 830 | LID_RAIL_H, LID_RAIL_W, LID_RAIL_Y | Height
L10 | 4 Load-Lid and Destroyer rails | Destroyer rails (detail b) | Height above the lid top, width, length, X of the front and rear ends, Y of the rail centre from the centreline | 55 / 45 / – / 830 | LID_RAIL_H, LID_RAIL_W, LID_RAIL_Y | Width
L10 | 4 Load-Lid and Destroyer rails | Destroyer rails (detail b) | Height above the lid top, width, length, X of the front and rear ends, Y of the rail centre from the centreline | 55 / 45 / – / 830 | LID_RAIL_H, LID_RAIL_W, LID_RAIL_Y | Length
L10 | 4 Load-Lid and Destroyer rails | Destroyer rails (detail b) | Height above the lid top, width, length, X of the front and rear ends, Y of the rail centre from the centreline | 55 / 45 / – / 830 | LID_RAIL_H, LID_RAIL_W, LID_RAIL_Y | Front X
L10 | 4 Load-Lid and Destroyer rails | Destroyer rails (detail b) | Height above the lid top, width, length, X of the front and rear ends, Y of the rail centre from the centreline | 55 / 45 / – / 830 | LID_RAIL_H, LID_RAIL_W, LID_RAIL_Y | Rear X
L10 | 4 Load-Lid and Destroyer rails | Destroyer rails (detail b) | Height above the lid top, width, length, X of the front and rear ends, Y of the rail centre from the centreline | 55 / 45 / – / 830 | LID_RAIL_H, LID_RAIL_W, LID_RAIL_Y | Y
L11 | 4 Load-Lid and Destroyer rails | Rail T-slot (detail b) | Slot opening, slot depth, inner width, lip thickness; T-bolt size used | – | - | Opening
L11 | 4 Load-Lid and Destroyer rails | Rail T-slot (detail b) | Slot opening, slot depth, inner width, lip thickness; T-bolt size used | – | - | Depth
L11 | 4 Load-Lid and Destroyer rails | Rail T-slot (detail b) | Slot opening, slot depth, inner width, lip thickness; T-bolt size used | – | - | Inner w
L11 | 4 Load-Lid and Destroyer rails | Rail T-slot (detail b) | Slot opening, slot depth, inner width, lip thickness; T-bolt size used | – | - | Lip
L11 | 4 Load-Lid and Destroyer rails | Rail T-slot (detail b) | Slot opening, slot depth, inner width, lip thickness; T-bolt size used | – | - | Bolt
L15 | 4 Load-Lid and Destroyer rails | Lid rear stays | The steel bar from each rear lid corner down to 2 bolts at the tail-light housing (photos P2, P3): X and Z of each bolt; X where the bar leaves the lid; how far the bar stands off the wall (top and bottom); bar width | bolts ~1322, Z 255 (photo est) | LID_REAR_STAY | Driver Bolt1 X
L15 | 4 Load-Lid and Destroyer rails | Lid rear stays | The steel bar from each rear lid corner down to 2 bolts at the tail-light housing (photos P2, P3): X and Z of each bolt; X where the bar leaves the lid; how far the bar stands off the wall (top and bottom); bar width | bolts ~1322, Z 255 (photo est) | LID_REAR_STAY | Driver Bolt1 Z
L15 | 4 Load-Lid and Destroyer rails | Lid rear stays | The steel bar from each rear lid corner down to 2 bolts at the tail-light housing (photos P2, P3): X and Z of each bolt; X where the bar leaves the lid; how far the bar stands off the wall (top and bottom); bar width | bolts ~1322, Z 255 (photo est) | LID_REAR_STAY | Driver Bolt2 Z
L15 | 4 Load-Lid and Destroyer rails | Lid rear stays | The steel bar from each rear lid corner down to 2 bolts at the tail-light housing (photos P2, P3): X and Z of each bolt; X where the bar leaves the lid; how far the bar stands off the wall (top and bottom); bar width | bolts ~1322, Z 255 (photo est) | LID_REAR_STAY | Driver Top X
L15 | 4 Load-Lid and Destroyer rails | Lid rear stays | The steel bar from each rear lid corner down to 2 bolts at the tail-light housing (photos P2, P3): X and Z of each bolt; X where the bar leaves the lid; how far the bar stands off the wall (top and bottom); bar width | bolts ~1322, Z 255 (photo est) | LID_REAR_STAY | Driver Off top
L15 | 4 Load-Lid and Destroyer rails | Lid rear stays | The steel bar from each rear lid corner down to 2 bolts at the tail-light housing (photos P2, P3): X and Z of each bolt; X where the bar leaves the lid; how far the bar stands off the wall (top and bottom); bar width | bolts ~1322, Z 255 (photo est) | LID_REAR_STAY | Driver Off bot
L15 | 4 Load-Lid and Destroyer rails | Lid rear stays | The steel bar from each rear lid corner down to 2 bolts at the tail-light housing (photos P2, P3): X and Z of each bolt; X where the bar leaves the lid; how far the bar stands off the wall (top and bottom); bar width | bolts ~1322, Z 255 (photo est) | LID_REAR_STAY | Driver Width
L15 | 4 Load-Lid and Destroyer rails | Lid rear stays | The steel bar from each rear lid corner down to 2 bolts at the tail-light housing (photos P2, P3): X and Z of each bolt; X where the bar leaves the lid; how far the bar stands off the wall (top and bottom); bar width | bolts ~1322, Z 255 (photo est) | LID_REAR_STAY | Passenger Bolt1 X
L15 | 4 Load-Lid and Destroyer rails | Lid rear stays | The steel bar from each rear lid corner down to 2 bolts at the tail-light housing (photos P2, P3): X and Z of each bolt; X where the bar leaves the lid; how far the bar stands off the wall (top and bottom); bar width | bolts ~1322, Z 255 (photo est) | LID_REAR_STAY | Passenger Bolt1 Z
L15 | 4 Load-Lid and Destroyer rails | Lid rear stays | The steel bar from each rear lid corner down to 2 bolts at the tail-light housing (photos P2, P3): X and Z of each bolt; X where the bar leaves the lid; how far the bar stands off the wall (top and bottom); bar width | bolts ~1322, Z 255 (photo est) | LID_REAR_STAY | Passenger Bolt2 Z
L15 | 4 Load-Lid and Destroyer rails | Lid rear stays | The steel bar from each rear lid corner down to 2 bolts at the tail-light housing (photos P2, P3): X and Z of each bolt; X where the bar leaves the lid; how far the bar stands off the wall (top and bottom); bar width | bolts ~1322, Z 255 (photo est) | LID_REAR_STAY | Passenger Top X
L15 | 4 Load-Lid and Destroyer rails | Lid rear stays | The steel bar from each rear lid corner down to 2 bolts at the tail-light housing (photos P2, P3): X and Z of each bolt; X where the bar leaves the lid; how far the bar stands off the wall (top and bottom); bar width | bolts ~1322, Z 255 (photo est) | LID_REAR_STAY | Passenger Off top
L15 | 4 Load-Lid and Destroyer rails | Lid rear stays | The steel bar from each rear lid corner down to 2 bolts at the tail-light housing (photos P2, P3): X and Z of each bolt; X where the bar leaves the lid; how far the bar stands off the wall (top and bottom); bar width | bolts ~1322, Z 255 (photo est) | LID_REAR_STAY | Passenger Off bot
L15 | 4 Load-Lid and Destroyer rails | Lid rear stays | The steel bar from each rear lid corner down to 2 bolts at the tail-light housing (photos P2, P3): X and Z of each bolt; X where the bar leaves the lid; how far the bar stands off the wall (top and bottom); bar width | bolts ~1322, Z 255 (photo est) | LID_REAR_STAY | Passenger Width
L16 | 4 Load-Lid and Destroyer rails | Lid front-corner brackets | The angle bracket in each front corner with a plastic hook at its foot (photos P1, P4, P5): how far it stands off the front wall, how far its outer edge is from the side wall, its width, Z of the bottom of the hook | hook Z 285 (photo est) | LID_FRONT_BRACKET | Driver Off front
L16 | 4 Load-Lid and Destroyer rails | Lid front-corner brackets | The angle bracket in each front corner with a plastic hook at its foot (photos P1, P4, P5): how far it stands off the front wall, how far its outer edge is from the side wall, its width, Z of the bottom of the hook | hook Z 285 (photo est) | LID_FRONT_BRACKET | Driver From side
L16 | 4 Load-Lid and Destroyer rails | Lid front-corner brackets | The angle bracket in each front corner with a plastic hook at its foot (photos P1, P4, P5): how far it stands off the front wall, how far its outer edge is from the side wall, its width, Z of the bottom of the hook | hook Z 285 (photo est) | LID_FRONT_BRACKET | Driver Width
L16 | 4 Load-Lid and Destroyer rails | Lid front-corner brackets | The angle bracket in each front corner with a plastic hook at its foot (photos P1, P4, P5): how far it stands off the front wall, how far its outer edge is from the side wall, its width, Z of the bottom of the hook | hook Z 285 (photo est) | LID_FRONT_BRACKET | Driver Hook Z
L16 | 4 Load-Lid and Destroyer rails | Lid front-corner brackets | The angle bracket in each front corner with a plastic hook at its foot (photos P1, P4, P5): how far it stands off the front wall, how far its outer edge is from the side wall, its width, Z of the bottom of the hook | hook Z 285 (photo est) | LID_FRONT_BRACKET | Passenger Off front
L16 | 4 Load-Lid and Destroyer rails | Lid front-corner brackets | The angle bracket in each front corner with a plastic hook at its foot (photos P1, P4, P5): how far it stands off the front wall, how far its outer edge is from the side wall, its width, Z of the bottom of the hook | hook Z 285 (photo est) | LID_FRONT_BRACKET | Passenger From side
L16 | 4 Load-Lid and Destroyer rails | Lid front-corner brackets | The angle bracket in each front corner with a plastic hook at its foot (photos P1, P4, P5): how far it stands off the front wall, how far its outer edge is from the side wall, its width, Z of the bottom of the hook | hook Z 285 (photo est) | LID_FRONT_BRACKET | Passenger Width
L16 | 4 Load-Lid and Destroyer rails | Lid front-corner brackets | The angle bracket in each front corner with a plastic hook at its foot (photos P1, P4, P5): how far it stands off the front wall, how far its outer edge is from the side wall, its width, Z of the bottom of the hook | hook Z 285 (photo est) | LID_FRONT_BRACKET | Passenger Hook Z
L12 | 4 Load-Lid and Destroyer rails | Lid top surface | Chequer pattern height; flat or crowned (straight edge across: gap at the centre) | flat | - | Pattern
L12 | 4 Load-Lid and Destroyer rails | Lid top surface | Chequer pattern height; flat or crowned (straight edge across: gap at the centre) | flat | - | Crown
L13 | 4 Load-Lid and Destroyer rails | Lid underside over the batteries (v0.14) | Tub floor → lid underside at the driver front corner (X ≈ 100 and 250, Y ≈ 200 and 500): the battery top foam assumes 9 mm above the handle lugs | 548 | UNDER_LID_Z | X100 Y200
L13 | 4 Load-Lid and Destroyer rails | Lid underside over the batteries (v0.14) | Tub floor → lid underside at the driver front corner (X ≈ 100 and 250, Y ≈ 200 and 500): the battery top foam assumes 9 mm above the handle lugs | 548 | UNDER_LID_Z | X100 Y500
L13 | 4 Load-Lid and Destroyer rails | Lid underside over the batteries (v0.14) | Tub floor → lid underside at the driver front corner (X ≈ 100 and 250, Y ≈ 200 and 500): the battery top foam assumes 9 mm above the handle lugs | 548 | UNDER_LID_Z | X250 Y200
L13 | 4 Load-Lid and Destroyer rails | Lid underside over the batteries (v0.14) | Tub floor → lid underside at the driver front corner (X ≈ 100 and 250, Y ≈ 200 and 500): the battery top foam assumes 9 mm above the handle lugs | 548 | UNDER_LID_Z | X250 Y500
L14 | 4 Load-Lid and Destroyer rails | Space for the water-can jacket (v0.14) | Lid top → tent base underside over the water can, and lid top → the tent's under-rail; is a 30 mm jacket top possible? | 163.4 | TENT_Z0 − LID_TOP_Z | To base
L14 | 4 Load-Lid and Destroyer rails | Space for the water-can jacket (v0.14) | Lid top → tent base underside over the water can, and lid top → the tent's under-rail; is a 30 mm jacket top possible? | 163.4 | TENT_Z0 − LID_TOP_Z | To rail
R1 | 5 Rack bars and tent | Bar positions | Centre line of each Vortex bar from the lid front edge (or from the tub front wall, say which) | 180 / 1080 (from tub wall) | RACK_BAR_X | Front bar
R1 | 5 Rack bars and tent | Bar positions | Centre line of each Vortex bar from the lid front edge (or from the tub front wall, say which) | 180 / 1080 (from tub wall) | RACK_BAR_X | Rear bar
R1 | 5 Rack bars and tent | Bar positions | Centre line of each Vortex bar from the lid front edge (or from the tub front wall, say which) | 180 / 1080 (from tub wall) | RACK_BAR_X | Datum
R2 | 5 Rack bars and tent | Bar length and overhang | Overall length; overhang past each leg | 1500 | RACK_BAR_L | Length
R2 | 5 Rack bars and tent | Bar length and overhang | Overall length; overhang past each leg | 1500 | RACK_BAR_L | D overhang
R2 | 5 Rack bars and tent | Bar length and overhang | Overall length; overhang past each leg | 1500 | RACK_BAR_L | P overhang
R3 | 5 Rack bars and tent | Bar section | Width × height of the bar; top slot width | 79 × 30 | RACK_BAR | W
R3 | 5 Rack bars and tent | Bar section | Width × height of the bar; top slot width | 79 × 30 | RACK_BAR | H
R3 | 5 Rack bars and tent | Bar section | Width × height of the bar; top slot width | 79 × 30 | RACK_BAR | Slot
R4 | 5 Rack bars and tent | Bar height | Lid top → underside of each bar beside each leg | 133.4 | TENT_GAP − bar | Front D
R4 | 5 Rack bars and tent | Bar height | Lid top → underside of each bar beside each leg | 133.4 | TENT_GAP − bar | Front P
R4 | 5 Rack bars and tent | Bar height | Lid top → underside of each bar beside each leg | 133.4 | TENT_GAP − bar | Rear D
R4 | 5 Rack bars and tent | Bar height | Lid top → underside of each bar beside each leg | 133.4 | TENT_GAP − bar | Rear P
R5 | 5 Rack bars and tent | Legs / brackets | Footprint on the rail (along × across), leg height, part number | – | - | Footprint
R5 | 5 Rack bars and tent | Legs / brackets | Footprint on the rail (along × across), leg height, part number | – | - | Height
R5 | 5 Rack bars and tent | Legs / brackets | Footprint on the rail (along × across), leg height, part number | – | - | Part no.
R6 | 5 Rack bars and tent | Tent under-rails | Y of each under-rail centre from the centreline; X of the rail ends | ±400 | TENT_UNDER_RAILS_CC | D Y
R6 | 5 Rack bars and tent | Tent under-rails | Y of each under-rail centre from the centreline; X of the rail ends | ±400 | TENT_UNDER_RAILS_CC | P Y
R6 | 5 Rack bars and tent | Tent under-rails | Y of each under-rail centre from the centreline; X of the rail ends | ±400 | TENT_UNDER_RAILS_CC | Front X
R6 | 5 Rack bars and tent | Tent under-rails | Y of each under-rail centre from the centreline; X of the rail ends | ±400 | TENT_UNDER_RAILS_CC | Rear X
R7 | 5 Rack bars and tent | Tent bolt tails (detail c) | At each of the 4 crossings: bar underside → lowest point of bolt, nut or plate; plate size; bolt size | 60 | TENT_BOLT_DROP | Front D
R7 | 5 Rack bars and tent | Tent bolt tails (detail c) | At each of the 4 crossings: bar underside → lowest point of bolt, nut or plate; plate size; bolt size | 60 | TENT_BOLT_DROP | Front P
R7 | 5 Rack bars and tent | Tent bolt tails (detail c) | At each of the 4 crossings: bar underside → lowest point of bolt, nut or plate; plate size; bolt size | 60 | TENT_BOLT_DROP | Rear D
R7 | 5 Rack bars and tent | Tent bolt tails (detail c) | At each of the 4 crossings: bar underside → lowest point of bolt, nut or plate; plate size; bolt size | 60 | TENT_BOLT_DROP | Rear P
R7 | 5 Rack bars and tent | Tent bolt tails (detail c) | At each of the 4 crossings: bar underside → lowest point of bolt, nut or plate; plate size; bolt size | 60 | TENT_BOLT_DROP | Plate
R7 | 5 Rack bars and tent | Tent bolt tails (detail c) | At each of the 4 crossings: bar underside → lowest point of bolt, nut or plate; plate size; bolt size | 60 | TENT_BOLT_DROP | Bolt
R8 | 5 Rack bars and tent | Gap lid → tent | Lid top → lowest part of the tent base at the front, middle and rear, both sides | 163.4 | TENT_GAP | Front D
R8 | 5 Rack bars and tent | Gap lid → tent | Lid top → lowest part of the tent base at the front, middle and rear, both sides | 163.4 | TENT_GAP | Front P
R8 | 5 Rack bars and tent | Gap lid → tent | Lid top → lowest part of the tent base at the front, middle and rear, both sides | 163.4 | TENT_GAP | Mid D
R8 | 5 Rack bars and tent | Gap lid → tent | Lid top → lowest part of the tent base at the front, middle and rear, both sides | 163.4 | TENT_GAP | Mid P
R8 | 5 Rack bars and tent | Gap lid → tent | Lid top → lowest part of the tent base at the front, middle and rear, both sides | 163.4 | TENT_GAP | Rear D
R8 | 5 Rack bars and tent | Gap lid → tent | Lid top → lowest part of the tent base at the front, middle and rear, both sides | 163.4 | TENT_GAP | Rear P
R9 | 5 Rack bars and tent | Tent position | Tent front and rear edges from the lid front edge; overhang past the lid edge each side | -10 | TENT_X0 | Front
R9 | 5 Rack bars and tent | Tent position | Tent front and rear edges from the lid front edge; overhang past the lid edge each side | -10 | TENT_X0 | Rear
R9 | 5 Rack bars and tent | Tent position | Tent front and rear edges from the lid front edge; overhang past the lid edge each side | -10 | TENT_X0 | D overhang
R9 | 5 Rack bars and tent | Tent position | Tent front and rear edges from the lid front edge; overhang past the lid edge each side | -10 | TENT_X0 | P overhang
R10 | 5 Rack bars and tent | Tent shape | Closed height (base → top of the roof bars), length of the front slope, top-bar spacing and length | 330 / 380 / 1040 / 890 | TENT_H, TENT_SLOPE_L, TENT_BAR_CC, TENT_BAR_L | Height
R10 | 5 Rack bars and tent | Tent shape | Closed height (base → top of the roof bars), length of the front slope, top-bar spacing and length | 330 / 380 / 1040 / 890 | TENT_H, TENT_SLOPE_L, TENT_BAR_CC, TENT_BAR_L | Slope
R10 | 5 Rack bars and tent | Tent shape | Closed height (base → top of the roof bars), length of the front slope, top-bar spacing and length | 330 / 380 / 1040 / 890 | TENT_H, TENT_SLOPE_L, TENT_BAR_CC, TENT_BAR_L | Bar c/c
R10 | 5 Rack bars and tent | Tent shape | Closed height (base → top of the roof bars), length of the front slope, top-bar spacing and length | 330 / 380 / 1040 / 890 | TENT_H, TENT_SLOPE_L, TENT_BAR_CC, TENT_BAR_L | Bar length
R11 | 5 Rack bars and tent | Ladder bracket | Where it is and how far it sticks out or down | – | - | notes
R12 | 5 Rack bars and tent | Tent open | How far the open tent reaches past the driver side; floor height when open | – | - | Reach
R12 | 5 Rack bars and tent | Tent open | How far the open tent reaches past the driver side; floor height when open | – | - | Floor height
R13 | 5 Rack bars and tent | Tent to cab | Tent front face → cab rear at tent-base height | – | - | mm
B1 | 6 Body, cab gap and chassis | Cab–tub gap | Cab back wall → tub front wall at the top, middle and bottom | 55 | CAB_REAR_X | Top
B1 | 6 Body, cab gap and chassis | Cab–tub gap | Cab back wall → tub front wall at the top, middle and bottom | 55 | CAB_REAR_X | Mid
B1 | 6 Body, cab gap and chassis | Cab–tub gap | Cab back wall → tub front wall at the top, middle and bottom | 55 | CAB_REAR_X | Bottom
B2 | 6 Body, cab gap and chassis | In the gap | Body mounts, hoses, lines, wiring. Free space near the passenger top corner for a ~150 × 150 × 90 junction box? | – | - | Free W
B2 | 6 Body, cab gap and chassis | In the gap | Body mounts, hoses, lines, wiring. Free space near the passenger top corner for a ~150 × 150 × 90 junction box? | – | - | Free H
B2 | 6 Body, cab gap and chassis | In the gap | Body mounts, hoses, lines, wiring. Free space near the passenger top corner for a ~150 × 150 × 90 junction box? | – | - | Free D
B3 | 6 Body, cab gap and chassis | Tub height | Ground → top of the tub rail at the tailgate and at the front corner (the floor is this minus T6) | 1460 | FLOOR_ABOVE_GROUND | Rear
B3 | 6 Body, cab gap and chassis | Tub height | Ground → top of the tub rail at the tailgate and at the front corner (the floor is this minus T6) | 1460 | FLOOR_ABOVE_GROUND | Front
B4 | 6 Body, cab gap and chassis | Rear wheel centre | Plumb from the tub front edge and from the wheel centre; distance along the ground | 430 | REAR_AXLE_X | Driver
B4 | 6 Body, cab gap and chassis | Rear wheel centre | Plumb from the tub front edge and from the wheel centre; distance along the ground | 430 | REAR_AXLE_X | Passenger
B5 | 6 Body, cab gap and chassis | Wheelbase check | Front → rear wheel centres | 3270 | WHEELBASE | Driver
B5 | 6 Body, cab gap and chassis | Wheelbase check | Front → rear wheel centres | 3270 | WHEELBASE | Passenger
B6 | 6 Body, cab gap and chassis | Chassis rails | Centre Y of each rail; top of the rail below the tub floor; rail width × height | ±470 / -150 | CHASSIS_RAIL_Y, CHASSIS_Z | D Y
B6 | 6 Body, cab gap and chassis | Chassis rails | Centre Y of each rail; top of the rail below the tub floor; rail width × height | ±470 / -150 | CHASSIS_RAIL_Y, CHASSIS_Z | P Y
B6 | 6 Body, cab gap and chassis | Chassis rails | Centre Y of each rail; top of the rail below the tub floor; rail width × height | ±470 / -150 | CHASSIS_RAIL_Y, CHASSIS_Z | Top Z
B6 | 6 Body, cab gap and chassis | Chassis rails | Centre Y of each rail; top of the rail below the tub floor; rail width × height | ±470 / -150 | CHASSIS_RAIL_Y, CHASSIS_Z | W
B6 | 6 Body, cab gap and chassis | Chassis rails | Centre Y of each rail; top of the rail below the tub floor; rail width × height | ±470 / -150 | CHASSIS_RAIL_Y, CHASSIS_Z | H
B7 | 6 Body, cab gap and chassis | Cable route | Outlet → passenger chassis rail → cab gap: obstacles, existing clips and holes | – | - | notes
B8 | 6 Body, cab gap and chassis | Tub underside | Cross-member positions (X) under the tub floor, in case anything bolts through | – | - | notes
G1 | 7 Roof, windscreen and platform | Header to tub | Horizontal: top of the windscreen (header seal) → tub front wall (plumb line from the header) | 1790 | CAB_FRONT_X | mm
G2 | 7 Roof, windscreen and platform | Roof length | Header → rear edge of the roof skin | 1680 | - | mm
G3 | 7 Roof, windscreen and platform | Roof height | Ground → roof skin on the centreline, 200 mm behind the header, middle, 100 mm from the rear | 1880 | ROOF_Z | Front
G3 | 7 Roof, windscreen and platform | Roof height | Ground → roof skin on the centreline, 200 mm behind the header, middle, 100 mm from the rear | 1880 | ROOF_Z | Mid
G3 | 7 Roof, windscreen and platform | Roof height | Ground → roof skin on the centreline, 200 mm behind the header, middle, 100 mm from the rear | 1880 | ROOF_Z | Rear
G4 | 7 Roof, windscreen and platform | Roof crown (D6) | Straight edge across the roof: gap to the skin at each mark. Rows: front / mid / rear | flat | - | Front P 700
G4 | 7 Roof, windscreen and platform | Roof crown (D6) | Straight edge across the roof: gap to the skin at each mark. Rows: front / mid / rear | flat | - | Front P 560
G4 | 7 Roof, windscreen and platform | Roof crown (D6) | Straight edge across the roof: gap to the skin at each mark. Rows: front / mid / rear | flat | - | Front P 350
G4 | 7 Roof, windscreen and platform | Roof crown (D6) | Straight edge across the roof: gap to the skin at each mark. Rows: front / mid / rear | flat | - | Front 0
G4 | 7 Roof, windscreen and platform | Roof crown (D6) | Straight edge across the roof: gap to the skin at each mark. Rows: front / mid / rear | flat | - | Front D 350
G4 | 7 Roof, windscreen and platform | Roof crown (D6) | Straight edge across the roof: gap to the skin at each mark. Rows: front / mid / rear | flat | - | Front D 560
G4 | 7 Roof, windscreen and platform | Roof crown (D6) | Straight edge across the roof: gap to the skin at each mark. Rows: front / mid / rear | flat | - | Front D 700
G4 | 7 Roof, windscreen and platform | Roof crown (D6) | Straight edge across the roof: gap to the skin at each mark. Rows: front / mid / rear | flat | - | Mid P 700
G4 | 7 Roof, windscreen and platform | Roof crown (D6) | Straight edge across the roof: gap to the skin at each mark. Rows: front / mid / rear | flat | - | Mid P 560
G4 | 7 Roof, windscreen and platform | Roof crown (D6) | Straight edge across the roof: gap to the skin at each mark. Rows: front / mid / rear | flat | - | Mid P 350
G4 | 7 Roof, windscreen and platform | Roof crown (D6) | Straight edge across the roof: gap to the skin at each mark. Rows: front / mid / rear | flat | - | Mid 0
G4 | 7 Roof, windscreen and platform | Roof crown (D6) | Straight edge across the roof: gap to the skin at each mark. Rows: front / mid / rear | flat | - | Mid D 350
G4 | 7 Roof, windscreen and platform | Roof crown (D6) | Straight edge across the roof: gap to the skin at each mark. Rows: front / mid / rear | flat | - | Mid D 560
G4 | 7 Roof, windscreen and platform | Roof crown (D6) | Straight edge across the roof: gap to the skin at each mark. Rows: front / mid / rear | flat | - | Mid D 700
G4 | 7 Roof, windscreen and platform | Roof crown (D6) | Straight edge across the roof: gap to the skin at each mark. Rows: front / mid / rear | flat | - | Rear P 700
G4 | 7 Roof, windscreen and platform | Roof crown (D6) | Straight edge across the roof: gap to the skin at each mark. Rows: front / mid / rear | flat | - | Rear P 560
G4 | 7 Roof, windscreen and platform | Roof crown (D6) | Straight edge across the roof: gap to the skin at each mark. Rows: front / mid / rear | flat | - | Rear P 350
G4 | 7 Roof, windscreen and platform | Roof crown (D6) | Straight edge across the roof: gap to the skin at each mark. Rows: front / mid / rear | flat | - | Rear 0
G4 | 7 Roof, windscreen and platform | Roof crown (D6) | Straight edge across the roof: gap to the skin at each mark. Rows: front / mid / rear | flat | - | Rear D 350
G4 | 7 Roof, windscreen and platform | Roof crown (D6) | Straight edge across the roof: gap to the skin at each mark. Rows: front / mid / rear | flat | - | Rear D 560
G4 | 7 Roof, windscreen and platform | Roof crown (D6) | Straight edge across the roof: gap to the skin at each mark. Rows: front / mid / rear | flat | - | Rear D 700
G5 | 7 Roof, windscreen and platform | Roof width | Skin width between the drip channels at the front, middle, rear | – | - | Front
G5 | 7 Roof, windscreen and platform | Roof width | Skin width between the drip channels at the front, middle, rear | – | - | Mid
G5 | 7 Roof, windscreen and platform | Roof width | Skin width between the drip channels at the front, middle, rear | – | - | Rear
G6 | 7 Roof, windscreen and platform | Roof mounting points | How many; X (from the header) and Y of each; thread; cover type | – | - | notes
G7 | 7 Roof, windscreen and platform | Roof rails | Height, foot positions; do they come off for the Wedgetail kit? | – | - | notes
G8 | 7 Roof, windscreen and platform | Roof items | Shark-fin antenna position and height; anything else on the roof | – | - | notes
G9 | 7 Roof, windscreen and platform | Windscreen angle | Angle finder flat on the glass at the centre, from horizontal | – | - | degrees
G10 | 7 Roof, windscreen and platform | Windscreen size | Length along the glass (header → bottom edge, centre) and width at the top | – | - | Length
G10 | 7 Roof, windscreen and platform | Windscreen size | Length along the glass (header → bottom edge, centre) and width at the top | – | - | Width
G11 | 7 Roof, windscreen and platform | Bonnet rear edge | Height above ground and horizontal distance from the header at the centre; top of the parked wipers | – | - | Height
G11 | 7 Roof, windscreen and platform | Bonnet rear edge | Height above ground and horizontal distance from the header at the centre; top of the parked wipers | – | - | From header
G11 | 7 Roof, windscreen and platform | Bonnet rear edge | Height above ground and horizontal distance from the header at the centre; top of the parked wipers | – | - | Wipers
G12 | 7 Roof, windscreen and platform | Platform (once fitted) | Platform underside above the roof skin at the front and rear; front edge vs the header | 70 | PLAT_Z | Front
G12 | 7 Roof, windscreen and platform | Platform (once fitted) | Platform underside above the roof skin at the front and rear; front edge vs the header | 70 | PLAT_Z | Rear
G12 | 7 Roof, windscreen and platform | Platform (once fitted) | Platform underside above the roof skin at the front and rear; front edge vs the header | 70 | PLAT_Z | Front edge
G13 | 7 Roof, windscreen and platform | Overall height | Ground → top of the closed tent; ground → top of the platform | 2006 | - | Tent
G13 | 7 Roof, windscreen and platform | Overall height | Ground → top of the closed tent; ground → top of the platform | 2006 | - | Platform
G14 | 7 Roof, windscreen and platform | Headlining and roof cables | How far the headlining drops to reach the roof points; path for a cable roof → cab (which pillar?) | – | - | notes
E1 | 8 Engine bay and cabin | Start battery | Type and size; terminal type; room for a MIDI fuse holder within 300 mm of the + terminal | – | - | notes
E2 | 8 Engine bay and cabin | Fuse box | Location; fuse type (mini / micro2) for the add-a-fuse; an ignition-switched circuit to tap | – | - | notes
E3 | 8 Engine bay and cabin | Alternator | Rated current on its label (amps) | unknown | - | Amps
E4 | 8 Engine bay and cabin | Engine bay → chassis | Path for the 25 mm² twin from the start battery to the passenger chassis rail (R21); exhaust distance along the rail (R17–R19) | – | - | notes
E5 | 8 Engine bay and cabin | Under the rear seat | Space for the cabin outlet box: length × width × height, what's there now | 45 L | CABIN_SEAT_BOX | L
E5 | 8 Engine bay and cabin | Under the rear seat | Space for the cabin outlet box: length × width × height, what's there now | 45 L | CABIN_SEAT_BOX | W
E5 | 8 Engine bay and cabin | Under the rear seat | Space for the cabin outlet box: length × width × height, what's there now | 45 L | CABIN_SEAT_BOX | H
E6 | 8 Engine bay and cabin | Cab floor grommets | Existing grommets that could take the cabin feed from the chassis rail (R20) | – | - | notes
E8 | 8 Engine bay and cabin | Cab back (C-pillar corner) | Flat face up the passenger corner of the cab back for the 32 mm conduit (R25), and the gap between the cab top and the platform rear member | – | - | Width
E8 | 8 Engine bay and cabin | Cab back (C-pillar corner) | Flat face up the passenger corner of the cab back for the 32 mm conduit (R25), and the gap between the cab top and the platform rear member | – | - | Gap
E9 | 8 Engine bay and cabin | Chassis rail web | Height of the passenger rail web and the free length for the two conduits from the tub to the cab-tub gap (R16 / R17) | 180 / – | - | Web H
E9 | 8 Engine bay and cabin | Chassis rail web | Height of the passenger rail web and the free length for the two conduits from the tub to the cab-tub gap (R16 / R17) | 180 / – | - | Free L
E7 | 8 Engine bay and cabin | Dash switch blanks | Free switch blanks on the dash (optional visor stow switch) | – | - | notes
Q1 | 9 Equipment and vehicle details | Fridge | Confirmed Dometic CFX3 45 (694 × 398 × 476): check the handle height and that the handles fold up for the straps | CFX3 45 | - | Model
Q1 | 9 Equipment and vehicle details | Fridge | Confirmed Dometic CFX3 45 (694 × 398 × 476): check the handle height and that the handles fold up for the straps | CFX3 45 | - | L
Q1 | 9 Equipment and vehicle details | Fridge | Confirmed Dometic CFX3 45 (694 × 398 × 476): check the handle height and that the handles fold up for the straps | CFX3 45 | - | W
Q1 | 9 Equipment and vehicle details | Fridge | Confirmed Dometic CFX3 45 (694 × 398 × 476): check the handle height and that the handles fold up for the straps | CFX3 45 | - | H
Q1 | 9 Equipment and vehicle details | Fridge | Confirmed Dometic CFX3 45 (694 × 398 × 476): check the handle height and that the handles fold up for the straps | CFX3 45 | - | Lid
Q2 | 9 Equipment and vehicle details | Accessories fitted | Tow bar (ball weight), bull bar, side steps, snorkel, anything else | – | - | notes
Q3 | 9 Equipment and vehicle details | Compliance plate | GVM, GCM, rear axle rating | GVM 3250 | - | GVM
Q3 | 9 Equipment and vehicle details | Compliance plate | GVM, GCM, rear axle rating | GVM 3250 | - | GCM
Q3 | 9 Equipment and vehicle details | Compliance plate | GVM, GCM, rear axle rating | GVM 3250 | - | Rear axle
Q4 | 9 Equipment and vehicle details | Weighbridge (optional) | Front and rear axle weights, unladen, full fuel | – | - | Front
Q4 | 9 Equipment and vehicle details | Weighbridge (optional) | Front and rear axle weights, unladen, full fuel | – | - | Rear
Q5 | 9 Equipment and vehicle details | Tyres | Size and pressures | 265/70R17 | - | Size
Q5 | 9 Equipment and vehicle details | Tyres | Size and pressures | 265/70R17 | - | Pressures
