Kieran-who/kia-tasman-fitout/cad/out/fitout_fab.step

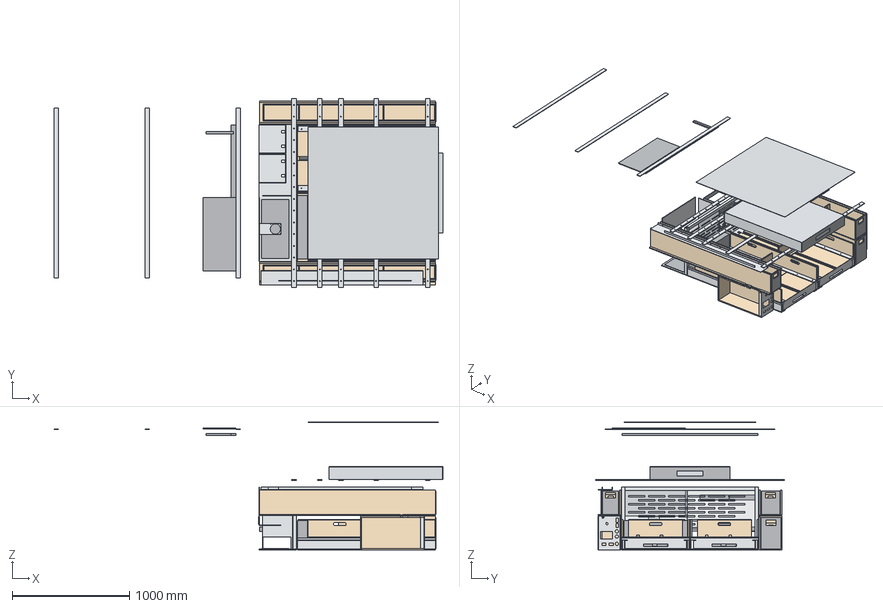
[picture p30: CAD file, 2026-11-01]
cad/out/fitout_fab.step
3315.0 x 1613.0 x 1089.4 mm
tent_solar_backing
uts_xbar_0
uts_xbar_1
uts_xbar_2
uts_xbar_3
uts_xbar_4
uts_cassette_sides
uts_cassette_top
uts_cassette_front
uts_drawer_box
uts_drawer_face
bay_base_tray
bay_rear_post_-582
bay_rear_post_552
bay_rear_top
inverter_standoffs
bay_fan_bracket
bay_fan_bracket_leg
charge_board
battery_1_strap_156
battery_1_strap_426
battery_2_strap_156
battery_2_strap_426
dist_board
bay_guard
slide_power_base_plate_-582
slide_power_base_plate_-63
slide_power_base_cross_0
slide_power_base_cross_1
slide_power_base_cross_2
slide_power_runner_plate_a
slide_power_runner_plate_b
slide_power_uhmw_stop_-552
slide_power_uhmw_stop_-73
slide_power_carr_side_0
slide_power_deck_angle_0
slide_power_carr_side_1
slide_power_deck_angle_1
slide_power_carr_cross_0
slide_power_carr_cross_3
slide_power_carr_cross_4
slide_power_deck
slide_power_edge_cap
slide_power_ltrack
slide_power_fridge_well_pan
slide_power_filler_panel
slide_power_filler_riser_0
slide_power_filler_riser_1
slide_power_filler_ltrack
slide_power_power_pod
slide_power_rear_plate
slide_power_leg_clevis_0
slide_power_leg_0_s0
slide_power_leg_0_s1
slide_power_leg_0_s2
slide_power_leg_clip_0
slide_power_leg_clevis_1
slide_power_leg_1_s0
slide_power_leg_1_s1
slide_power_leg_1_s2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
