Kieran-who/kia-tasman-fitout/docs/wiring/wiring-diagram-v0.13.pdf

A | A
B | B
C | C
D | D
E | E
F | F
G | G
H | H

## System overview: locations and cable bundles

Where each part lives and which cables share each run (from the model's runs, E8). Circuits on E2–E7 and E9; routes to scale on E8, E10–E15.

PROJECT
Kia Tasman X-Pro fit-out · electrical

SHEET
E1 of E15

TITLE
System overview: locations and cable bundles

REV / DATE
v0.13 · 2026-10-22

Generated by tools/wiring/diagram.py from cad/fitout/wiring.py — cable IDs and lengths match bom/cable-schedule-v0.13.csv. Measurements still [EST] until confirmed on the vehicle.

230 V work: licensed electrician only (AS/NZS 3000 · AS/NZS 3001.2). Not certified.

PASSENGER CHASSIS RAIL

TUB

Roof platform

PV1 190 W + PV2 130 W, PV5 visor 250 W ST1 Starlink, U11 visor controller (E9)

Tent (detachable)

services box: XI1 inlet, Q4 RCBO, XS3 outlet, X5 PV3 + PV4 2 × 100 W flexible (series)

Gap junction box

J1–J4 keyed connectors (tent)
barrier 230 V | 12 V, roof pass-through

Engine bay

BT0 start battery + F8 60 A MIDI
FBX fuse box: F9 2 A add-a-fuse (IGN)

Cabin, under the rear seat

X4 SB50 inlet → U12 compute box HA PC, router, PoE switch

Factory-outlet gland

passenger rear tub wall

Wall drop + tray

drop beside the gland; tray under the lid

Front bay

BT1/BT2, F1/F2, BB1–BB4, QS1, P1, F3
U1 MultiPlus-II, U2 Orion, U3/U4/U13 MPPTs F4–F7 MIDI/MEGA, F17 MRBF (pod), M1 fan

Rear control cabinet

FB1 fuse block, RCBO enclosure (Q0–Q3) U5 Cerbo GX, rear panel: U6, S1–S3, XS1 GPO, X1/X2, U7/U8, X6

Power slide pod

FB2, XS2 GPO, X3 Anderson, X7 12 V

2 CABLES
AC3, DO2

1 CABLE
DO3

3 CABLES
DO3, ALT, IGN

2 CABLES
ALT, IGN

13 CABLES
AC4, AC5, DO3, DO4, DO5, ALT IGN, PVR, PVT, PVS, VIS, VSW VIG

10 CABLES
AC4, AC5, DO4, DO5, PVR, PVT PVS, VIS, VSW, VIG

15 CABLES
AC4, AC5, PE2, DO3, DO4, DO5 ALT, IGN, PVR, PVT, PVS, CHB VIS, VSW, VIG

2 CABLES
ALT, IGN

18 CABLES
AC1, AC3, AC4, AC5, DCF, ALT IGN, PVR, PVT, PVS, SW1, CHB SW2, D1, D2, D4, D5, VIG

6 CABLES
DO4, PVR, PVS, VIS, VSW, VIG | 2 CABLES
| T1A, T1D

17 CABLES
AC1, AC3, AC5, DCF, ALT, IGN PVR, PVT, PVS, SW1, CHB, SW2 D1, D2, D4, D5, VIG

16 CABLES
AC1, | AC3, AC4, DCF, PE2, DO3
DO4, | DO5, SW1, SW2, D1, D2
D4, D5, VIS, VSW

internal: B1P, B1N, B2P, B2N, RB1, RB2, SH1, SH2, CT1, INVP, INVN, ORO, MPR, MPT, MPV, RBF, SHV, FAN, PE1

internal: AC2, DO1A, DO1B, DO1C, DO1D, DO1E, CGX, D3

internal: PVV, T2

ROUTING RULES

Every cable that leaves the tub goes out through the factory 240 V outlet hole (passenger rear wall) and along the passenger chassis rail. Nothing passes through the load lid.
The tent harness (dashed) unplugs at the gap junction, so the tent lifts off with its services box and solar.
All switching is at the rear panel: battery isolate (S1 → QS1), inverter on/off (S2), visor (S3), GX Touch 50.
230 V never shares a conduit or gland row with 12 V.
Line weight ∝ number of cables in the run.

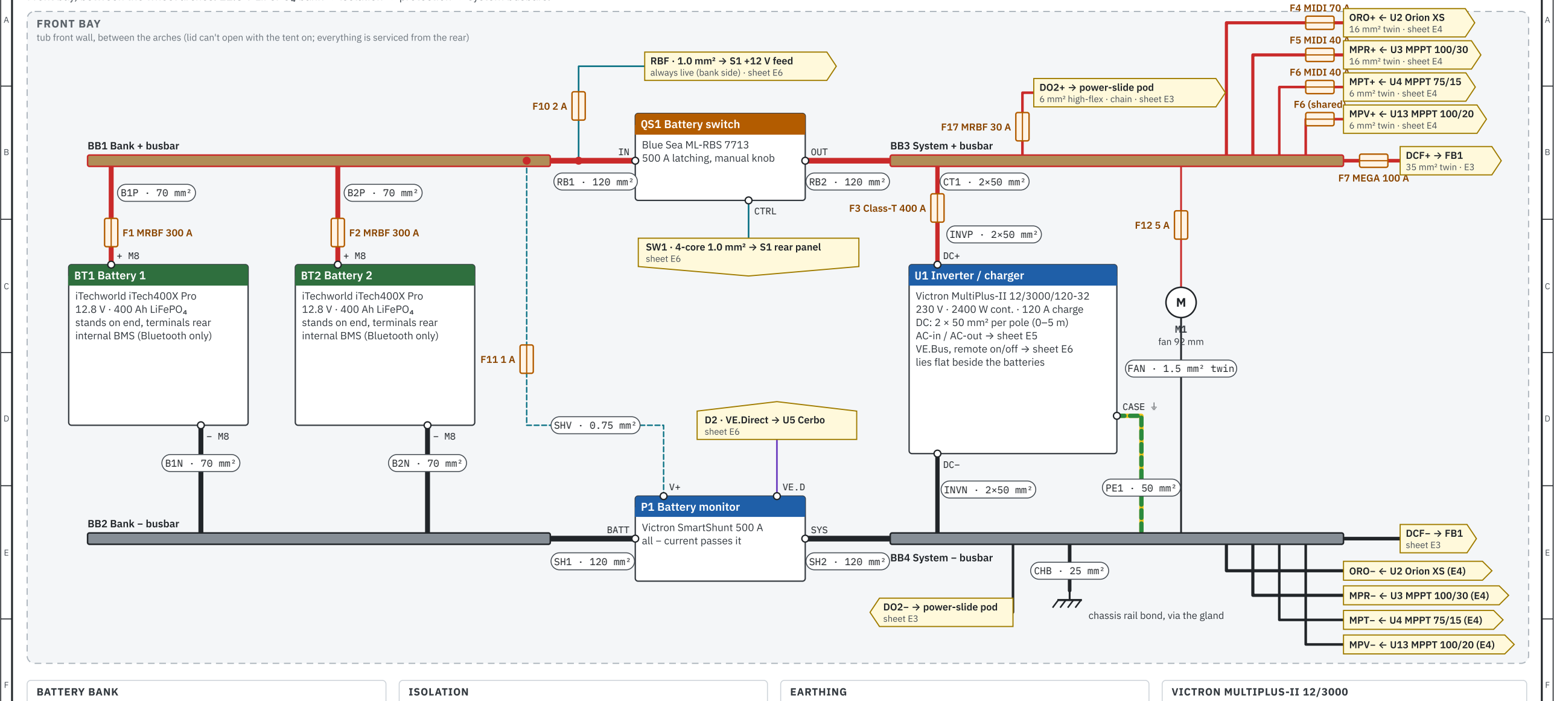
[picture p47: figure]
FRONT BAY; BB1 Bank + busbar; BB2 Bank − busbar; F1 MRBF 300 A; F2 MRBF 300 A; BB3 System + busbar; BB4 System − busbar; F3 Class-T 400 A; fan 92 mm; F4 MIDI 70 A; F5 MIDI 40 A; F6 MIDI 40 A; F6 (shared); F17 MRBF 30 A; F7 MEGA 100 A; BT1 Battery 1; iTechworld iTech400X Pro 12.8 V · 400 Ah LiFePO₄; stands on end, terminals rear internal BMS (Bluetooth only); BT2 Battery 2; QS1 Battery switch; Blue Sea ML-RBS 7713 500 A latching, manual knob; OUT; CTRL; P1 Battery monitor; Victron SmartShunt 500 A all − current passes it; BATT; SYS; U1 Inverter / charger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

G | G

### DC power: battery bank and main distribution

Front bay, between the wheel arches. 12.8 V LiFePO₄ bank → isolation → protection → system busbars.

PROJECT
Kia Tasman X-Pro fit-out · electrical

SHEET
E2 of E15

DC power: battery bank and main distribution

DC + (red) | DC − (black) | Protective earth (green/yellow) | Data (VE.Bus / VE.Direct / USB) | Control (12 V switched)
Signal / sense

LEGEND · line weight ∝ conductor size · ID · size tags = cable schedule IDs · purple ▶◀ = detachable connector · yellow flags = continues on another sheet

tub front wall, between the arches (lid can't open with the tent on; everything is serviced from the rear)

B1P = B2P and B1N = B2N: cut each pair to the longer length (schedule) with identical lugs.
F1/F2 MRBF 300 A sit directly on each + stud. RB1/RB2/SH1/SH2 120 mm² (v0.13): both MRBFs in parallel can deliver 600 A into them.
Tinned fine-strand, hex-crimped, adhesive heat-shrink; re-torque after 500 km.

QS1 opens bank + → system +. BB3 stays live from the chargers: open QP1–QP3, S2 off and ignition off BEFORE opening QS1, so no charger runs without the battery.
Only F10 (QS1 control) and F11 (shunt sense) stay live on the bank side.
S2 off before closing QS1 (MultiPlus inrush).

DC: one bond only, BB4 → chassis (CHB 25 mm²). MultiPlus case → BB4 (PE1, Victron: = DC −).
AC earth bar → chassis bond (PE2, 6 mm² G/Y), not via the DC negative (E5).
Orion XS non-isolated: ALT − lands on the body earth, chassis side of the battery sensor (E4).

F3: Class-T 400 A, holder bolted beside BB3: CT1 link < 200 mm, so F3 is at the source.
CT1 / INVP / INVN: 2 × 50 mm² per pole; INVP + CT1 ≈ 1.2 m route, through the window. MIDI F4–F6 and MEGA F7 on the BB3 studs; F6 40 A serves MPT and MPV (6 mm² each).

## DC distribution: fuse block and 12 V outlets

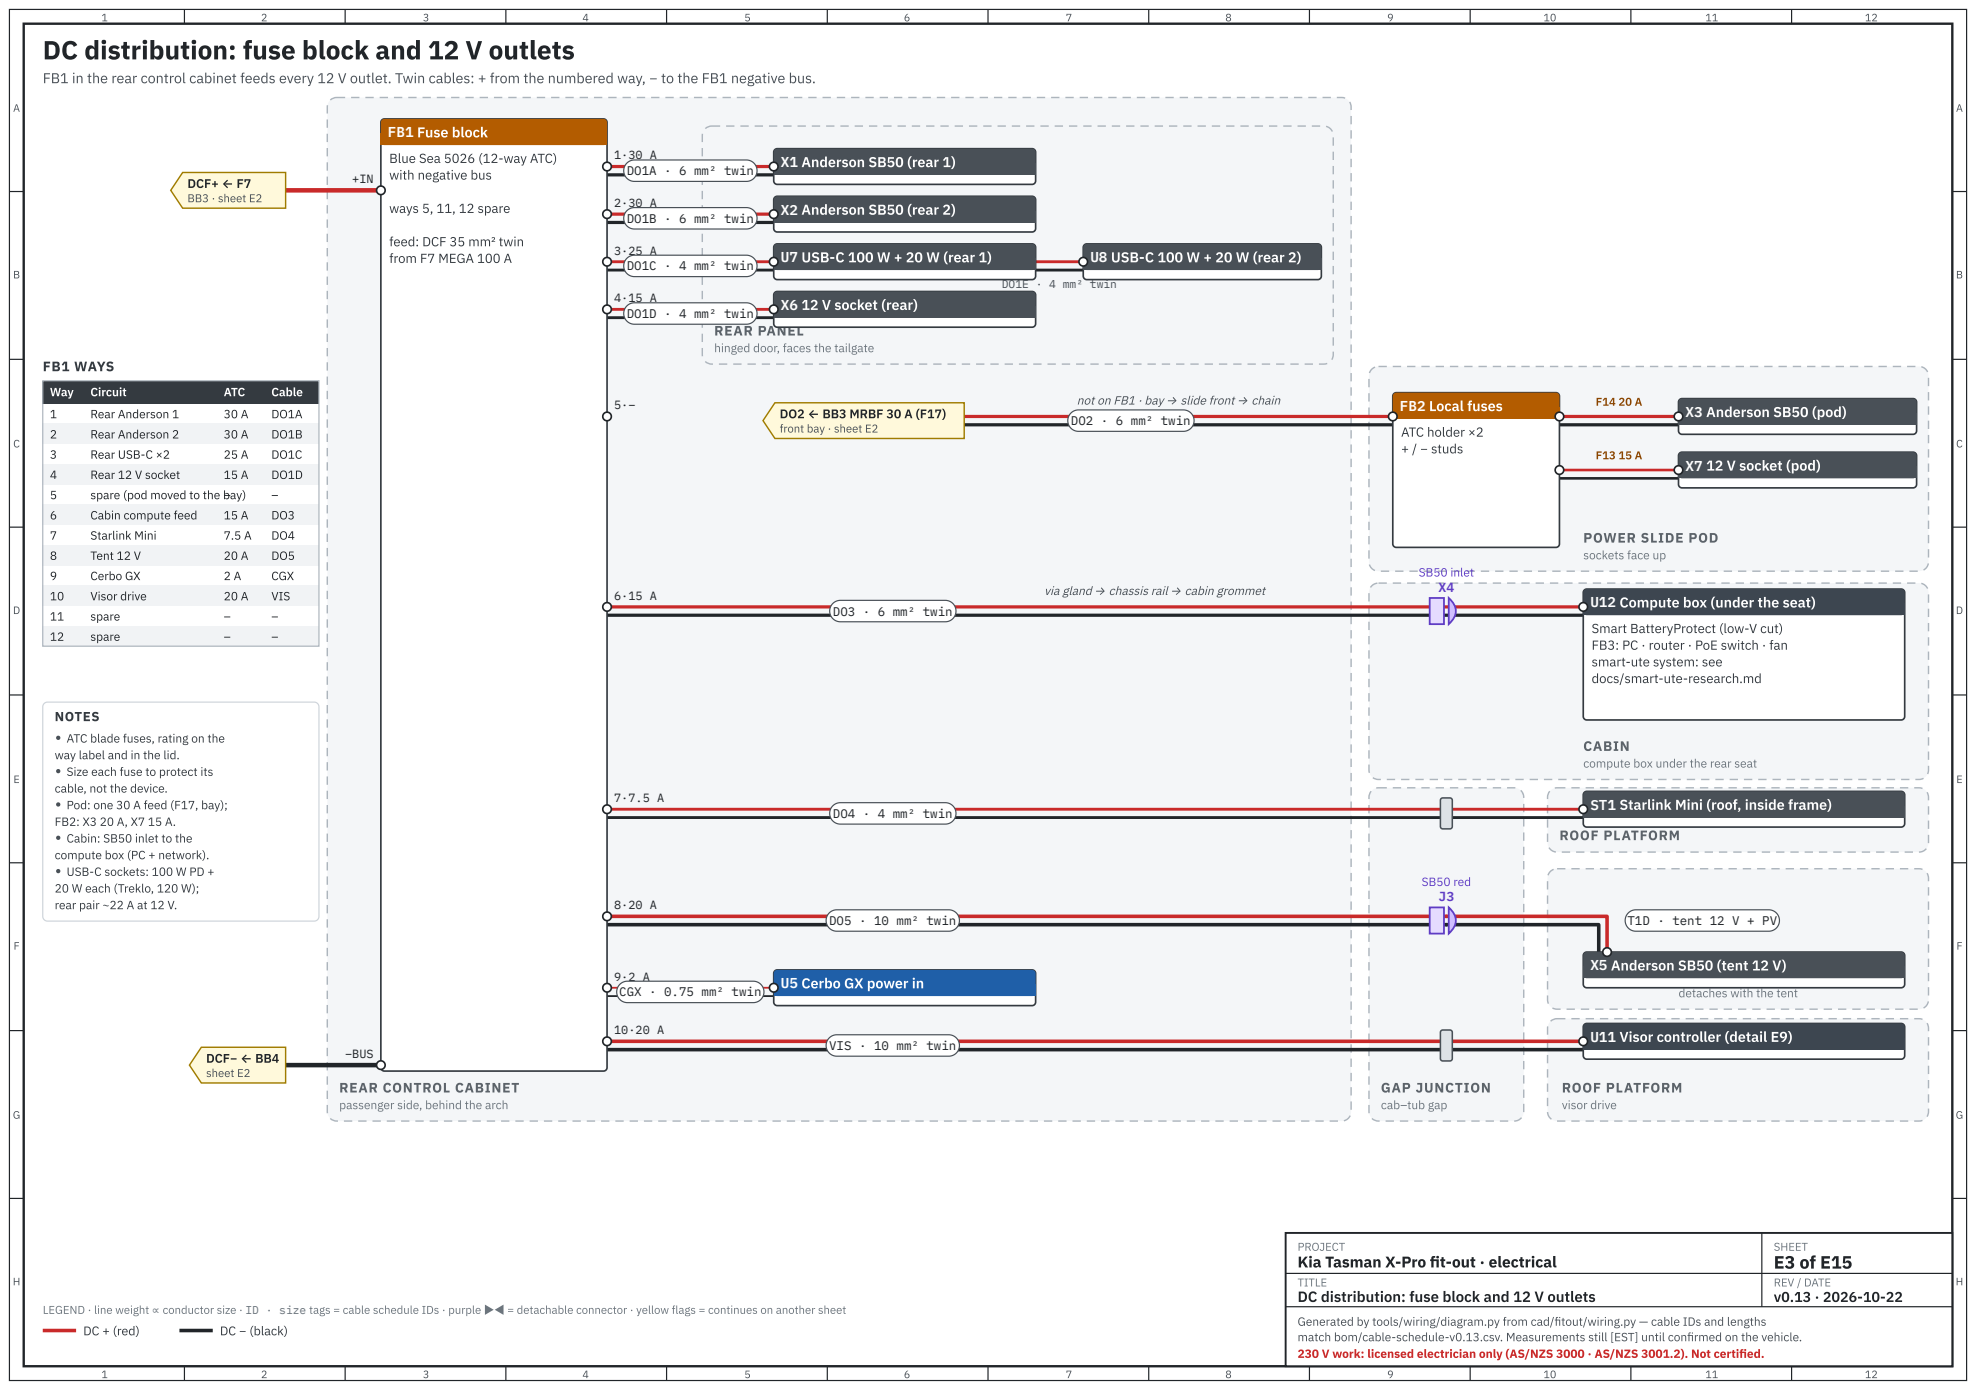
[picture p48: page 3]

FB1 in the rear control cabinet feeds every 12 V outlet. Twin cables: + from the numbered way, − to the FB1 negative bus.

Blue Sea 5026 (12-way ATC)
with negative bus

feed: DCF 35 mm² twin
from F7 MEGA 100 A

REAR PANEL
hinged door, faces the tailgate

via gland → chassis rail → cabin grommet

U12 Compute box (under the seat)

Smart BatteryProtect (low-V cut)
FB3: PC · router · PoE switch · fan
smart-ute system: see
docs/smart-ute-research.md

ATC blade fuses, rating on the
way label and in the lid.
Size each fuse to protect its
cable, not the device.
Pod: one 30 A feed (F17, bay);
Cabin: SB50 inlet to the
compute box (PC + network).
USB-C sockets: 100 W PD +
20 W each (Treklo, 120 W);
rear pair ~22 A at 12 V.

CABIN
compute box under the rear seat

ST1 Starlink Mini (roof, inside frame)

U5 Cerbo GX power in

TENT SERVICES BOX
detaches with the tent

REAR CONTROL CABINET
passenger side, behind the arch

PROJECT
Kia Tasman X-Pro fit-out · electrical

DC distribution: fuse block and 12 V outlets

LEGEND · line weight ∝ conductor size · ID · size tags = cable schedule IDs · purple ▶◀ = detachable connector · yellow flags = continues on another sheet

### Charging: alternator (DC-DC) and solar

Four independent chargers in the front bay, each output fused at the system busbars (sheet E2).

ENGINE BAY; ROOF PLATFORM; fixed array; TENT ROOF; detachable array; GAP JUNCTION; FRONT BAY: CHARGING BOARD; front wall, above the inverter; F8 MIDI 60 A; QP1 PV isolator; QP3 PV isolator; SB50 grey; QP2 PV isolator; F4 MIDI 70 A; F5 MIDI 40 A; F6 MIDI 40 A; F6 shared; G1 Alternator; smart / variable; BT0 Start battery; factory 12 V AGM/EFB; FBX Engine fuse box; ignition add-a-fuse; IGN; U2 DC-DC charger; Victron Orion XS 12/12-50A non-isolated, 50 A out input limit 25–30 A (alternator rating unknown) VE.Direct → Cerbo USB (E6); OUT+; OUT−; BlueSolar; U3 MPPT roof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

PROJECT
Kia Tasman X-Pro fit-out · electrical

SHEET
E4 of E15

Charging: alternator (DC-DC) and solar

DC + (red) | DC − (black) | PV + | PV − | Signal / sense | Factory vehicle wiring

LEGEND · line weight ∝ conductor size · ID · size tags = cable schedule IDs · purple ▶◀ = detachable connector · yellow flags = continues on another sheet

ALT − on the body earth (chassis side of the battery sensor)

Absorption / float / no temperature compensation set to iTechworld's LiFePO₄ figures in all four chargers (the BMS has no Victron link). Orion XS: charger mode, input limit 25–30 A until the alternator rating is known; IGN on H. Two panels in parallel need no string fuses. DVCC on, SmartShunt as the battery monitor (Venus OS ≥ 3.20). QP1–QP3: 2-pole DC isolators; open them before QS1 (sheet E2).

B | B
C | C
D | D
E | E
F | F
G | G

### 230 V AC: shore inlet, inverter output, RCBOs and outlets

Licensed electrician to install and certify (AS/NZS 3000, AS/NZS 3001.2). Active brown · neutral blue · earth green/yellow.

PROJECT
Kia Tasman X-Pro fit-out · electrical

SHEET
E5 of E15

230 V AC: shore inlet, inverter output, RCBOs and outlets

AC active (brown) | AC neutral (blue) | Protective earth (green/yellow)

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

TENT SERVICES BOX
under the tent, front, inset

GAP JUNCTION
cab–tub gap

FRONT BAY

REAR CONTROL CABINET

POWER SLIDE POD

J2

IP66 15 A

chassis bond

J1

IP66 10 A

XI1 Shore inlet

Clipsal 56AI315
IP66, 15 A

L N PE Q4 RCBO 2-pole

16 A 30 mA

U1 MultiPlus-II 12/3000

AC-in → transfer switch (32 A) → AC-out 1
AC-in current limit: 15 A
Ground relay bonds N–PE while inverting, so the RCBOs work off-grid (check the AU setting). AC-out 2 not used.

Case / PE → BB4 (PE1, E2)

L N PE

L N PE

CASE

RCBO RCBO enclosure

IP66, DIN rail, N bar + PE bar Q0 main switch 2P 32 A

Q1 10 A 30 mA → rear GPO

Q2 10 A 30 mA → pod GPO

Q3 10 A 30 mA → tent outlet

L N PE

PE bar

XS1 Rear double GPO

IP66, 10 A, rear panel

L N PE

XS2 Pod GPO

flush, faces up, 10 A

L N PE

XS3 Tent heater outlet

Clipsal 56SO310A
IP66, 10 A

PE N L

T1A · AC-in cores

AC5 · 2.5 mm² 3-core

AC1 · 4 mm² 3-core

PE2 · 6 mm²

AC2 · 2.5 mm² 3-core

AC3 · 2.5 mm² 3-core

AC4 · 2.5 mm² 3-core

T1A · AC-out cores

PE1 → BB4 (case to DC −)

sheet E2

tent: socket
vehicle: inlet

AC3: through the cable chain, high-flex 3-core

vehicle: socket
tent: plug

ELECTRICIAN NOTES

Every 230 V circuit is RCD-protected (30 mA): Q4 (2-pole) on the inlet, Q1–Q3 on AC-out. Q0: 2-pole main switch for the inverter supply (AS/NZS 3001.2). AC1 is 4 mm²: with PowerAssist AC-out can carry ~25 A (15 A shore + inverter).
230 V runs apart from 12 V: own tray compartment, own grommet row, orange conduit outside, separator in the slide chain, own sheath to the tent (T1A).
The tent has only two 230 V connections (J1 out, J2 in). They differ in rating and gender, so the tent's outlet can't be plugged into its own inlet.
MultiPlus-II: AC-in limit 15 A; enable the ground relay for AU; test every RCD in inverter mode and on shore power before first use.
Earth continuity: every metal enclosure and outlet earth back to U1 PE and BB4. Compliance plate and RCD test record inside the rear cabinet door.

## Control and communications

Cerbo GX gathers every Victron device for the GX Touch, Home Assistant and VRM. Hard-wired switches at the rear panel.

MONITORING; Cerbo GX in the rear cabinet; U5 Cerbo GX MK2; Victron GX device, Venus OS ≥ 3.20; 3 × VE.Direct, 2 × VE.Bus (RJ45) 3 × USB, HDMI, Ethernet, Wi-Fi, BLE VE.Can 1/2, relays, tank / temp / digital inputs: unused; power: FB1 way 9, 2 A (CGX); PWR; HDMI; USB 3; VE.Bus; VE.Direct 1; VE.Direct 2; VE.Direct 3; USB 1; USB 2; U6 GX Touch 50; 5" touch display, rear panel; VE.Bus U1 MultiPlus-II; VE.Direct P1 SmartShunt 500 A; VE.Direct U3 MPPT 100/30 (roof); VE.Direct U4 MPPT 75/15 (tent); VE.Direct U2 Orion XS 12/12-50A; VE.Direct U13 MPPT 100/20 (visor); HA Home Assistant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
CONTROL CIRCUITS; switches on the rear panel; S1 Battery isolate switch; Blue Sea 2155 Contura SPDT ON-ON with LED rear panel; CTRL; LED; GND; QS1 ML-RBS 7713 control harness; red: CONTROL (high = close) yellow: LED OUTPUT black: GROUND verify colours vs Blue Sea doc; red; yel; blk; S2 Inverter on/off; SPST rocker, rear panel; U1 MultiPlus-II remote on/off; remove the factory L–H bridge; S3 Visor deploy / stow; momentary rocker + LED, rear panel; DEP STOW LED COM; U2 Orion XS remote on/off; H ← ignition 12 V (IGN); remove the L–H bridge; RBF ← BB1 via F10 2 A; bank side, always live · E2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

PROJECT
Kia Tasman X-Pro fit-out · electrical

SHEET
E6 of E15

Control and communications

DC + (red) | DC − (black) | Data (VE.Bus / VE.Direct / USB) | Control (12 V switched) | Signal / sense | Wireless (Wi-Fi / BLE)

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

S1 drives QS1 open/closed; QS1 latches, so S1 position is the command and the LED confirms the contacts.
S2 open = MultiPlus fully off (inverter and charger).
Modes (on / charger only) are also on the GX Touch.

B | B
C | C
D | D
E | E
F | F
G | G

## Detachable tent harness and gap junction

Four keyed connectors at the cab–tub gap. Unplug J1–J4, cap them, and the tent lifts off with its harness and services box.

PROJECT
Kia Tasman X-Pro fit-out · electrical

SHEET
E7 of E15

Detachable tent harness and gap junction

DC + (red) | DC − (black) | PV + | PV − | AC active (brown) | AC neutral (blue) | Protective earth (green/yellow)
Control (12 V switched) | | Signal / sense

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

TENT SERVICES BOX
under the tent, front, inset · stays with the tent

GAP JUNCTION BOX
IP66, barrier: 230 V side | 12 V side | VEHICLE

J1

230 V OUT · IP66 10 A

J2

230 V IN · IP66 15 A

J3

12 V · Anderson SB50 red

J4

PV · Anderson SB50 grey

XS3 Heater outlet

IP66 10 A

L N PE

XI1 Shore inlet

IP66 15 A

L N PE
Q4 RCBO 2-pole

16 A 30 mA

X5 Anderson SB50

tent 12 V (lights, fans)

+
−

PVJ PV bulkhead (MC4)

T2 ← tent-top junction box PV3 + PV4 in series (E4)

+
−

AC4 ← Q3 RCBO

sheet E5

AC5 → U1 AC-in

sheet E5

DO5 ← FB1 way 8 (20 A)

sheet E3

PVT → QP2 → U4 MPPT 75/15

sheet E4

T1A · 230 V: 2 × 2.5 mm² 3-core

T1D · 12 V 10 mm² + PV 6 mm²

T2 · tent top → box, via the front hinge

DO4 Starlink 4 mm² twin · pass-through (not detachable)

PVR roof PV 10 mm² pair · pass-through (not detachable)

PVS visor PV 6 mm² pair · pass-through (not detachable)

VIS visor drive 10 mm² twin · pass-through (not detachable)

VSW visor button 4-core · pass-through (not detachable)

VIG visor interlock 1 mm² · pass-through (not detachable)

J1 · 230 V OUT TO TENT · IP66 10 A (CLIPSAL 56 SERIES)

Pin | Function | Conductor | Vehicle side | Tent side
A | Active | 2.5 mm² brown | socket (live) | plug
N | Neutral | 2.5 mm² blue
E | Earth | 2.5 mm² green/yellow

J2 · 230 V SHORE IN · IP66 15 A INLET + EXTENSION SOCKET

Pin | Function | Conductor | Vehicle side | Tent side
A | Active (shore) | 2.5 mm² brown | appliance inlet | socket (live)
N | Neutral | 2.5 mm² blue
E | Earth | 2.5 mm² green/yellow

J3 · 12 V · ANDERSON SB50 RED

Pin | Function | Conductor
+ | 12 V + | 10 mm² red
− | 12 V − | 10 mm² black

J4 · PV · ANDERSON SB50 GREY

Pin | Function | Conductor
+ | PV + | 6 mm² solar
− | PV − | 6 mm² solar

DETACH / REFIT

1. Switch the inverter off (S2) and isolate shore power at the source.
2. Unplug J2 (shore in) first, then J1, J3, J4.
3. Fit the caps to all eight halves (IP66 caps / SB50 dust covers).
4. Unclip T1A and T1D from the lid-front saddles, then lift the tent. Refit in reverse. SB50 colours are keyed: red and grey won't mate, and J1/J2 differ in rating and gender, so nothing can cross-connect.

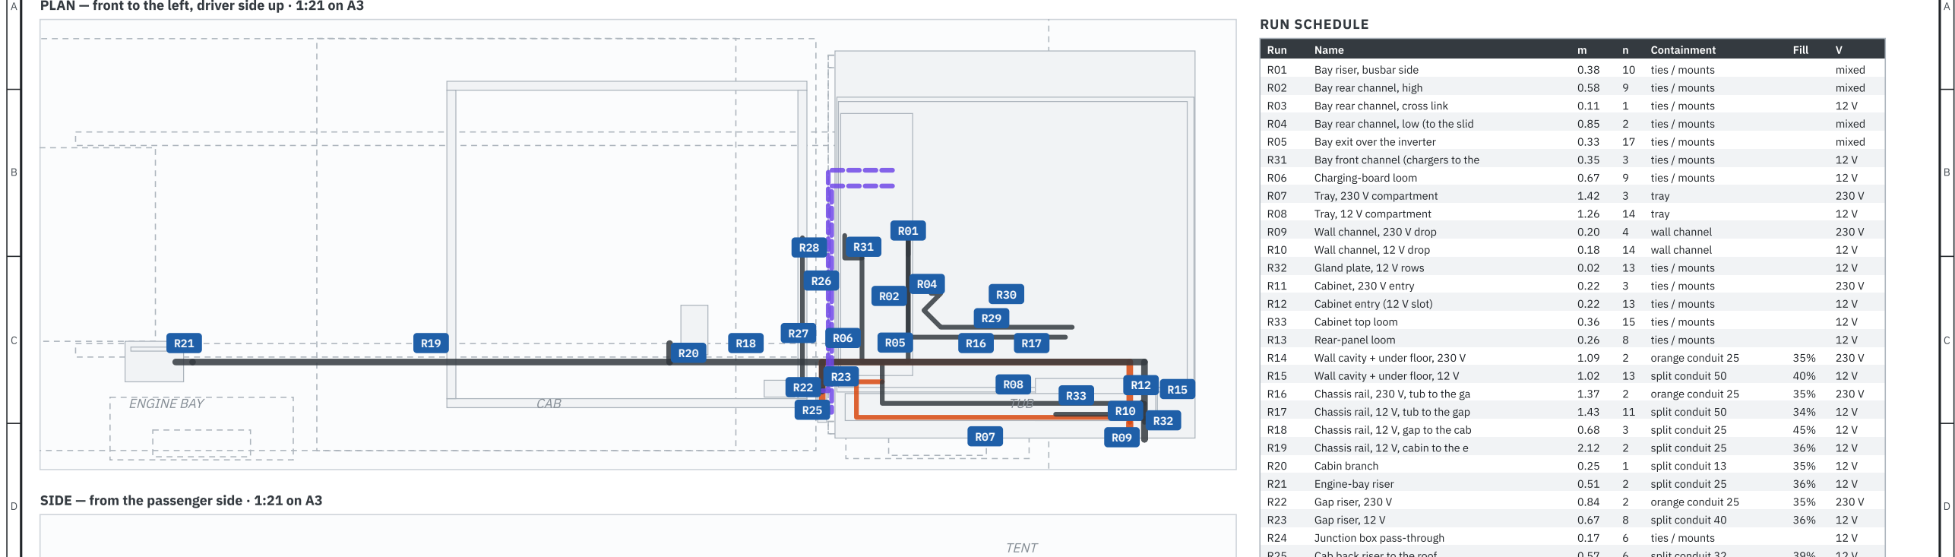
[picture p49: figure]
ENGINE BAY; CAB; TUB; TENT; RUN SCHEDULE; Run; Name; Containment; Fill; Bay riser, busbar side; ties / mounts; mixed; Bay rear channel, high; Bay rear channel, cross link; Bay exit over the inverter; Charging-board loom; Tray, 230 V compartment; tray; Tray, 12 V compartment; Wall channel, 230 V drop; wall channel; Wall channel, 12 V drop; Gland plate, 12 V rows; Cabinet, 230 V entry; Cabinet entry (12 V slot); Cabinet top loom; Rear-panel loom; Cabin branch; split conduit 13; Engine-bay riser; split conduit 25; Gap riser, 230 V; orange conduit 25; Gap riser, 12 V; split conduit 40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

E | E
F | F
G | G

## Cable routes: route map and run schedule

Every physical run (R-code) from the routed 3D model. Detail by zone on E10–E14; bundle sections and fill on E15.

PROJECT
Kia Tasman X-Pro fit-out · electrical

SHEET
E8 of E15

Cable routes: route map and run schedule

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
R09 | R10
R11 | R12

R33
R13
| R14

R15

R16
R17
R19 | R18 R20

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
PLAN — front to the left, driver side up · 1:21 on A3

SIDE — from the passenger side · 1:21 on A3

ENGINE BAY

CAB

TUB

R04 | Bay rear channel, low (to the slid | 0.85 | 2 | ties / mounts | mixed
R31 | Bay front channel (chargers to the | 0.35 | 3 | ties / mounts | 12 V
R14 | Wall cavity + under floor, 230 V | 1.09 | 2 | orange conduit 25 | 35% | 230 V
R15 | Wall cavity + under floor, 12 V | 1.02 | 13 | split conduit 50 | 40% | 12 V
R16 | Chassis rail, 230 V, tub to the ga | 1.37 | 2 | orange conduit 25 | 35% | 230 V
R17 | Chassis rail, 12 V, tub to the gap | 1.43 | 11 | split conduit 50 | 34% | 12 V
R18 | Chassis rail, 12 V, gap to the cab | 0.68 | 3 | split conduit 25 | 45% | 12 V
R19 | Chassis rail, 12 V, cabin to the e | 2.12 | 2 | split conduit 25 | 36% | 12 V
R25 | Cab back riser to the roof | 0.57 | 6 | split conduit 32 | 39% | 12 V
R26 | Platform rear end member | 0.71 | 2 | in extrusion | | 12 V
R27 | Tent harness, 230 V | 1.45 | 1 | spiral wrap 25 | 35% | 230 V
R28 | Tent harness, 12 V + PV | 1.46 | 1 | spiral wrap 25 | 44% | 12 V
R29 | Slide trunk (fixed, on the glide t | 0.71 | 2 | ties / mounts | | mixed
R30 | Power-slide cable chain | 0.84 | 2 | drag chain | | mixed

ROUTING RULES

230 V cables (orange runs) never share a conduit, gland row or tray compartment with 12 V: own grommet row, own orange conduit, separator in the slide chain. Outside the tub every run is in split conduit on rubber-lined P-clips every
300 mm (circles on E12), into M6 rivnuts - no welding or drilling the rail flanges. Fill = cable area / conduit area (≤ 50 % for split conduit laid in).
Lengths: routed in the model; schedule adds 10 % + 0.3 m per cable.
12 V + / DC | DC − | 230 V (sheathed flex) | PV | data / control | earth | tent harness (detachable) | R07 run code (schedule on E8) | P-clip / saddle

### Visor drive: slide, tilt and locking

The windscreen visor panel (PV5) slides out on two rails and tilts to 20°. One button at the rear panel; every motion is interlocked.

FEEDS; rear cabinet · E3, E6; ROOF PLATFORM; visor controller, front cross-member; VISOR MECHANISM; rails, carriages, hinge beam; U11 Visor controller; IP66 box, platform rear corner 12 V logic (PLC / µC) + 2 × dual H-bridge drivers, current sense 3 motor channels: M2, M3, M4 latch driver: Y1 + Y2 4 limit inputs: B1–B4 BZ1 buzzer on the lid; motion only while the button is held (dead-man), 1 s to start timeout 25 s per step → fault; fuses: M2 15 A, M3/M4 7.5 A each, Y 3 A, logic 2 A (v0.13) manual override: 8 mm hex on M2 shaft end and both tilt drives; GND; DEP; STOW; LED; IGN; COM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
VISOR PANEL; moves with the carriages; PV5 250 W visor; semi-flex on honeycomb; PVV → MC4 at U11 → PVS → QP3 → U13; MPPT 100/20 · sheet E4; PVV · 4 mm²; SEQUENCE; Step; Deploy (hold DEP); Stow (hold STOW); INTERLOCKS AND SAFETY

PROJECT
Kia Tasman X-Pro fit-out · electrical

SHEET
E9 of E15

Visor drive: slide, tilt and locking

DC + (red) | DC − (black) | PV + | PV − | Control (12 V switched) | Signal / sense

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

IP67 roller-lever switches, NO; B4 is set 1° before the hard stop

high-flex, runs in an igus chain beside the left rail

1 | check IGN off, B1 + B3 closed | allowed any time (IGN on too)
2 | Y1/Y2 on, M2 starts; Y1/Y2 off once B1 opens | M3 + M4 tilt down until B3
3 | M2 extends until B2 | M2 retracts to B1; pins spring into ramped strikers
4 | M3 + M4 tilt up to 20°, B4 = limit | latches need no power to lock
5 | worms hold the panel, nothing powered | LED off = locked for travel

No deploy with the ignition on. Engine on while not stowed → BZ1 sounds, LED flashes; nothing moves without the button.
M2 runs only with B3 closed: the panel slides flat, then tilts. Over-current on any channel → stop and back off 2 mm (pinch). Mechanical stop at 22° keeps ≥ 87 mm to the glass even if
B4 fails; worm drives cannot be back-driven by wind or load. Latches fail locked. Stow when gusts exceed ~40 km/h.
Y1/Y2 are short-duty (≈5 s): energised < 3 s per deploy. U11 draws < 20 mA idle; isolate with FB1 way 10.

## Cable routes: front bay

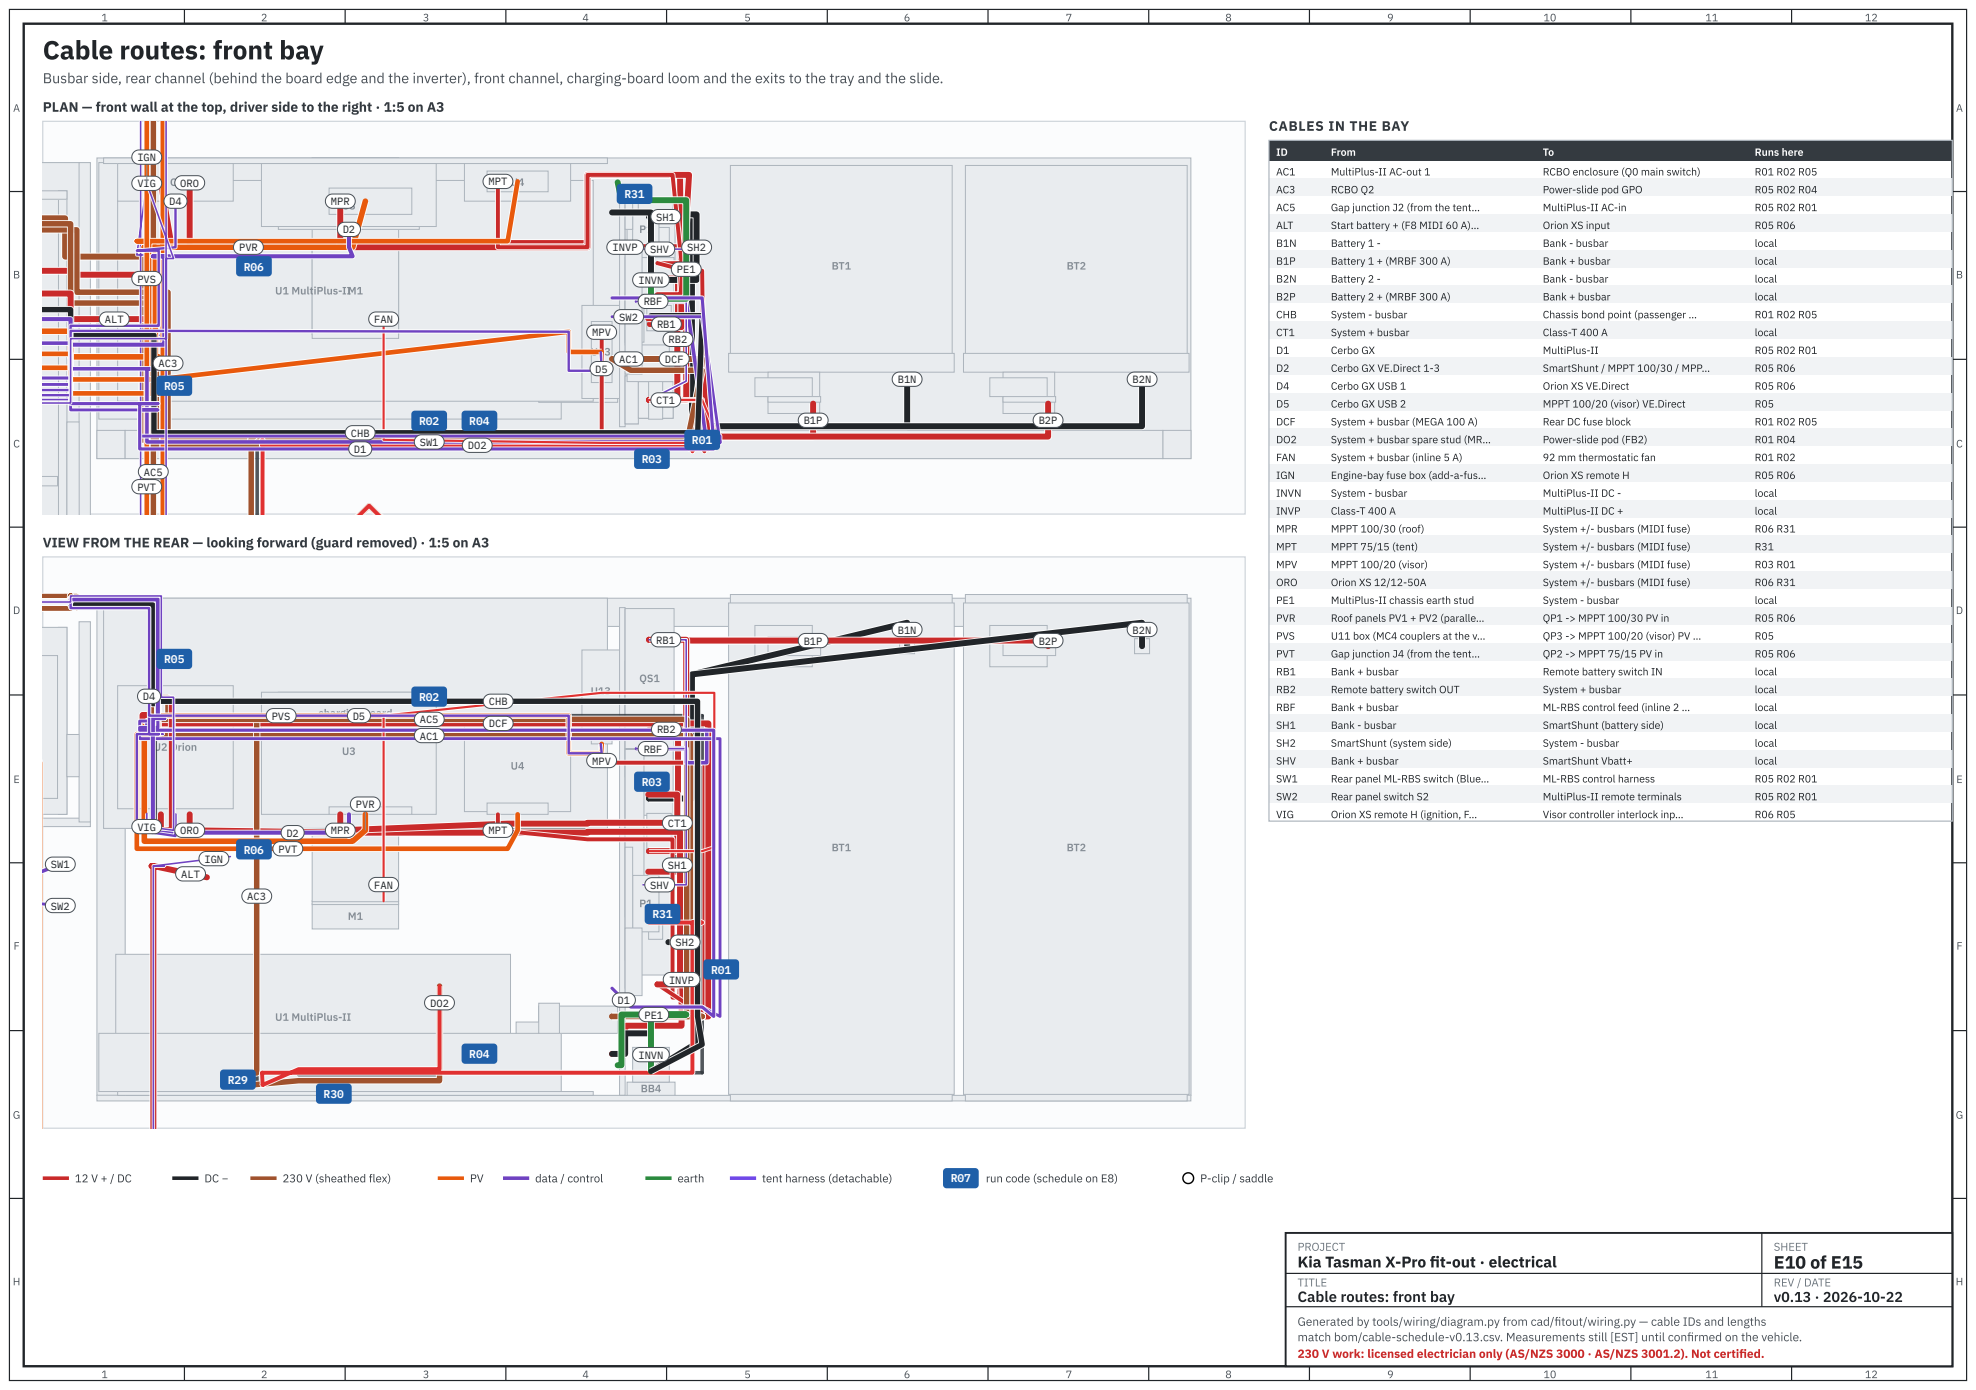
[picture p50: page 10]

Busbar side, rear channel (behind the board edge and the inverter), front channel, charging-board loom and the exits to the tray and the slide.

PLAN — front wall at the top, driver side to the right · 1:5 on A3

CABLES IN THE BAY

VIEW FROM THE REAR — looking forward (guard removed) · 1:5 on A3

PROJECT
Kia Tasman X-Pro fit-out · electrical

Cable routes: front bay

B | B
C | C
D | D
E | E
F | F
G | G

## Cable routes: tray, wall channel, gland plate and rear cabinet

Passenger side of the tub. 230 V (orange) on the wall side of the tray divider, its own drop, gland row and cabinet gland.

PROJECT
Kia Tasman X-Pro fit-out · electrical

SHEET
E11 of E15

Cable routes: tray, wall channel, gland plate and rear cabinet

U1 MultiPlus-II

U2 Orion

U6

XS1

X12

RCBO Q0–Q3

FB1

U5 Cerbo

tray

XS1U6
X1

X2

RCBO Q0–Q3

FB1
U5 Cerbo

tray

R05

R07 | R08
R09 | R10

R32

R11

R12

R33

R13

R14 R15

R05

R07

R08

R09

R10

R32

R12

R33 | R13
R14 | R15

DO1E

AC2

CGX

DO1C
D3

DO1A

DO1D
DO1B

PE2

SW1 D5

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
PVT | AC5 | PVS

VIG
PVR

ALT
IGN

AC2

DO1E
CGX

DO1A

DO1B

DO1D

DO1C

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
SW1 | DCF

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
ALT IGN

VIEW OUTBOARD — from inside the tub toward the passenger wall · 1:6 on A3

PLAN — passenger strip (tray, channel, cabinet) · 1:6 on A3

CABLES IN THE TRAY, CHANNEL AND CABINET

ID | From | To | Runs here
AC1 | MultiPlus-II AC-out 1 | RCBO enclosure (Q0 main switch) | R07 R09 R11
AC2 | RCBO Q1 | Rear panel double GPO | local
AC3 | RCBO Q2 | Power-slide pod GPO | R11 R09 R07
AC4 | RCBO Q3 | Gap junction J1 -> tent servic… | R11 R09
AC5 | Gap junction J2 (from the tent… | MultiPlus-II AC-in | R09 R07
ALT | Start battery + (F8 MIDI 60 A)… | Orion XS input | R32 R10 R08
CGX | DC fuse block | Cerbo GX power in | R33
CHB | System - busbar | Chassis bond point (passenger … | R08 R10 R32
D1 | Cerbo GX | MultiPlus-II | R33 R12 R10 R08
D2 | Cerbo GX VE.Direct 1-3 | SmartShunt / MPPT 100/30 / MPP… | R33 R12 R10 R08
D3 | Cerbo GX (HDMI + USB) | GX Touch 50 | R33 R13
D4 | Cerbo GX USB 1 | Orion XS VE.Direct | R33 R12 R10 R08
D5 | Cerbo GX USB 2 | MPPT 100/20 (visor) VE.Direct | R33 R12 R10 R08
DCF | System + busbar (MEGA 100 A) | Rear DC fuse block | R08 R10 R12 R33
DO1A | DC fuse block | Rear panel Anderson 1 | R33 R13
DO1B | DC fuse block | Rear panel Anderson 2 | R33 R13
DO1C | DC fuse block | Rear panel USB-C x2 | R33 R13
DO1D | DC fuse block | Rear panel 12 V socket | R33 R13
DO1E | USB-C U7 terminals | USB-C U8 terminals | local
DO3 | DC fuse block | Compute box SB50 inlet (under … | R33 R12 R32
DO4 | DC fuse block | Starlink Mini (roof) | R33 R12 R32
DO5 | DC fuse block | Gap junction J3 -> tent (SB50 … | R33 R12 R32
IGN | Engine-bay fuse box (add-a-fus… | Orion XS remote H | R32 R10 R08
PE2 | RCBO enclosure earth bar | Chassis bond point (passenger … | R12 R32
PVR | Roof panels PV1 + PV2 (paralle… | QP1 -> MPPT 100/30 PV in | R32 R10 R08
PVS | U11 box (MC4 couplers at the v… | QP3 -> MPPT 100/20 (visor) PV … | R32 R10 R08
PVT | Gap junction J4 (from the tent… | QP2 -> MPPT 75/15 PV in | R32 R10 R08
SW1 | Rear panel ML-RBS switch (Blue… | ML-RBS control harness | R13 R12 R10 R08
SW2 | Rear panel switch S2 | MultiPlus-II remote terminals | R13 R12 R10 R08
VIG | Orion XS remote H (ignition, F… | Visor controller interlock inp… | R08 R10 R32
VIS | DC fuse block (way 10) | Visor controller U11 (roof) | R33 R12 R32
VSW | Rear panel visor button (S3) | Visor controller U11 (roof) | R13 R12 R32

FIXING

Tray (R07/R08): 120 mm aluminium over the drawer carcass; 230 V outboard of the divider, 12 V inboard; ties through the slots every 120 mm. Wall channel (R09/R10): 22 mm behind the drawer runner panel; two layers of 12 V cables, 230 V in its own drop 135 mm further forward. Gland plate (old 240 V outlet hole, 120 × 90): one grommet row for 230 V (R09), two rows for 12 V (R32); cut the plate from 3 mm aluminium. Cabinet: 12 V through a 100 × 22 slot with a split grommet (R12), 230 V through its own 28 mm gland (R11) beside the RCBO enclosure.

12 V + / DC | DC − | 230 V (sheathed flex) | PV | data / control | earth | tent harness (detachable) | R07 run code (schedule on E8) | P-clip / saddle

## Cable routes: wall cavity, chassis rail, cabin and engine bay

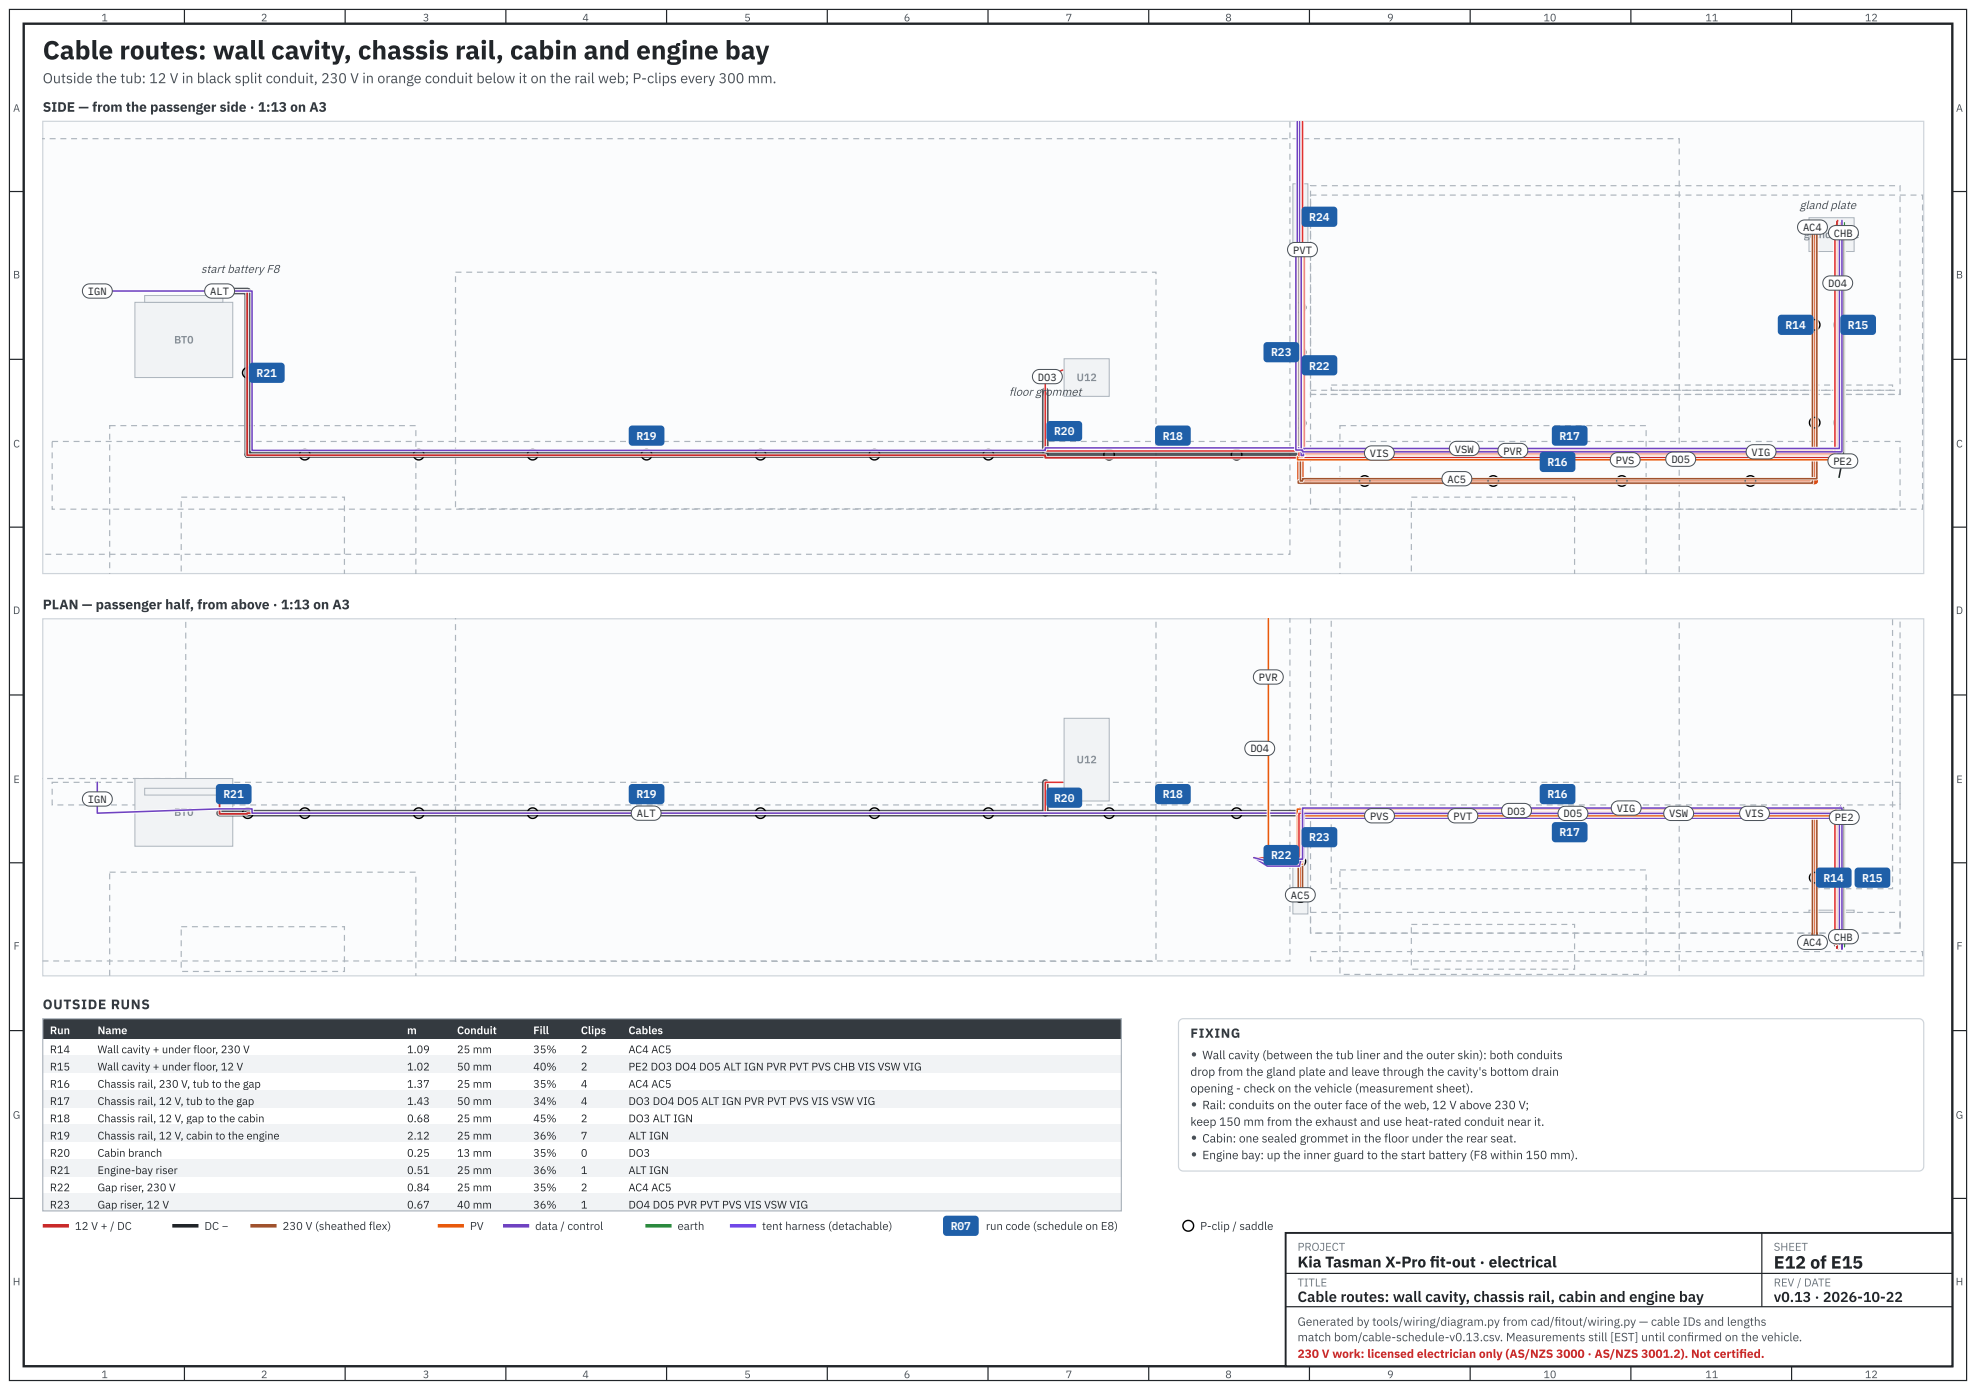
[picture p51: page 12]

Outside the tub: 12 V in black split conduit, 230 V in orange conduit below it on the rail web; P-clips every 300 mm.

SIDE — from the passenger side · 1:13 on A3

PLAN — passenger half, from above · 1:13 on A3

Wall cavity (between the tub liner and the outer skin): both conduits
drop from the gland plate and leave through the cavity's bottom drain
opening - check on the vehicle (measurement sheet).
Rail: conduits on the outer face of the web, 12 V above 230 V;
keep 150 mm from the exhaust and use heat-rated conduit near it.
Cabin: one sealed grommet in the floor under the rear seat.
Engine bay: up the inner guard to the start battery (F8 within 150 mm).

PROJECT
Kia Tasman X-Pro fit-out · electrical

Cable routes: wall cavity, chassis rail, cabin and engine bay

## Cable routes: cab–tub gap, junction box, roof and tent harnesses

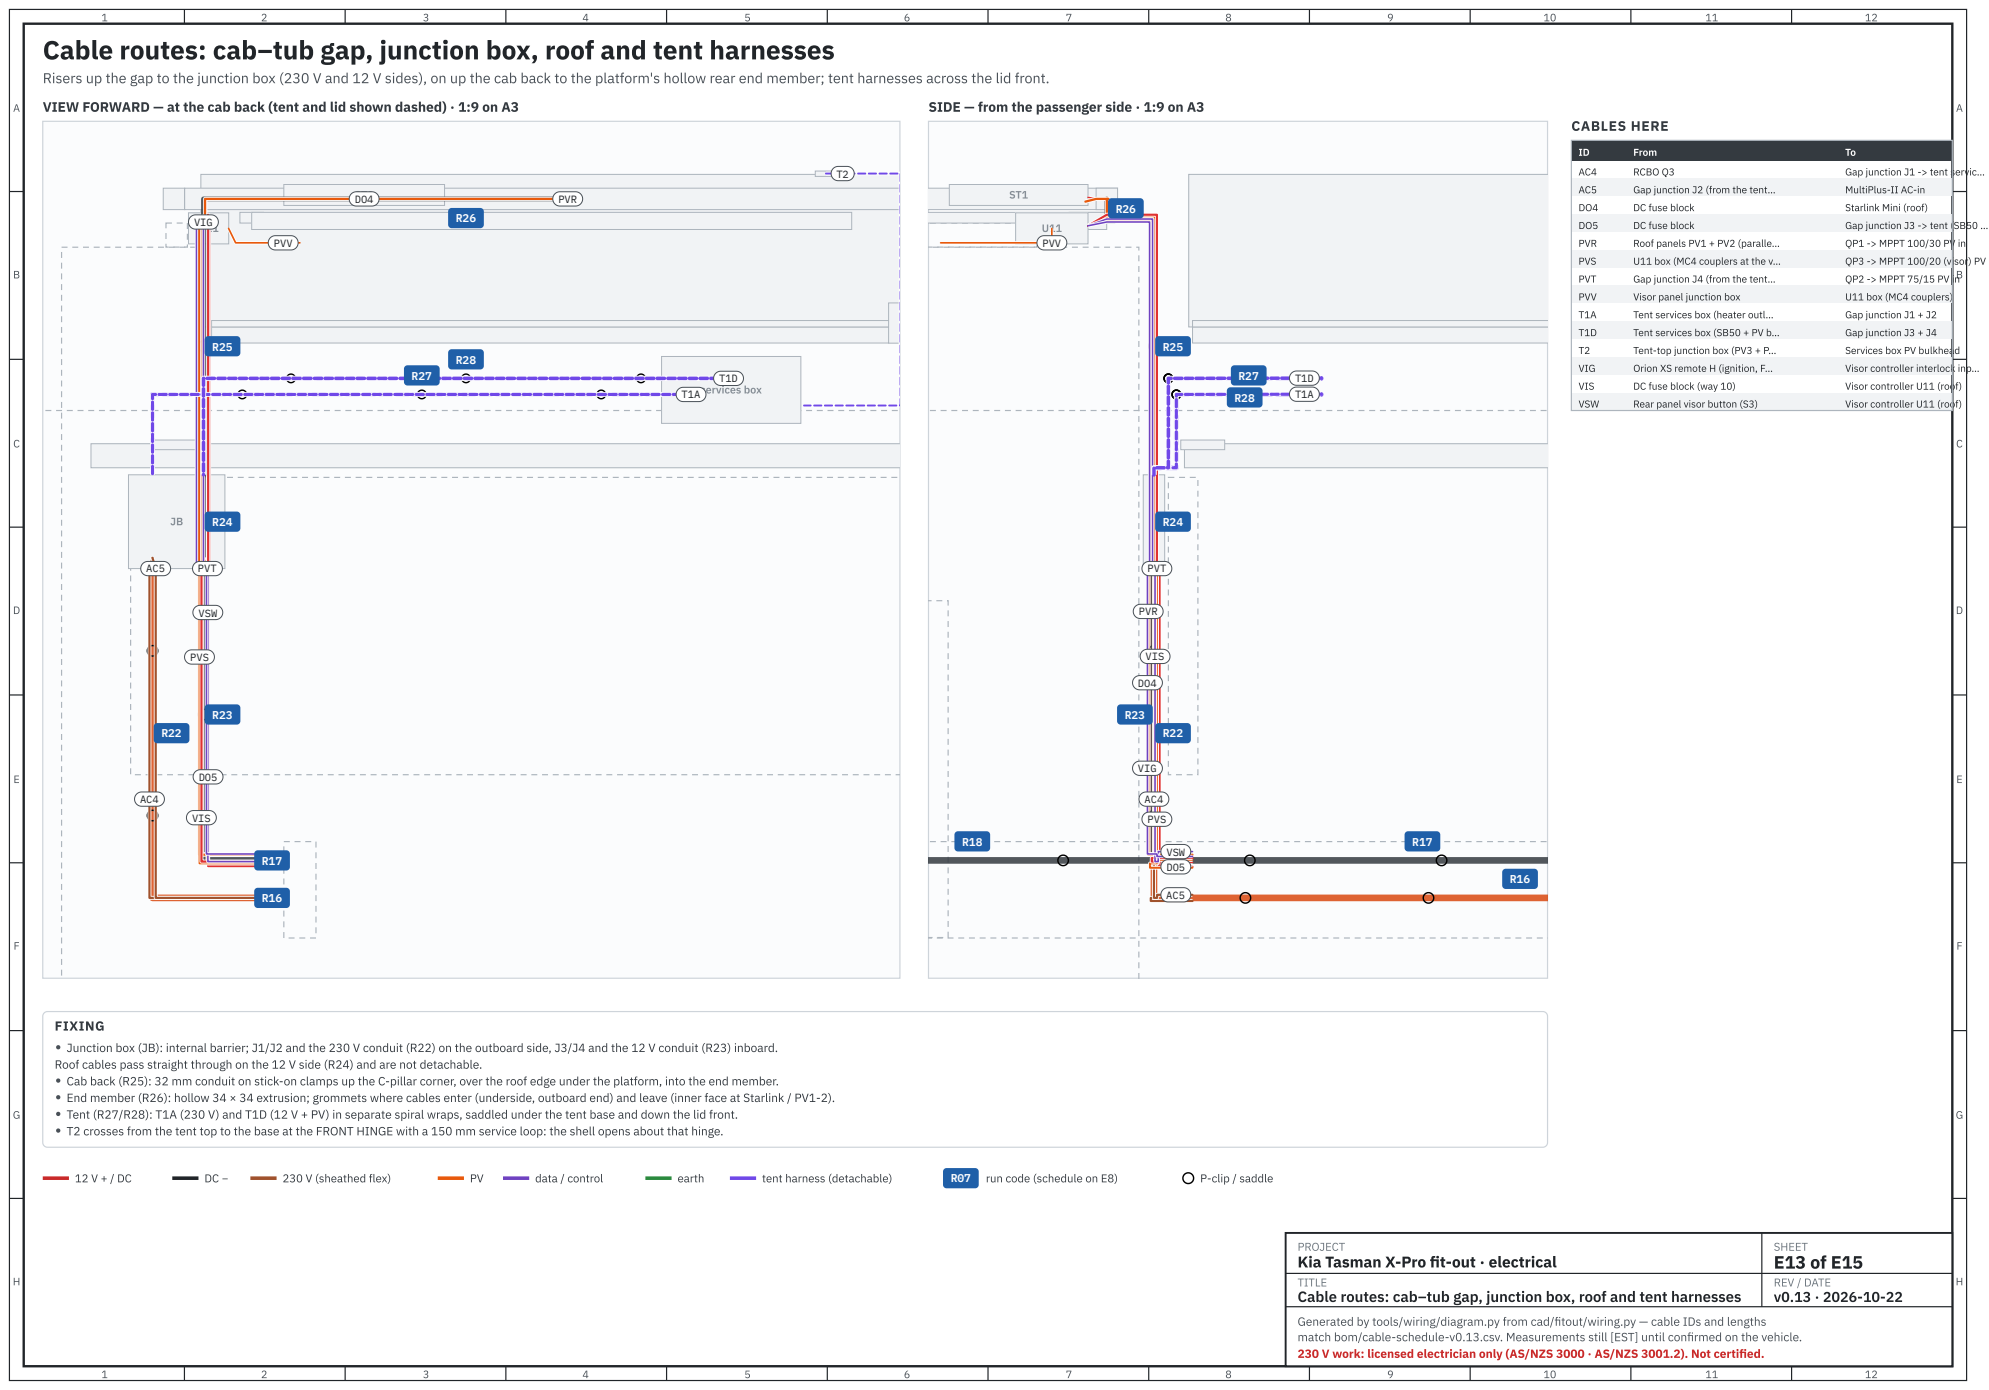
[picture p52: page 13]

Risers up the gap to the junction box (230 V and 12 V sides), on up the cab back to the platform's hollow rear end member; tent harnesses across the lid front.

Junction box (JB): internal barrier; J1/J2 and the 230 V conduit (R22) on the outboard side, J3/J4 and the 12 V conduit (R23) inboard.
Roof cables pass straight through on the 12 V side (R24) and are not detachable.
Cab back (R25): 32 mm conduit on stick-on clamps up the C-pillar corner, over the roof edge under the platform, into the end member.
End member (R26): hollow 34 × 34 extrusion; grommets where cables enter (underside, outboard end) and leave (inner face at Starlink / PV1-2).
Tent (R27/R28): T1A (230 V) and T1D (12 V + PV) in separate spiral wraps, saddled under the tent base and down the lid front.
T2 crosses from the tent top to the base at the FRONT HINGE with a 150 mm service loop: the shell opens about that hinge.

PROJECT
Kia Tasman X-Pro fit-out · electrical

Cable routes: cab–tub gap, junction box, roof and tent harnesses

## Cable routes: power slide (trunk and chain)

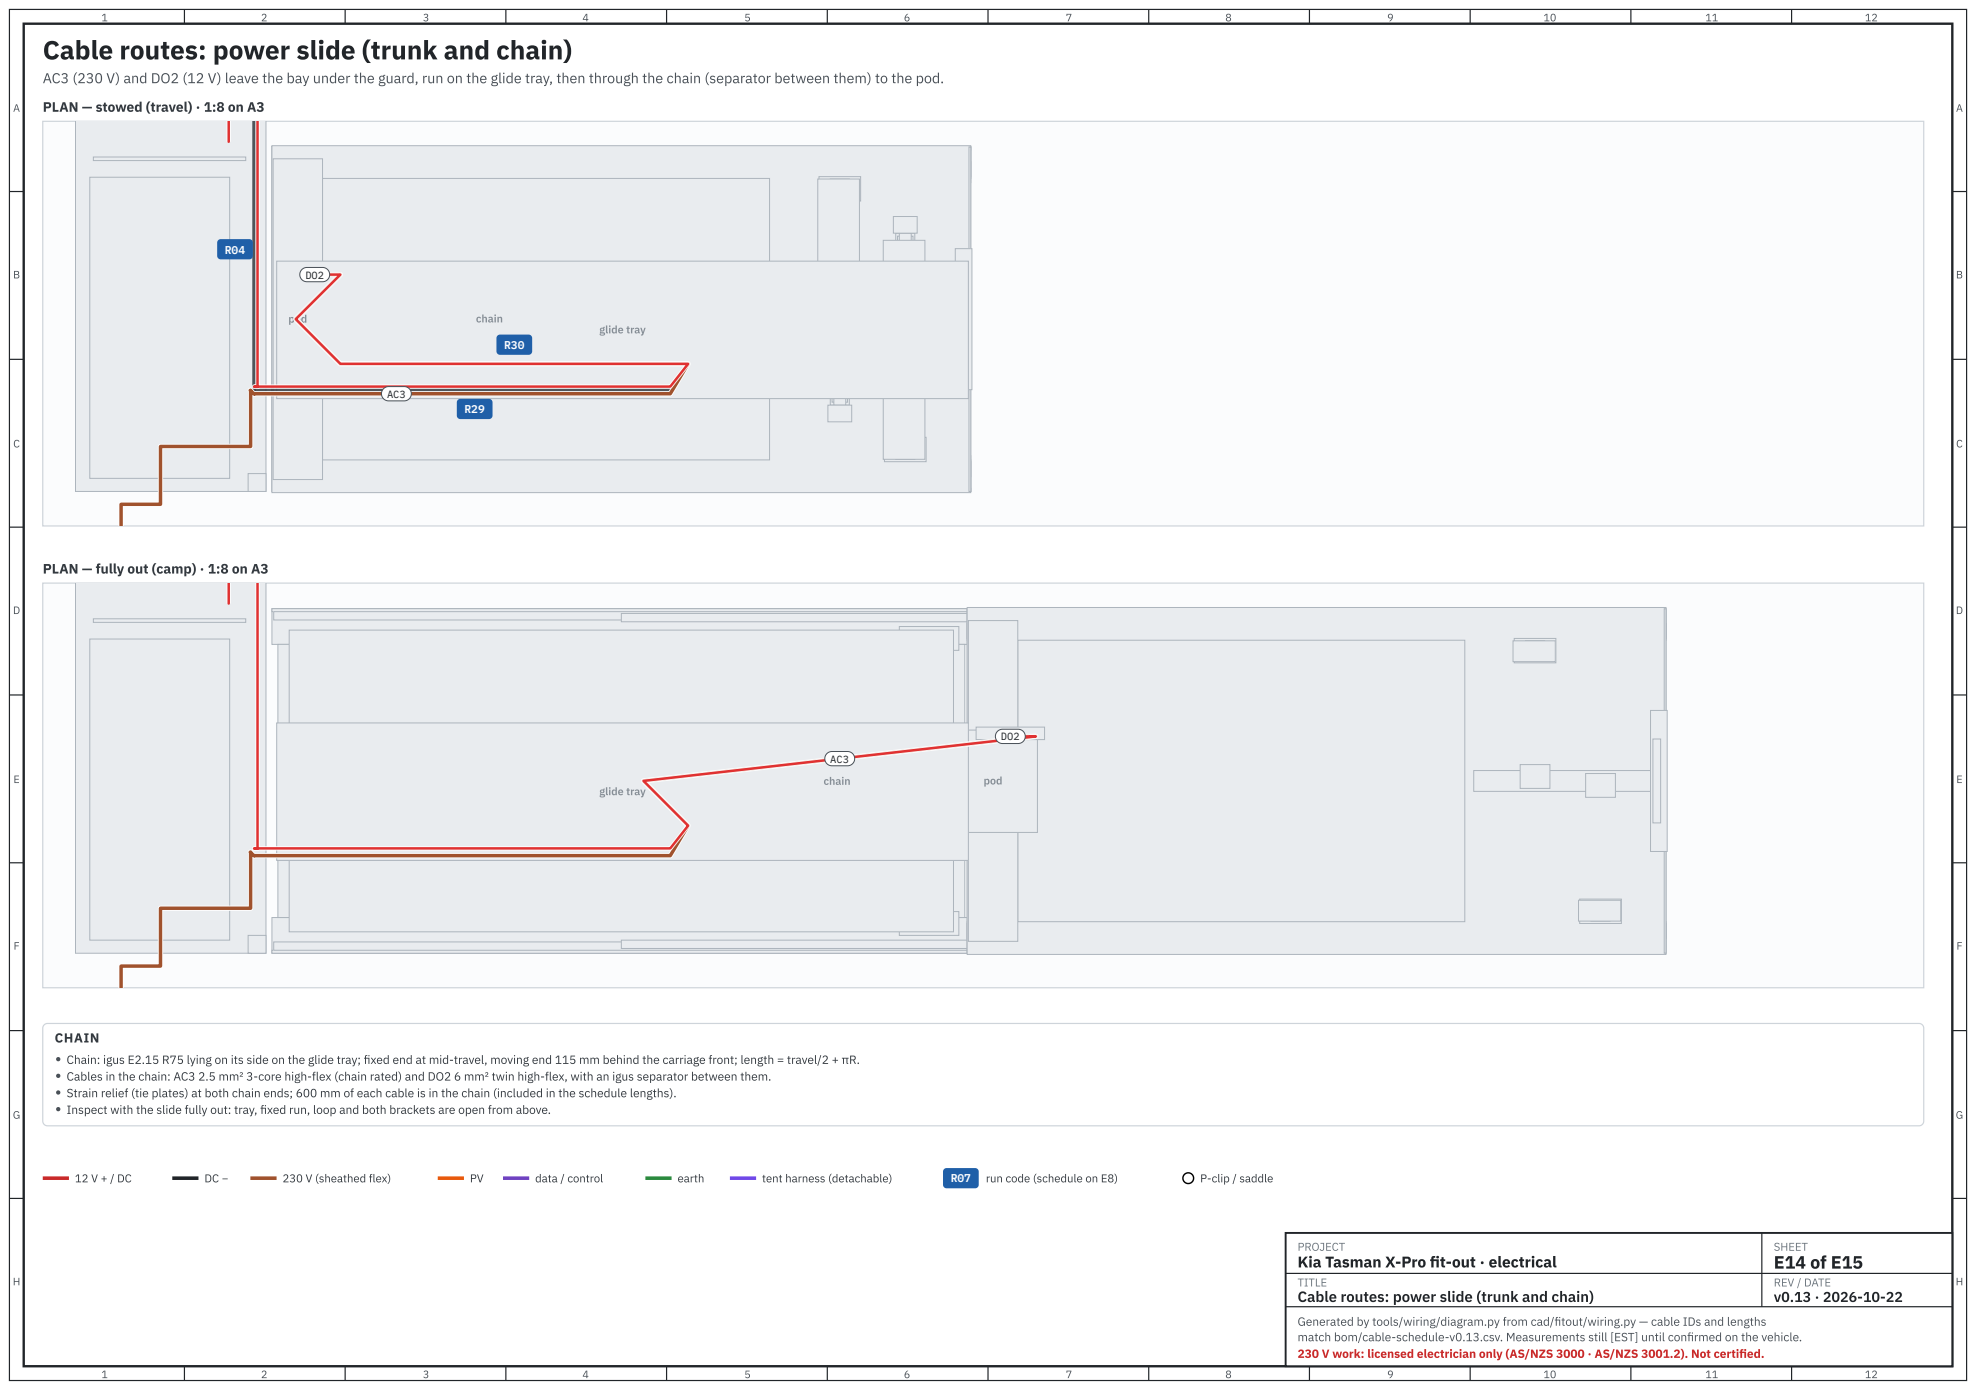
[picture p53: page 14]
SHEET E14 of E15; pod; chain; glide tray; CHAIN; 230 V (sheathed flex); data / control; earth; tent harness (detachable); R07 run code (schedule on E8); P-clip / saddle

AC3 (230 V) and DO2 (12 V) leave the bay under the guard, run on the glide tray, then through the chain (separator between them) to the pod.

PLAN — stowed (travel) · 1:8 on A3

PLAN — fully out (camp) · 1:8 on A3

Chain: igus E2.15 R75 lying on its side on the glide tray; fixed end at mid-travel, moving end 115 mm behind the carriage front; length = travel/2 + πR.
Cables in the chain: AC3 2.5 mm² 3-core high-flex (chain rated) and DO2 6 mm² twin high-flex, with an igus separator between them.
Strain relief (tie plates) at both chain ends; 600 mm of each cable is in the chain (included in the schedule lengths).
Inspect with the slide fully out: tray, fixed run, loop and both brackets are open from above.

PROJECT
Kia Tasman X-Pro fit-out · electrical

Cable routes: power slide (trunk and chain)

B | B
C | C
D | D
E | E
F | F
G | G

## Bundle cross-sections and fill

Every run's cross-section as packed in the model (biggest cables first; twins as two cores). Dashed circle = conduit inside diameter.

PROJECT
Kia Tasman X-Pro fit-out · electrical

SHEET
E15 of E15

Bundle cross-sections and fill

R01 Bay riser, busbar side

AC1 | DCF
AC5 | CHB SW1 D1
DO2 | MPV

10 cables · 700 mm²
AC1 DCF AC5 CHB SW1 D1 SW2 DO2 MPV FAN

R02 Bay rear channel, high

AC1

DCF

AC3 AC5

CHB D1

9 cables · 695 mm²
AC1 DCF AC3 AC5 CHB SW1 D1 SW2 FAN

R03 Bay rear channel, cross link

MPV

1 cables · 46 mm²
MPV

R04 Bay rear channel, low (to the slid

AC3 DO2

2 cables · 132 mm²
AC3 DO2

R05 Bay exit over the inverter

DCF

17 cables · 1162 mm²
AC1 DCF AC3 AC5 ALT CHB D2 PVR SW1 PVS PVT D1 SW2 D4

R31 Bay front channel (chargers to the

MPR

ORO

MPT

3 cables · 278 mm²
MPR ORO MPT

R06 Charging-board loom

ALT

MPR

ORO D2

PVR

PVT D4

9 cables · 632 mm²
ALT MPR ORO D2 PVR PVT D4 IGN VIG

R07 Tray, 230 V compartment

AC1 AC3

AC5

3 cables · 286 mm²
AC1 AC3 AC5

R08 Tray, 12 V compartment

DCF | ALT | CHB D2
PVR | PVS PVT

14 cables · 875 mm²
DCF ALT CHB D2 PVR SW1 PVS PVT D1 SW2 D4 D5 IGN VIG

R09 Wall channel, 230 V drop

AC1 | AC3
AC4 | AC5

4 cables · 373 mm²
AC1 AC3 AC4 AC5

R10 Wall channel, 12 V drop

DCF | ALT | PVR

14 cables · 875 mm²
DCF ALT CHB D2 PVR SW1 PVS PVT D1 SW2 D4 D5 IGN VIG

R32 Gland plate, 12 V rows

ALT | CHB | PVR
DO5 | VIS | PVS
PVT | DO3 | DO4

13 cables · 785 mm²
ALT CHB PVR DO5 VIS VSW PVS PVT DO3 PE2 DO4 IGN VIG

R11 Cabinet, 230 V entry

AC1 AC3

AC4

3 cables · 286 mm²
AC1 AC3 AC4

R12 Cabinet entry (12 V slot)

DCF DO5 VIS

13 cables · 689 mm²
DCF D2 DO5 VIS SW1 VSW D1 SW2 DO3 PE2 DO4 D4 D5

R33 Cabinet top loom

DCF | D3 | D2
DO5 | VIS | D1 DO1A
DO1B | DO3 DO1C DO1D DO4 D4 D5

15 cables · 799 mm²
DCF D3 D2 DO5 VIS D1 DO1A DO1B DO3 DO1C DO1D DO4 D4

R13 Rear-panel loom

D3 | DO1A DO1B

8 cables · 319 mm²
D3 SW1 VSW SW2 DO1A DO1B DO1C DO1D

R14 Wall cavity + under floor, 230 V

AC4 AC5

2 cables · 173 mm² · fill 35% of 25 mm
AC4 AC5

R15 Wall cavity + under floor, 12 V

ALT | CHB
PVR | DO5
VIS | VSW | PVS
PVT | DO3 DO4

13 cables · 785 mm² · fill 40% of 50 mm
ALT CHB PVR DO5 VIS VSW PVS PVT DO3 PE2 DO4 IGN VIG

R16 Chassis rail, 230 V, tub to the ga

AC4 AC5

2 cables · 173 mm² · fill 35% of 25 mm
AC4 AC5

R17 Chassis rail, 12 V, tub to the gap

ALT | PVR
DO5 | VIS | VSW
PVS | PVT | DO3
| DO4

11 cables · 677 mm² · fill 34% of 50 mm
ALT PVR DO5 VIS VSW PVS PVT DO3 DO4 IGN VIG

R18 Chassis rail, 12 V, gap to the cab

ALT | DO3

3 cables · 221 mm² · fill 45% of 25 mm
ALT DO3 IGN

R19 Chassis rail, 12 V, cabin to the e

ALT

2 cables · 176 mm² · fill 36% of 25 mm
ALT IGN

R20 Cabin branch

DO3

1 cables · 46 mm² · fill 35% of 13 mm
DO3

R21 Engine-bay riser

ALT

2 cables · 176 mm² · fill 36% of 25 mm
ALT IGN

R22 Gap riser, 230 V

AC4 AC5

2 cables · 173 mm² · fill 35% of 25 mm
AC4 AC5

R23 Gap riser, 12 V

PVR | DO5
VIS | VSW
PVS | PVT

DO4

8 cables · 455 mm² · fill 36% of 40 mm
PVR DO5 VIS VSW PVS PVT DO4 VIG

R24 Junction box pass-through

PVR | VIS
VSW | PVS | DO4

6 cables · 310 mm²
PVR VIS VSW PVS DO4 VIG

R25 Cab back riser to the roof

PVR | VIS
VSW | PVS | DO4

6 cables · 310 mm² · fill 39% of 32 mm
PVR VIS VSW PVS DO4 VIG

R26 Platform rear end member

PVR

DO4

2 cables · 124 mm²
PVR DO4

R27 Tent harness, 230 V

T1A

1 cables · 173 mm² · fill 35% of 25 mm
T1A

R28 Tent harness, 12 V + PV

T1D

1 cables · 214 mm² · fill 44% of 25 mm
T1D

R29 Slide trunk (fixed, on the glide t

AC3 DO2

2 cables · 132 mm²
AC3 DO2

R30 Power-slide cable chain

AC3 DO2

2 cables · 132 mm²
AC3 DO2

# Schedules

# Cable schedule

Lengths are measured along each cable's routed path in the 3D model, plus 10 % slack and 0.3 m for terminations.

B1P | Bank + | Battery 1 + (MRBF 300 A) | Bank + busbar | 70 mm² tinned, red | MRBF 300 A on terminal | 0.85 | local | vehicle
B1N | Bank - | Battery 1 - | Bank - busbar | 70 mm² tinned, black | - | 1.35 | local | vehicle
B2P | Bank + | Battery 2 + (MRBF 300 A) | Bank + busbar | 70 mm² tinned, red | MRBF 300 A on terminal | 0.85 | local | vehicle
B2N | Bank - | Battery 2 - | Bank - busbar | 70 mm² tinned, black | - | 1.35 | local | vehicle
RB1 | Main + | Bank + busbar | Remote battery switch IN | 120 mm² tinned, red | 2 x MRBF 300 A upstream (parallel) | 0.58 | local | vehicle
RB2 | Main + | Remote battery switch

OUT

System + busbar | 120 mm² tinned, red | - | 0.65 | local | vehicle
SH1 | Main - | Bank - busbar | SmartShunt (battery

side)

120 mm² tinned, black | - | 0.42 | local | vehicle
SH2 | Main - | SmartShunt (system

side)

System - busbar | 120 mm² tinned, black | - | 0.59 | local | vehicle
CT1 | Inverter + | System + busbar | Class-T 400 A | 2 x 50 mm² tinned, red | - | 1.06 | local | vehicle
INVP | Inverter + | Class-T 400 A | MultiPlus-II DC + | 2 x 50 mm² tinned, red | Class-T 400 A | 1.44 | local | vehicle
INVN | Inverter - | System - busbar | MultiPlus-II DC - | 2 x 50 mm² tinned, black | - | 0.98 | local | vehicle
ORO | Charging output | Orion XS 12/12-50A | System +/- busbars (MIDI fuse) | 16 mm² twin | MIDI 70 A | 1.46 | R06 > R31 | vehicle
MPR | Charging

output

MPPT 100/30 (roof) | System +/- busbars
(MIDI fuse)
16 mm² twin | MIDI 40 A | 1.25 | R06 > R31 | vehicle
MPT | Charging

output

MPPT 75/15 (tent) | System +/- busbars
(MIDI fuse)
6 mm² twin | MIDI 40 A (shared with MPV) | 1.02 | R31 | vehicle
MPV | Charging

output

MPPT 100/20 (visor) | System +/- busbars
(MIDI fuse)
| 6 mm² twin | MIDI 40 A (shared with MPT) | 1.16 | R03 > R01 | vehicle
DCF | DC

distribution

System + busbar (MEGA
100 A)
Rear DC fuse block | 35 mm² twin (red/black) | MEGA 100 A | 4.1 | R01 > R02 > R05 > R08 > R10 > R12 > R33 | vehicle
AC1 | AC out | MultiPlus-II AC-out 1 | RCBO enclosure (Q0
| | | main switch)

4 mm² 3-core flex (TPS-flex)

MultiPlus internal limit + 15 A AC-in limit; Q0 2-pole main switch

3.97 | R01 > R02 > R05 > R07 > R09 > R11 | vehicle
AC2 | Rear GPO | RCBO Q1 | Rear panel double

GPO

2.5 mm² 3-core flex | RCBO 10 A 30 mA | 0.45 | local | vehicle
ID | CIRCUIT | FROM | TO | CABLE | PROTECTION | M | ROUTE (RUNS, IN ORDER) | HARNESS

AC3 | Slide GPO | RCBO Q2 | Power-slide pod GPO | 2.5 mm² 3-core high-flex
| | | | (chain rated)
RCBO 10 A 30 mA | 5.76 | R11 > R09 > R07 > R05 > R02 > R04 > R29 > R30 | vehicle
AC4 | Tent heater

GPO

RCBO Q3 | Gap junction J1 ->
tent services box
outlet

2.5 mm² 3-core flex, UV
rated
RCBO 10 A 30 mA | 4.45 | R11 > R09 > R14 > R16 > R22 | vehicle
AC5 | Shore inlet | Gap junction J2 (from the

tent's 15 A inlet)

MultiPlus-II AC-in | 2.5 mm² 3-core flex (15
A)

RCBO 16 A 30 mA 2-pole in
the services box + MultiPlus AC-in limit 15 A
7.36 | R22 > R16 > R14 > R09 > R07 > R05 > R02 > R01 | vehicle
PE2 | AC earth to

chassis

RCBO enclosure earth
bar

Chassis bond point
(passenger rail, near
the gland)
6 mm² green/yellow | - | 1.91 | R12 > R32 > R15 | vehicle
DO1A | Rear

Anderson 1

DC fuse block | Rear panel Anderson
1
6 mm² twin | ATC 30 A | 1.03 | R33 > R13 | vehicle
DO1B | Rear

Anderson 2

DC fuse block | Rear panel Anderson
2
6 mm² twin | ATC 30 A | 1.09 | R33 > R13 | vehicle
DO1C | Rear USB-C

x2

DC fuse block | Rear panel USB-C x2 | 4 mm² twin | ATC 25 A | 0.96 | R33 > R13 | vehicle
DO1D | Rear 12 V

socket

DC fuse block | Rear panel 12 V
socket
4 mm² twin | ATC 15 A | 1.05 | R33 > R13 | vehicle
DO1E | Rear USB-C

link

USB-C U7 terminals | USB-C U8 terminals | 4 mm² twin | ATC 25 A (DO1C) | 0.42 | local | vehicle
DO2 | Slide DC | System + busbar spare

stud (MRBF 30 A); - to
the system - busbar
Power-slide pod (FB2) | 6 mm² twin high-flex | MRBF 30 A (F17); FB2: X3
20 A, X7 15 A
3.58 | R01 > R04 > R29 > R30 | vehicle
DO3 | Cabin

compute feed

DC fuse block | Compute box SB50
inlet (under the rear
seat)
6 mm² twin | ATC 15 A (+ BatteryProtect
and per-device fuses in the box)
4.79 | R33 > R12 > R32 > R15 > R17 > R18 > R20 | vehicle
DO4 | Starlink Mini | DC fuse block | Starlink Mini (roof) | 4 mm² twin + DC barrel
| | | | lead
ATC 7.5 A | 5.77 | R33 > R12 > R32 > R15 > R17 > R23 > R24 > R25 > R26 | vehicle
DO5 | Tent 12 V | DC fuse block | Gap junction J3 ->

tent (SB50 red)

10 mm² twin | ATC 20 A | 4.46 | R33 > R12 > R32 > R15 > R17 > R23 | vehicle
ALT | Alternator

charge

Start battery + (F8 MIDI
60 A); - to the body earth
Orion XS input | 25 mm² twin (+/-), tinned | MIDI 60 A at the start
battery
9.05 | R21 > R19 > R18 > R17 > R15 > R32 > R10 > R08 > R05 > R06 | vehicle
IGN | Orion ignition

sense

Engine-bay fuse box
(add-a-fuse, ignition)
Orion XS remote H | 1.0 mm² single | ATC 2 A add-a-fuse | 9.37 | R21 > R19 > R18 > R17 > R15 > R32 > R10 > R08 > R05 > R06 | vehicle
PVR | Roof PV | Roof panels PV1 + PV2

(parallel, MC4 Y-branch)

QP1 -> MPPT 100/30
PV in

10 mm² solar pair (UV) 2-pole DC PV isolator QP1 32 A

7.98 | R26 > R25 > R24 > R23 > R17 > R15 > R32 > R10 > R08 > R05 > R06 | vehicle
PVT | Tent PV | Gap junction J4 (from the

tent panels)

QP2 -> MPPT 75/15
PV in
6 mm² solar pair (UV) | 2-pole DC PV isolator QP2 32
A
6.46 | R23 > R17 > R15 > R32 > R10 > R08 > R05 > R06 | vehicle
PVS | Visor PV | U11 box (MC4 couplers

at the visor chain end)

QP3 -> MPPT 100/20
(visor) PV in
6 mm² solar pair (UV) | 2-pole DC PV isolator QP3 32
A
7.25 | R25 > R24 > R23 > R17 > R15 > R32 > R10 > R08 > R05 | vehicle
ID | CIRCUIT | FROM | TO | CABLE | PROTECTION | M | ROUTE (RUNS, IN ORDER) | HARNESS

SW1 Battery switch

control

Rear panel ML-RBS
switch (Blue Sea 2155)

ML-RBS control
harness

4-core 1.0 mm² (+12 V
feed, control, LED,
ground)
2 A inline at bank + (RBF) | 3.75 | R13 > R12 > R10 > R08 > R05 > R02 > R01 | vehicle
RBF | Battery switch

control

Bank + busbar | ML-RBS control feed
(inline 2 A)
1.0 mm² red | ATC 2 A inline | 0.57 | local | vehicle
SHV | Shunt sense | Bank + busbar | SmartShunt Vbatt+ | 0.75 mm² red (supplied
| | | | lead)
1 A inline (supplied) | 0.84 | local | vehicle
FAN | Inverter fan | System + busbar (inline 5

A)

92 mm thermostatic
fan
1.5 mm² twin | ATC 5 A inline | 1.34 | R01 > R02 | vehicle
CGX | Cerbo GX

power

DC fuse block | Cerbo GX power in | 0.75 mm² twin | ATC 2 A | 0.74 | R33 | vehicle
PE1 | Inverter case

earth

MultiPlus-II chassis earth
stud
System - busbar | 50 mm² green/yellow | - | 0.68 | local | vehicle
CHB | Chassis bond | System - busbar | Chassis bond point

(passenger rail, near
the gland)
25 mm² black | - | 4.7 | R01 > R02 > R05 > R08 > R10 > R32 > R15 | vehicle
SW2 | Inverter

remote on/off

Rear panel switch S2 | MultiPlus-II remote
terminals
2-core 0.75 mm² | - | 3.98 | R13 > R12 > R10 > R08 > R05 > R02 > R01 | vehicle
D1 | VE.Bus | Cerbo GX | MultiPlus-II | RJ45 VE.Bus cable | - | 4.35 | R33 > R12 > R10 > R08 > R05 > R02 > R01 | vehicle
D2 | VE.Direct | Cerbo GX VE.Direct 1-3 | SmartShunt / MPPT 100/30 / MPPT 75/15 | VE.Direct cables x3 | - | 3.55 | R33 > R12 > R10 > R08 > R05 > R06 | vehicle
D4 | VE.Direct | Cerbo GX USB 1 | Orion XS VE.Direct | VE.Direct to USB
| | | | interface
- | 3.29 | R33 > R12 > R10 > R08 > R05 > R06 | vehicle
D5 | VE.Direct | Cerbo GX USB 2 | MPPT 100/20 (visor)

VE.Direct

VE.Direct to USB
interface
- | 3.56 | R33 > R12 > R10 > R08 > R05 | vehicle
D3 | Display | Cerbo GX (HDMI + USB) | GX Touch 50 | GX Touch cable (HDMI +
| | | | USB)
- | 1.01 | R33 > R13 | vehicle
PVV | Visor PV

(moving)

Visor panel junction box U11 box (MC4 couplers)

4 mm² solar pair, high-flex (chain rated)

- | 2.29 | local | vehicle
VIS | Visor drive

power

DC fuse block (way 10) Visor controller U11 (roof)

10 mm² twin | ATC 20 A | 5.3 | R33 > R12 > R32 > R15 > R17 > R23 > R24 > R25 | vehicle
VSW | Visor control | Rear panel visor button

(S3)

Visor controller U11
(roof)

4-core 0.75 mm² (deploy,
stow, LED, common)
- | 5.17 | R13 > R12 > R32 > R15 > R17 > R23 > R24 > R25 | vehicle
VIG | Visor interlock | Orion XS remote H

(ignition, F9)

Visor controller
interlock input
1.0 mm² single | F9 2 A (shared) | 6.93 | R06 > R05 > R08 > R10 > R32 > R15 > R17 > R23 > R24 > R25 | vehicle
T1A | Tent harness

230 V

Tent services box (heater
outlet + shore inlet)

Gap junction J1 + J2 2 x 2.5 mm² 3-core flex, sheathed together, UV
rated

Q4 2-pole RCBO 16 A (AC-in); Q3 (AC-out)

3.82 | R27 | tent
T1D | Tent harness

12 V + PV

Tent services box (SB50
+ PV bulkhead)

Gap junction J3 + J4 10 mm² twin (12 V) + 6 mm² solar pair (PV),
sheathed together
DO5 20 A (12 V) | 1.92 | R28 | tent
ID | CIRCUIT | FROM | TO | CABLE | PROTECTION | M | ROUTE (RUNS, IN ORDER) | HARNESS

# Cable to buy

0.75 mm² red (supplied lead) | 0.8 | 1
0.75 mm² twin | 0.7 | 1
1.0 mm² red | 0.6 | 1
1.0 mm² single | 16.3 | 19
1.5 mm² twin | 1.3 | 2
10 mm² solar pair (UV) | 8.0 | 10
10 mm² twin | 9.8 | 12
10 mm² twin (12 V) + 6 mm² solar pair (PV), sheathed together | 1.9 | 3
120 mm² tinned, black | 1.0 | 2
120 mm² tinned, red | 1.2 | 2
16 mm² twin | 2.7 | 4
2 x 2.5 mm² 3-core flex, sheathed together, UV rated | 3.8 | 5
2 x 50 mm² tinned, black | 1.0 | 2
2 x 50 mm² tinned, red | 2.5 | 3
2-core 0.75 mm² | 4.0 | 5
2.5 mm² 3-core flex | 0.5 | 1
2.5 mm² 3-core flex (15 A) | 7.4 | 9
2.5 mm² 3-core flex, UV rated | 4.5 | 6
2.5 mm² 3-core high-flex (chain rated) | 5.8 | 7
25 mm² black | 4.7 | 6
25 mm² twin (+/-), tinned | 9.1 | 11
35 mm² twin (red/black) | 4.1 | 5
4 mm² 3-core flex (TPS-flex) | 4.0 | 5
4 mm² solar pair, high-flex (chain rated) | 2.3 | 3
4 mm² twin | 2.4 | 3
4 mm² twin + DC barrel lead | 5.8 | 7
4-core 0.75 mm² (deploy, stow, LED, common) | 5.2 | 6
4-core 1.0 mm² (+12 V feed, control, LED, ground) | 3.8 | 5
ID | CIRCUIT | FROM | TO | CABLE | PROTECTION | M | ROUTE (RUNS, IN ORDER) | HARNESS
CABLE | MODEL M | BUY M (+15 %)

50 mm² green/yellow | 0.7 | 1
6 mm² green/yellow | 1.9 | 3
6 mm² solar pair (UV) | 15.4 | 18
6 mm² twin | 9.1 | 11
6 mm² twin high-flex | 3.6 | 5
70 mm² tinned, black | 2.7 | 4
70 mm² tinned, red | 1.7 | 2
GX Touch cable (HDMI + USB) | 1.0 | 2
RJ45 VE.Bus cable | 4.3 | 6
VE.Direct cables x3 | 3.5 | 5
VE.Direct to USB interface | 6.8 | 8

# Route schedule

Each physical run: where it goes, how the cables are held, and which cables share it. Fill is the cables' cross-section over the conduit's (≤ 50 % for split conduit that the cables are laid into).

R01 | Bay riser, busbar side | 0.38 | 10 | open | 12 V | rear channel behind the busbars (gap to battery 1); cable ties to
| | | | | | the rear posts' saddle bar every 150 mm

### MPV DCF AC1 AC5 DO2 SW1 FAN CHB SW2 D1

R02 | Bay rear channel, high | 0.58 | 9 | open | 12 V | behind the distribution board edge and the inverter, under the
| | | | | | top rail; adhesive tie mounts on the guard frame

### DCF AC1 AC3 AC5 SW1 FAN CHB SW2 D1

R03 Bay rear channel, cross

link

0.11 | 1 | open | 12 V | behind the board edge, visor MPPT output | MPV
R04 | Bay rear channel, low (to

the slide)

0.85 | 2 | open | 12 V | along the base tray behind the inverter, then down from the high
| | | | channel; P-clips to the base tray

### AC3 DO2

R05 | Bay exit over the inverter | 0.33 | 17 | open | 12 V | across the top of the inverter compartment and over the
| | | | | | passenger drawer carcass; grommet strip on the carcass edge

### DCF AC1 AC3 AC5 ALT IGN PVR PVT PVS SW1 CHB SW2 D1 D2 D4 D5 VIG

R31 Bay front channel

(chargers to the MIDI
fuses)
0.36 | 3 | open | 12 V | between the front wall and the distribution board's front edge,
| | | | under the charging board; tie mounts on the board edge

### ORO MPR MPT

R06 | Charging-board loom | 0.67 | 9 | open | 12 V | down the front of the inverter compartment and along under the
| | | | | | chargers' terminal faces; tie mounts on the board

### ORO MPR ALT IGN PVR PVT D2 D4 VIG

R07 | Tray, 230 V compartment | 1.42 | 3 | tray | 230
| | | | | V

aluminium tray, 230 V side of the divider; ties through the tray slots every 120 mm

### AC1 AC3 AC5

R08 | Tray, 12 V compartment | 1.26 | 14 | tray | 12 V | aluminium tray, 12 V side of the divider; ties through the tray
| | | | | | slots every 120 mm

### DCF ALT IGN PVR PVT PVS SW1 CHB SW2 D1 D2 D4 D5 VIG

CABLE | MODEL M | BUY M (+15 %)
RUN | NAME | M | N | CONTAINMENT | FILL | V | FIXING | CABLES

R09 | Wall channel, 230 V drop | 0.2 | 4 | channel | 230
| | | | | V

22 mm channel behind the drawer runner panel, then out through the 230 V grommet row of the gland plate; ties to adhesive mounts

### AC1 AC3 AC4 AC5

R10 | Wall channel, 12 V drop | 0.18 | 14 | channel | 12 V | 22 mm channel behind the drawer runner panel (two layers);
| | | | | | ties to adhesive mounts on the tub wall

### DCF ALT IGN PVR PVT PVS SW1 CHB SW2 D1 D2 D4 D5 VIG

R32 | Gland plate, 12 V rows | 0.02 | 13 | open | 12 V | 12 V grommet rows of the gland plate in the old outlet hole | PE2 DO3 DO4 DO5 ALT IGN PVR PVT PVS CHB VIS VSW VIG
R11 | Cabinet, 230 V entry | 0.22 | 3 | open | 230 V | LV gland in the cabinet top, down the outboard corridor to the RCBO side gland

### AC1 AC3 AC4

R12 | Cabinet entry (12 V slot) | 0.22 | 13 | open | 12 V | down the wall channel and through the 12 V slot (split grommet)
| | | | | | in the drawer floor and cabinet top

### DCF PE2 DO3 DO4 DO5 SW1 SW2 D1 D2 D4 D5 VIS VSW

R33 | Cabinet top loom | 0.36 | 15 | open | 12 V | forward along the outboard corridor beside the RCBO enclosure,
| | | | | | under the cabinet top; tie mounts

### DCF DO1A DO1B DO1C DO1D DO3 DO4 DO5 CGX D1 D2 D4 D5 D3 VIS

R13 | Rear-panel loom | 0.26 | 8 | open | 12 V | vertical loom between the RCBO enclosure lid and the rear-
| | | | | | panel devices; spiral wrap, ties to the door stile

### DO1A DO1B DO1C DO1D SW1 SW2 D3 VSW

R14 Wall cavity + under floor,

230 V

1.09 | 2 | orange corrugated
| | conduit 25 mm ID
35% | 230
V

LV grommet row in the gland plate; orange corrugated conduit down the wall cavity and under the floor to the rail

### AC4 AC5

R15 Wall cavity + under floor,

12 V

1.02 | 13 | split conduit 50 mm ID | 40% | 12 V | 12 V grommet row in the gland plate; black split corrugated
| | | | | conduit down the wall cavity and under the floor to the rail

### PE2 DO3 DO4 DO5 ALT IGN PVR PVT PVS CHB VIS VSW VIG

R16 Chassis rail, 230 V, tub to

the gap

1.37 | 2 | orange corrugated
| | conduit 25 mm ID
35% | 230
V

orange corrugated conduit on the rail web, below the 12 V conduit; rubber-lined P-clips every 300 mm

### AC4 AC5

R17 Chassis rail, 12 V, tub to

the gap

1.43 | 11 | split conduit 50 mm ID | 34% | 12 V | black split conduit on the rail web; rubber-lined P-clips into M6
| | | | | rivnuts every 300 mm (no welding or drilling the flanges)

### DO3 DO4 DO5 ALT IGN PVR PVT PVS VIS VSW VIG

R18 Chassis rail, 12 V, gap to

the cabin

0.68 | 3 | split conduit 25 mm ID | 45% | 12 V | black split conduit; P-clips every 300 mm | DO3 ALT IGN
R19 | Chassis rail, 12 V, cabin to

the engine bay

2.12 | 2 | split conduit 25 mm ID | 36% | 12 V | black split conduit (heat-rated near the exhaust); P-clips every
| | | | | 300 mm

### ALT IGN

R20 | Cabin branch | 0.25 | 1 | split conduit 13 mm ID | 35% | 12 V | up to a sealed grommet in the floor under the rear seat (sealant
| | | | | | | + rubber grommet), then to the compute box SB50 inlet

DO3

R21 | Engine-bay riser | 0.51 | 2 | split conduit 25 mm ID | 36% | 12 V | heat-rated split conduit up the inner guard behind the start
| | | | | | | battery; P-clips to existing guard holes

### ALT IGN

R22 | Gap riser, 230 V | 0.84 | 2 | orange corrugated
| | | | conduit 25 mm ID
35% | 230
V

orange conduit up the cab-tub gap to the LV gland in the junction box base

### AC4 AC5

R23 | Gap riser, 12 V | 0.67 | 8 | split conduit 40 mm ID | 36% | 12 V | black conduit up the cab-tub gap to the ELV gland in the junction
| | | | | | | box base

### DO4 DO5 PVR PVT PVS VIS VSW VIG

R24 | Junction box pass-through | 0.18 | 6 | open | 12 V | through the junction box on the 12 V side of its barrier (roof
| | | | | | cables are not detachable)

### DO4 PVR PVS VIS VSW VIG

R25 | Cab back riser to the roof | 0.57 | 6 | split conduit 32 mm ID | 39% | 12 V | black conduit up the back of the cab (C-pillar corner), stick-on
| | | | | | | cable clamps every 250 mm, over the roof edge under the
| | | | | | | platform

### DO4 PVR PVS VIS VSW VIG

R26 | Platform rear end member | 0.72 | 2 | hollow | 12 V | inside the hollow rear end member (34 x 34 mm), in through a
| | | | | | grommeted hole in its underside, out through grommets on its

### DO4 PVR

RUN | NAME | M | N | CONTAINMENT | FILL | V | FIXING | CABLES

inner face

R27 | Tent harness, 230 V | 1.45 | 1 | spiral wrap 25 mm | 35% | 230
| | | | | | V

orange sheathed harness in UV-stable spiral wrap, saddles under the tent base and on the lid front

T1A

R28 | Tent harness, 12 V + PV | 1.46 | 1 | spiral wrap 25 mm | 44% | 12 V | black sheathed harness in spiral wrap, saddles under the tent
| | | | | | | base and on the lid front

T1D

R29 Slide trunk (fixed, on the

glide tray)

0.71 | 2 | open | 12 V | under the bay guard into the front of the cassette, along the
| | | | glide tray outboard of the fixed run; ties to the tray lip

### AC3 DO2

R30 | Power-slide cable chain | 0.84 | 2 | chain | 12 V | igus E2.15 (R75) lying on its side, with a separator between the
| | | | | | 230 V and 12 V cables; strain-relief at both ends

### AC3 DO2

# Protection

F1 | MRBF terminal fuse (Blue

Sea 5191)

300 A | Battery 1 + stud | B1P
F2 | MRBF terminal fuse (Blue

Sea 5191)

300 A | Battery 2 + stud | B2P
F3 | Class-T fuse + holder

(Blue Sea 5502)

400 A | BB3 system + bus | CT1, INVP (MultiPlus DC)
F4 | MIDI fuse | 70 A | BB3 stud | ORO (Orion XS output)
F5 | MIDI fuse | 40 A | BB3 stud | MPR (MPPT 100/30 output)
F6 | MIDI fuse | 40 A | BB3 stud | MPT (MPPT 75/15) and MPV (MPPT 100/20) outputs, 6 mm² each
F7 | MEGA fuse | 100 A | BB3 stud | DCF (feed to FB1)
F8 | MIDI fuse + holder | 60 A | Start battery +, engine bay | ALT
F9 | Add-a-fuse, ignition

circuit

2 A Engine-bay fuse
box

IGN

F10 | Inline ATC holder | 2 A | BB1 bank + bus | RBF, SW1 (ML-RBS control)
F11 | Inline fuse (supplied with SmartShunt) | 1 A | BB1 bank + bus | SHV
F12 | Inline ATC holder | 5 A | BB3 stud | FAN
FB1 1–10 | ATC blade fuses in FB1 (Blue Sea 5026) | see E3 | Rear control cabinet | DO1A–D, DO3–DO5, CGX, VIS (not DO2)
F13 | ATC in FB2 | 15 A | Power slide pod | pod 12 V socket X7
F14 | ATC in FB2 | 20 A | Power slide pod | pod Anderson X3
F17 | MRBF terminal fuse (Blue Sea 5191) | 30 A | BB3 system + busbar, spare stud | DO2 (power-slide pod)

# FB1 fuse block ways

1 | Rear Anderson 1 | 30 A | DO1A
2 | Rear Anderson 2 | 30 A | DO1B
3 | Rear USB-C ×2 | 25 A | DO1C
4 | Rear 12 V socket | 15 A | DO1D
5 | spare (pod moved to the bay) | – | –
6 | Cabin compute feed | 15 A | DO3
7 | Starlink Mini | 7.5 A | DO4
8 | Tent 12 V | 20 A | DO5
9 | Cerbo GX | 2 A | CGX
10 | Visor drive | 20 A | VIS
11 | spare | – | –
12 | spare | – | –

# Before power-up

Measure the real cable runs: these lengths come from [EST] positions in the model.

Confirm the ML-RBS control-wire colours and switch wiring against the Blue Sea 7713 instructions.

Set every charger to iTechworld's LiFePO₄ voltages; set the Orion XS input limit to 25–30 A.

Torque every stud, then re-check after the first corrugated road.

Electrician: earth continuity, polarity, RCD trip tests on shore power and in inverter mode.

RUN | NAME | M | N | CONTAINMENT | FILL | V | FIXING | CABLES
REF | DEVICE | RATING | LOCATION | PROTECTS | WAY | CIRCUIT | ATC | CABLE

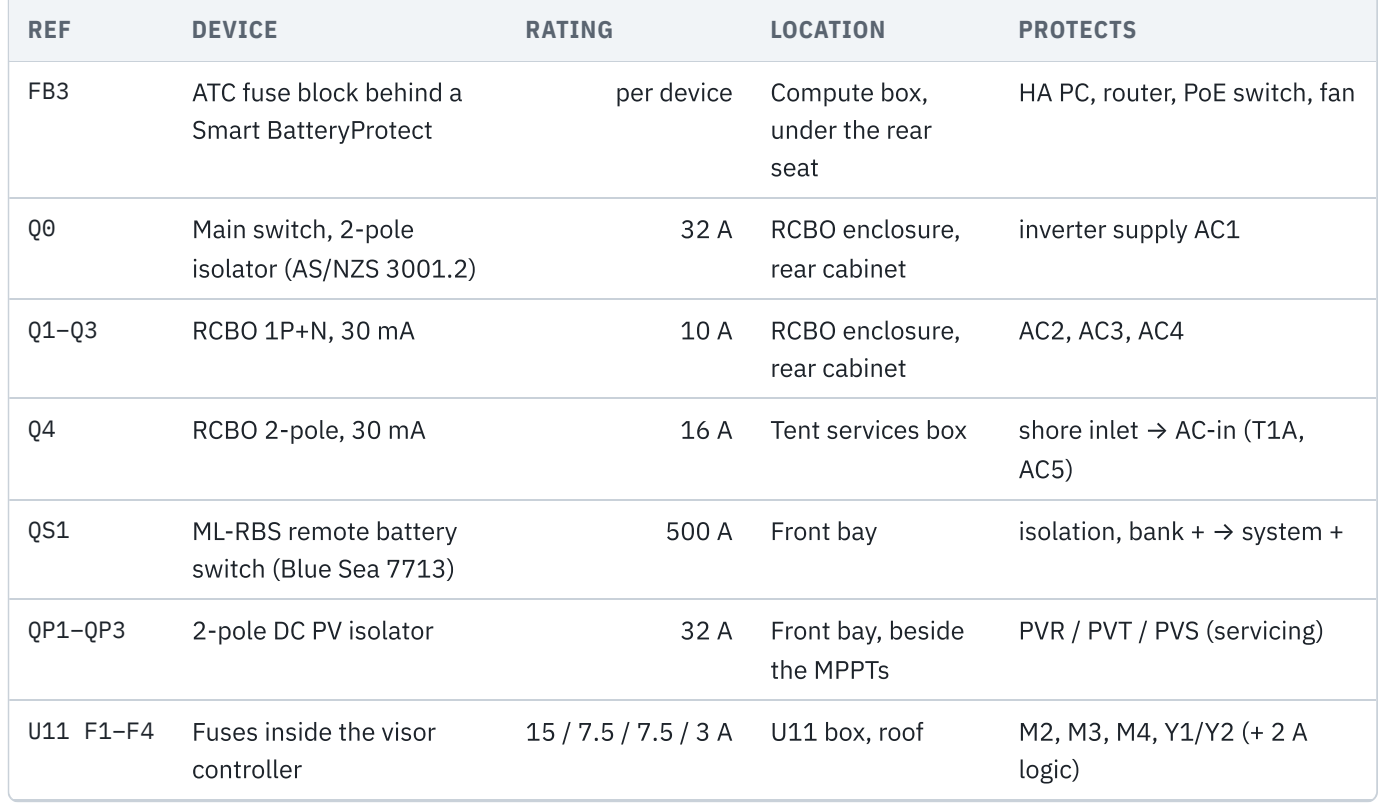
[picture p54: figure]
ATC fuse block behind a; Smart BatteryProtect; per device; Compute box,; under the rear; seat; HA PC, router, PoE switch, fan; Main switch, 2-pole; isolator (AS/NZS 3001.2); RCBO enclosure,; rear cabinet; inverter supply AC1; RCBO 1P+N, 30 mA; RCBO 2-pole, 30 mA; Tent services box; shore inlet → AC-in (T1A,; ML-RBS remote battery; switch (Blue Sea 7713); 2-pole DC PV isolator; Front bay, beside; the MPPTs; PVR / PVT / PVS (servicing); Fuses inside the visor; controller; logic); REF; DEVICE; RATING; LOCATION; PROTECTS

500 A | Front bay | isolation, bank + → system +
15 / 7.5 / 7.5 / 3 A | U11 box, roof | M2, M3, M4, Y1/Y2 (+ 2 A

# Component register

BT1, BT2 | House batteries 12.8 V 400 Ah | iTechworld iTech400X Pro | Front bay, on end | E2
BB1–BB4 | Busbars (bank ±, system ±) | Blue Sea PowerBar 600 A | Front bay distribution column | E2
QS1 | Remote battery switch | Blue Sea ML-RBS 7713 (12 V) | Front bay | E2, E6
P1 | Battery monitor | Victron SmartShunt 500 A | Front bay | E2, E6
U1 | Inverter/charger | Victron MultiPlus-II 12/3000/120-32 230 V | Front bay, lying flat | E2, E5, E6
U2 | DC-DC charger | Victron Orion XS 12/12-50A | Charging board | E4, E6
U3 | Solar charger, roof | Victron SmartSolar MPPT 100/30 | Charging board | E4, E6
U13 | Solar charger, visor | Victron SmartSolar MPPT 100/20 | Front bay, passenger face of the distribution board | E4, E6
U4 | Solar charger, tent | Victron SmartSolar MPPT 75/15 | Charging board | E4, E6
M1 | Inverter fan | 92 mm 12 V thermostatic | Above the inverter | E2
FB1 | Fuse block 12-way + neg bus | Blue Sea 5026 | Rear control cabinet | E3
FB2 | Local fuse holder + studs | 2-way ATC | Power slide pod | E3
U12, FB3 | Compute box: BatteryProtect + 6-way ATC block | Victron SBP-65, Blue Sea 5025-class | Under the rear seat | E3
U5 | GX device | Victron Cerbo GX MK2 | Rear control cabinet | E3, E6
U6 | Display | Victron GX Touch 50 | Rear panel | E6
S1 | Battery isolate switch | Blue Sea 2155 Contura SPDT with LED | Rear panel | E6
S2 | Inverter on/off switch | SPST rocker | Rear panel | E6
S3 | Visor deploy / stow button | momentary ON-OFF-ON rocker with LED | Rear panel | E6, E9
REF | ITEM | MODEL | LOCATION | SHEETS

RCBO | RCBO enclosure, Q0–Q3 | IP66 DIN enclosure, 2-pole main switch + 3 × RCBO 10 A 30 mA | Rear control cabinet | E5
XS1 | Rear double GPO | IP66 10 A (Clipsal 56 series) | Rear panel | E5
XS2 | Pod GPO | Flush 10 A, faces up | Power slide pod | E5
XS3 | Tent heater outlet | Clipsal 56SO310A IP66 10 A | Tent services box | E5, E7
XI1, Q4 | Shore inlet + RCBO | Clipsal 56AI315 15 A + 2-pole RCBO 16 A 30 mA | Tent services box | E5, E7
X1–X5 | Anderson SB50 sockets | Anderson SB50 red + flush housing | Rear panel ×2, pod, compute-box inlet, tent box | E3
X6, X7 | 12 V sockets | Narva / Blue Sea | Rear panel, pod | E3
U7, U8 | Dual USB-C sockets, 100 W PD + 20 W each | Treklo dual USB-C 120 W, 12–24 V | Rear panel ×2 | E3
JB | Gap junction box | IP66 polycarbonate with an internal barrier (230 V | 12 V) | Cab–tub gap, passenger corner | E7, E13
J1 | 230 V out connector | IP66 10 A socket (vehicle) / plug (tent) | Gap junction box | E5, E7
J2 | 230 V in connector | IP66 15 A inlet (vehicle) / extension socket (tent) | Gap junction box | E5, E7
J3 | 12 V tent connector | Anderson SB50 red | Gap junction box | E3, E7
J4 | Tent PV connector | Anderson SB50 grey | Gap junction box | E4, E7
PV1, PV2 | Roof panels 190 W + 130 W | Victron BlueSolar (parallel) | Roof platform | E4
PV5 | Visor panel ~250 W | semi-flexible on honeycomb backing (own MPPT, U13) | Slide-out visor | E4, E9
U11 | Visor controller | 12 V PLC / µC + 2 × dual H-bridge, per-channel fuses, IP66 box | Under the platform, rear passenger corner | E3, E9
M2 | Slide gearmotor | 12 V worm gearmotor, self-locking | Roof platform, rear cross-member | E9
M3, M4 | Tilt drives | 12 V worm rotary actuators | Hinge beam ends | E9
Y1, Y2 | Front latches | 12 V solenoid, spring-locked (fail-locked) | Platform front | E9
B1–B4 | Limit switches | IP67 roller-lever, NO | Rails and hinge beam | E9
BZ1 | Not-stowed buzzer | 12 V piezo | Visor controller lid | E9
PV3, PV4 | Tent panels 2 × 100 W | Sunman eArc flexible (series) | Tent roof | E4
ST1 | Satellite internet | Starlink Mini | Roof platform, inside the frame | E3, E6
BT0, G1, FBX | Vehicle start battery, alternator, fuse box | factory | Engine bay | E4

Generated by tools/wiring/diagram.py from cad/fitout/wiring.py and the routed 3D model. Rebuild: cd cad && ../.venv/bin/python build.py && cd .. && python3 tools/wiring/diagram.py.

REF | ITEM | MODEL | LOCATION | SHEETS
