Kieran-who/kia-tasman-fitout/docs/wiring/wiring-diagram-v0.11.pdf

A | A
B | B
C | C
D | D
E | E
F | F
G | G
H | H

# System overview: locations and cable bundles

Where each part lives and which cables share each run. Bundles are worked out from the routed 3D model. Circuits on sheets E2–E7 and E9.

PROJECT
Kia Tasman X-Pro fit-out · electrical

SHEET
E1 of E9

TITLE
System overview: locations and cable bundles

REV / DATE
v0.11 · 2026-10-21

Generated by tools/wiring/diagram.py from cad/fitout/wiring.py — cable IDs and lengths match bom/cable-schedule-v0.11.csv. Measurements still [EST] until confirmed on the vehicle.

230 V work: licensed electrician only (AS/NZS 3000 · AS/NZS 3001.2). Not certified.

PASSENGER CHASSIS RAIL

TUB

Roof platform

PV1 190 W + PV2 130 W + PV5 visor 250 W ST1 Starlink, U11 visor drive (E9)

Tent (detachable)

services box: XI1 inlet, Q4 RCBO, XS3 outlet, X5 PV3 + PV4 2 × 100 W flexible (series)

Gap junction box

J1–J4 keyed connectors (tent) glands for the roof cables

Engine bay

BT0 start battery + F8 60 A MIDI
FBX fuse box: F9 2 A add-a-fuse (IGN)

Cabin, under the rear seat

X4 SB50 inlet → U12 compute box

HA PC, router, PoE switch

Factory-outlet gland

passenger rear tub wall

Wall drop + tray

drop beside the gland; tray under the lid

Front bay

BT1/BT2, F1/F2, BB1–BB4, QS1, P1, F3 U1 MultiPlus-II, U2 Orion XS, U3/U4 MPPTs F4–F7 MIDI/MEGA, M1 fan

Rear control cabinet

FB1 fuse block, RCBO enclosure (Q1–Q3) U5 Cerbo GX, rear panel: U6, S1, S2,
XS1 GPO, X1/X2, U7/U8, X6

Power slide pod

FB2, XS2 GPO, X3 Anderson, X7 12 V

1 CABLE
DO3

2 CABLES

### AC3, DO2

3 CABLES

### DO3, ALT, IGN

2 CABLES

### ALT, IGN

12 CABLES

### AC4, AC5, DO3, DO4, DO5, ALT PVR, PVT, IGN, VIS, VSW, VIG

9 CABLES

### AC4, AC5, DO4, DO5, PVR, PVT VIS, VSW, VIG

13 CABLES

### AC4, AC5, DO3, DO4, DO5, ALT PVR, PVT, IGN, CHB, VIS, VSW VIG

2 CABLES

### ALT, IGN

13 CABLES

### AC4, AC5, DO3, DO4, DO5, ALT PVR, PVT, IGN, CHB, VIS, VSW VIG

5 CABLES
DO4, PVR, VIS, VSW, VIG | 2 CABLES
| T1, T2

14 CABLES

### DCF, AC1, AC5, ALT, PVR, PVT SW1, IGN, CHB, SW2, D1, D2 D4, VIG

13 CABLES
DCF, | AC1, AC4, DO3, DO4, DO5
SW1, | SW2, D1, D2, D4, VIS

### VSW

internal: B1P, B1N, B2P, B2N, RB1, RB2, SH1, SH2, CT1, INVP, INVN, ORO, MPR, MPT, RBF, SHV, FAN, PE1

internal: AC2, DO1A, DO1B, DO1C, DO1D, CGX, D3

internal: PVV

ROUTING RULES

Every cable that leaves the tub goes out through the factory 240 V

outlet hole (passenger rear wall) and along the passenger chassis rail.

Nothing passes through the load lid.

The tent harness (dashed) unplugs at the gap junction, so the tent

lifts off with its services box and solar.
All switching is at the rear panel: battery isolate (S1 → QS1),

inverter on/off (S2), GX Touch 50.
Line weight ∝ number of cables in the run.

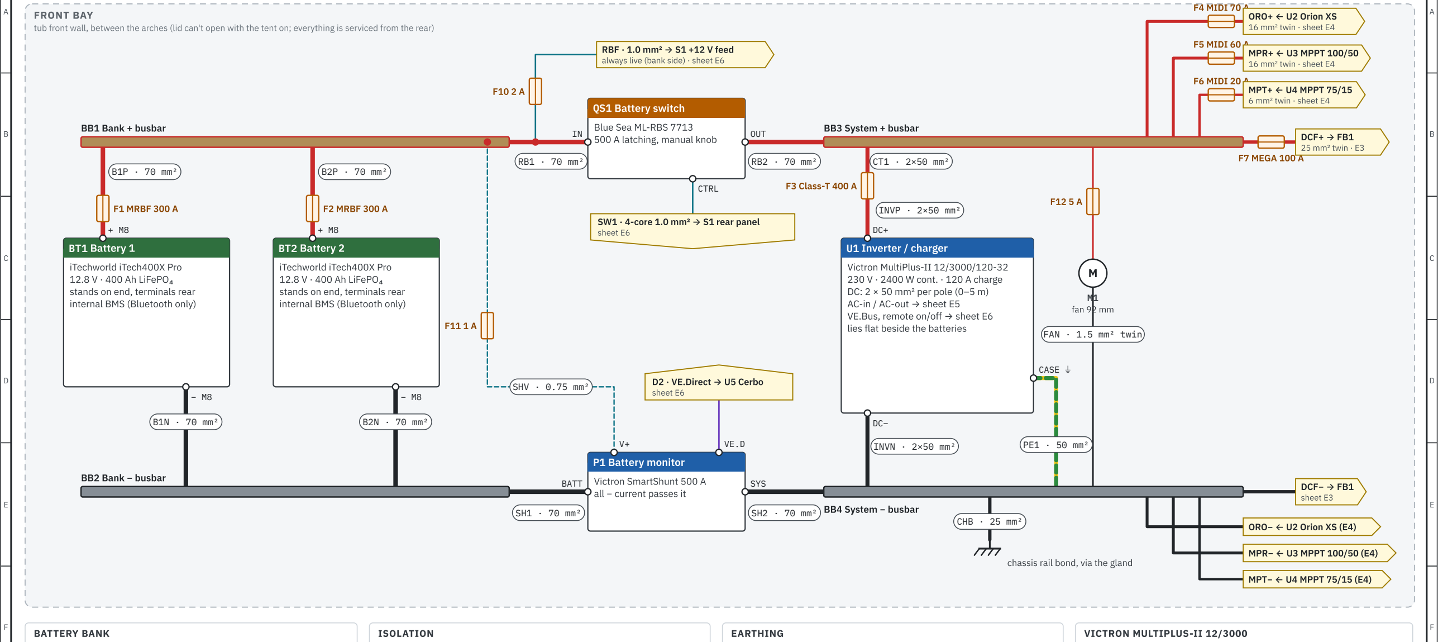
[picture p66: figure]
FRONT BAY; BB1 Bank + busbar; BB2 Bank − busbar; F1 MRBF 300 A; F2 MRBF 300 A; BB3 System + busbar; BB4 System − busbar; F3 Class-T 400 A; fan 92 mm; F4 MIDI 70 A; F5 MIDI 60 A; F6 MIDI 20 A; F7 MEGA 100 A; BT1 Battery 1; iTechworld iTech400X Pro 12.8 V · 400 Ah LiFePO₄; stands on end, terminals rear; internal BMS (Bluetooth only); BT2 Battery 2; QS1 Battery switch; Blue Sea ML-RBS 7713; 500 A latching, manual knob; OUT; CTRL; P1 Battery monitor; Victron SmartShunt 500 A; all − current passes it; BATT; SYS; U1 Inverter / charger; Victron MultiPlus-II 12/3000/120-32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

G | G

# DC power: battery bank and main distribution

Front bay, between the wheel arches. 12.8 V LiFePO₄ bank → isolation → protection → system busbars.

PROJECT
Kia Tasman X-Pro fit-out · electrical

SHEET
E2 of E9

DC power: battery bank and main distribution

DC + (red) | DC − (black) | Protective earth (green/yellow) | Data (VE.Bus / VE.Direct / USB) | Control (12 V switched)

Signal / sense

LEGEND · line weight ∝ conductor size · ID · size tags = cable schedule IDs · purple ▶◀ = detachable connector · yellow flags = continues on another sheet

tub front wall, between the arches (lid can't open with the tent on; everything is serviced from the rear)

Cut B1P = B2P and B1N = B2N to identical length

with identical lugs, so the batteries share current.

F1/F2 MRBF 300 A sit directly on each + stud.

70 mm² tinned, fine-strand; tinned lugs crimped

with a hex crimper, adhesive heat-shrink.

Torque every stud to the maker's figure; re-check

after the first 500 km of corrugations.

QS1 opens the main + between bank and system.

Only the SmartShunt sense (F11) and QS1's own

control feed (F10) stay live when it is open.

QS1 has a manual knob if the control fails.

Turn the inverter off (S2) before closing QS1:

limits the inrush into the MultiPlus capacitors.

One bond only: BB4 → chassis rail (CHB, 25 mm²).

MultiPlus case → BB4 (PE1). Victron: same size

as the DC negative cable.

Orion XS is non-isolated: start-battery − and

house − are common through ALT (sheet E4).

F3: Class-T 400 A, Blue Sea 5502 holder.

CT1 / INVP / INVN: 2 × 50 mm² per pole.
Keep INVP/INVN together, ≤ 1 m each; they pass

the cable window in the board (v0.9).

MIDI F4–F6 and MEGA F7 on the BB3 studs.

# DC distribution: fuse block and 12 V outlets

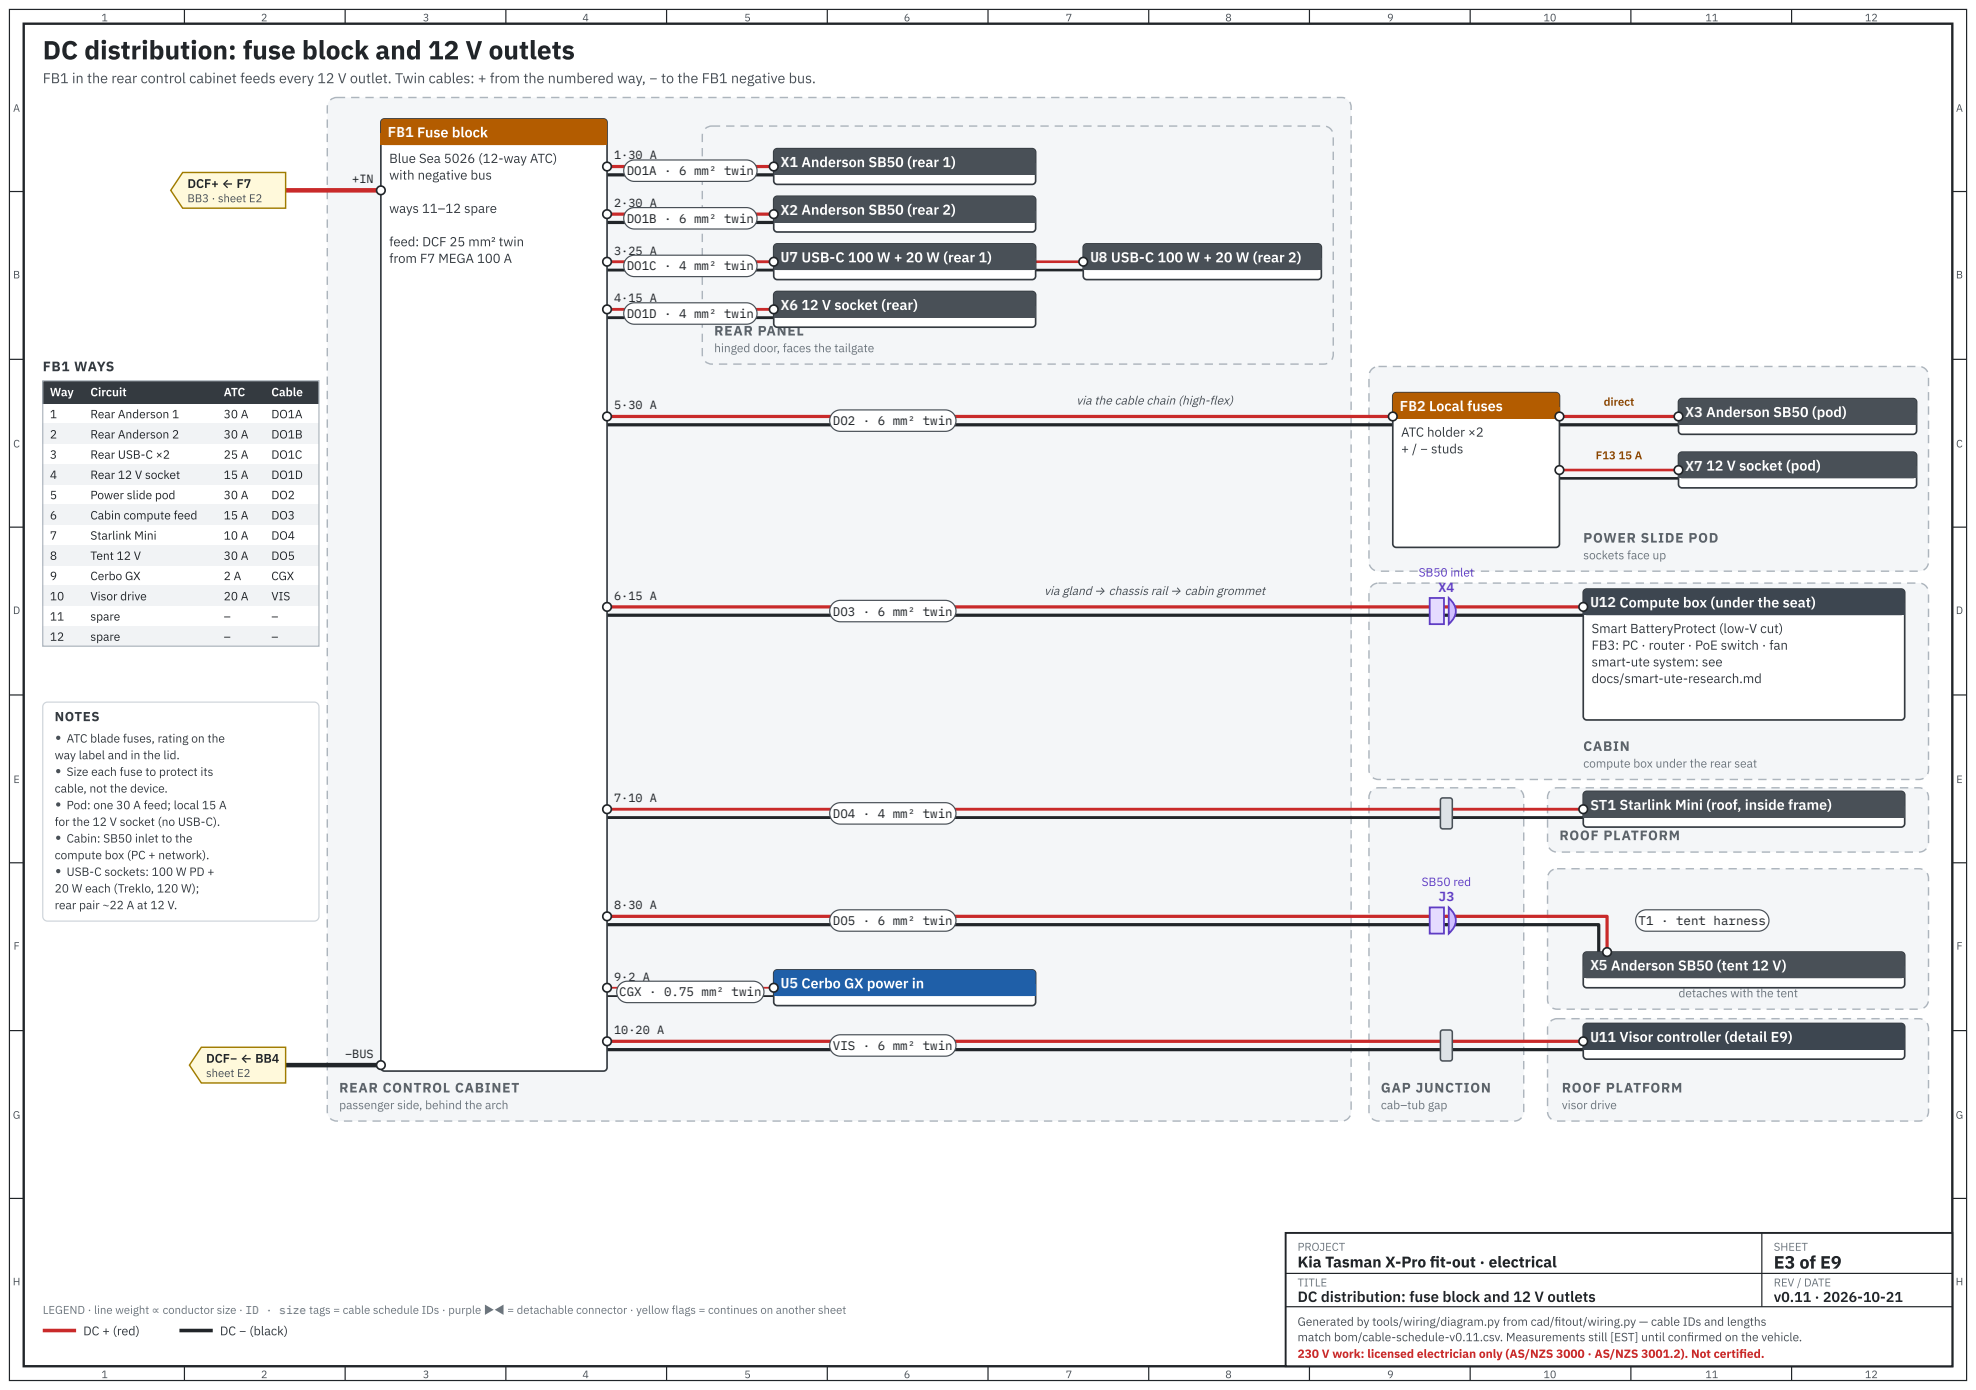
[picture p67: page 3]

FB1 in the rear control cabinet feeds every 12 V outlet. Twin cables: + from the numbered way, − to the FB1 negative bus.

Blue Sea 5026 (12-way ATC)
with negative bus

feed: DCF 25 mm² twin
from F7 MEGA 100 A

hinged door, faces the tailgate

via gland → chassis rail → cabin grommet

U12 Compute box (under the seat)

Smart BatteryProtect (low-V cut)
FB3: PC · router · PoE switch · fan
smart-ute system: see
docs/smart-ute-research.md

ATC blade fuses, rating on the
way label and in the lid.
Size each fuse to protect its
cable, not the device.
Pod: one 30 A feed; local 15 A
for the 12 V socket (no USB-C).
Cabin: SB50 inlet to the
compute box (PC + network).
USB-C sockets: 100 W PD +
20 W each (Treklo, 120 W);
rear pair ~22 A at 12 V.

compute box under the rear seat

ST1 Starlink Mini (roof, inside frame)

U5 Cerbo GX power in

detaches with the tent

passenger side, behind the arch

PROJECT
Kia Tasman X-Pro fit-out · electrical

DC distribution: fuse block and 12 V outlets

# Charging: alternator (DC-DC) and solar

Three independent chargers on the front-wall board, each with its own MIDI fuse to the system busbars (sheet E2).

ENGINE BAY; ROOF PLATFORM; fixed array; TENT ROOF; detachable array; GAP JUNCTION; FRONT BAY: CHARGING BOARD; front wall, above the inverter; F8 MIDI 60 A; gland; QP1 PV isolator; SB50 grey; QP2 PV isolator; F4 MIDI 70 A; F5 MIDI 60 A; F6 MIDI 20 A; G1 Alternator; smart / variable; BT0 Start battery; factory 12 V AGM/EFB; FBX Engine fuse box; ignition add-a-fuse; IGN; U2 DC-DC charger; Victron Orion XS 12/12-50A; non-isolated, 50 A out; input limit 25–30 A (alternator; rating unknown) VE.Direct → Cerbo USB (E6); OUT+; OUT−; BlueSolar; visor (E9); U3 MPPT roof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

PROJECT
Kia Tasman X-Pro fit-out · electrical

SHEET
E4 of E9

Charging: alternator (DC-DC) and solar

DC + (red) | DC − (black) | PV + | PV − | Signal / sense | Factory vehicle wiring

Absorption / float / no temperature compensation set to iTechworld's LiFePO₄ figures in all three chargers (the BMS has no Victron link).

Orion XS: charger mode, input current limit 25–30 A until the alternator rating is known; engine running detected by IGN on H.
DVCC on with the SmartShunt as the battery monitor (Venus OS ≥ 3.20). QP1/QP2 are 2-pole DC isolators for servicing.

# 230 V AC: shore inlet, inverter output, RCBOs and outlets

J2

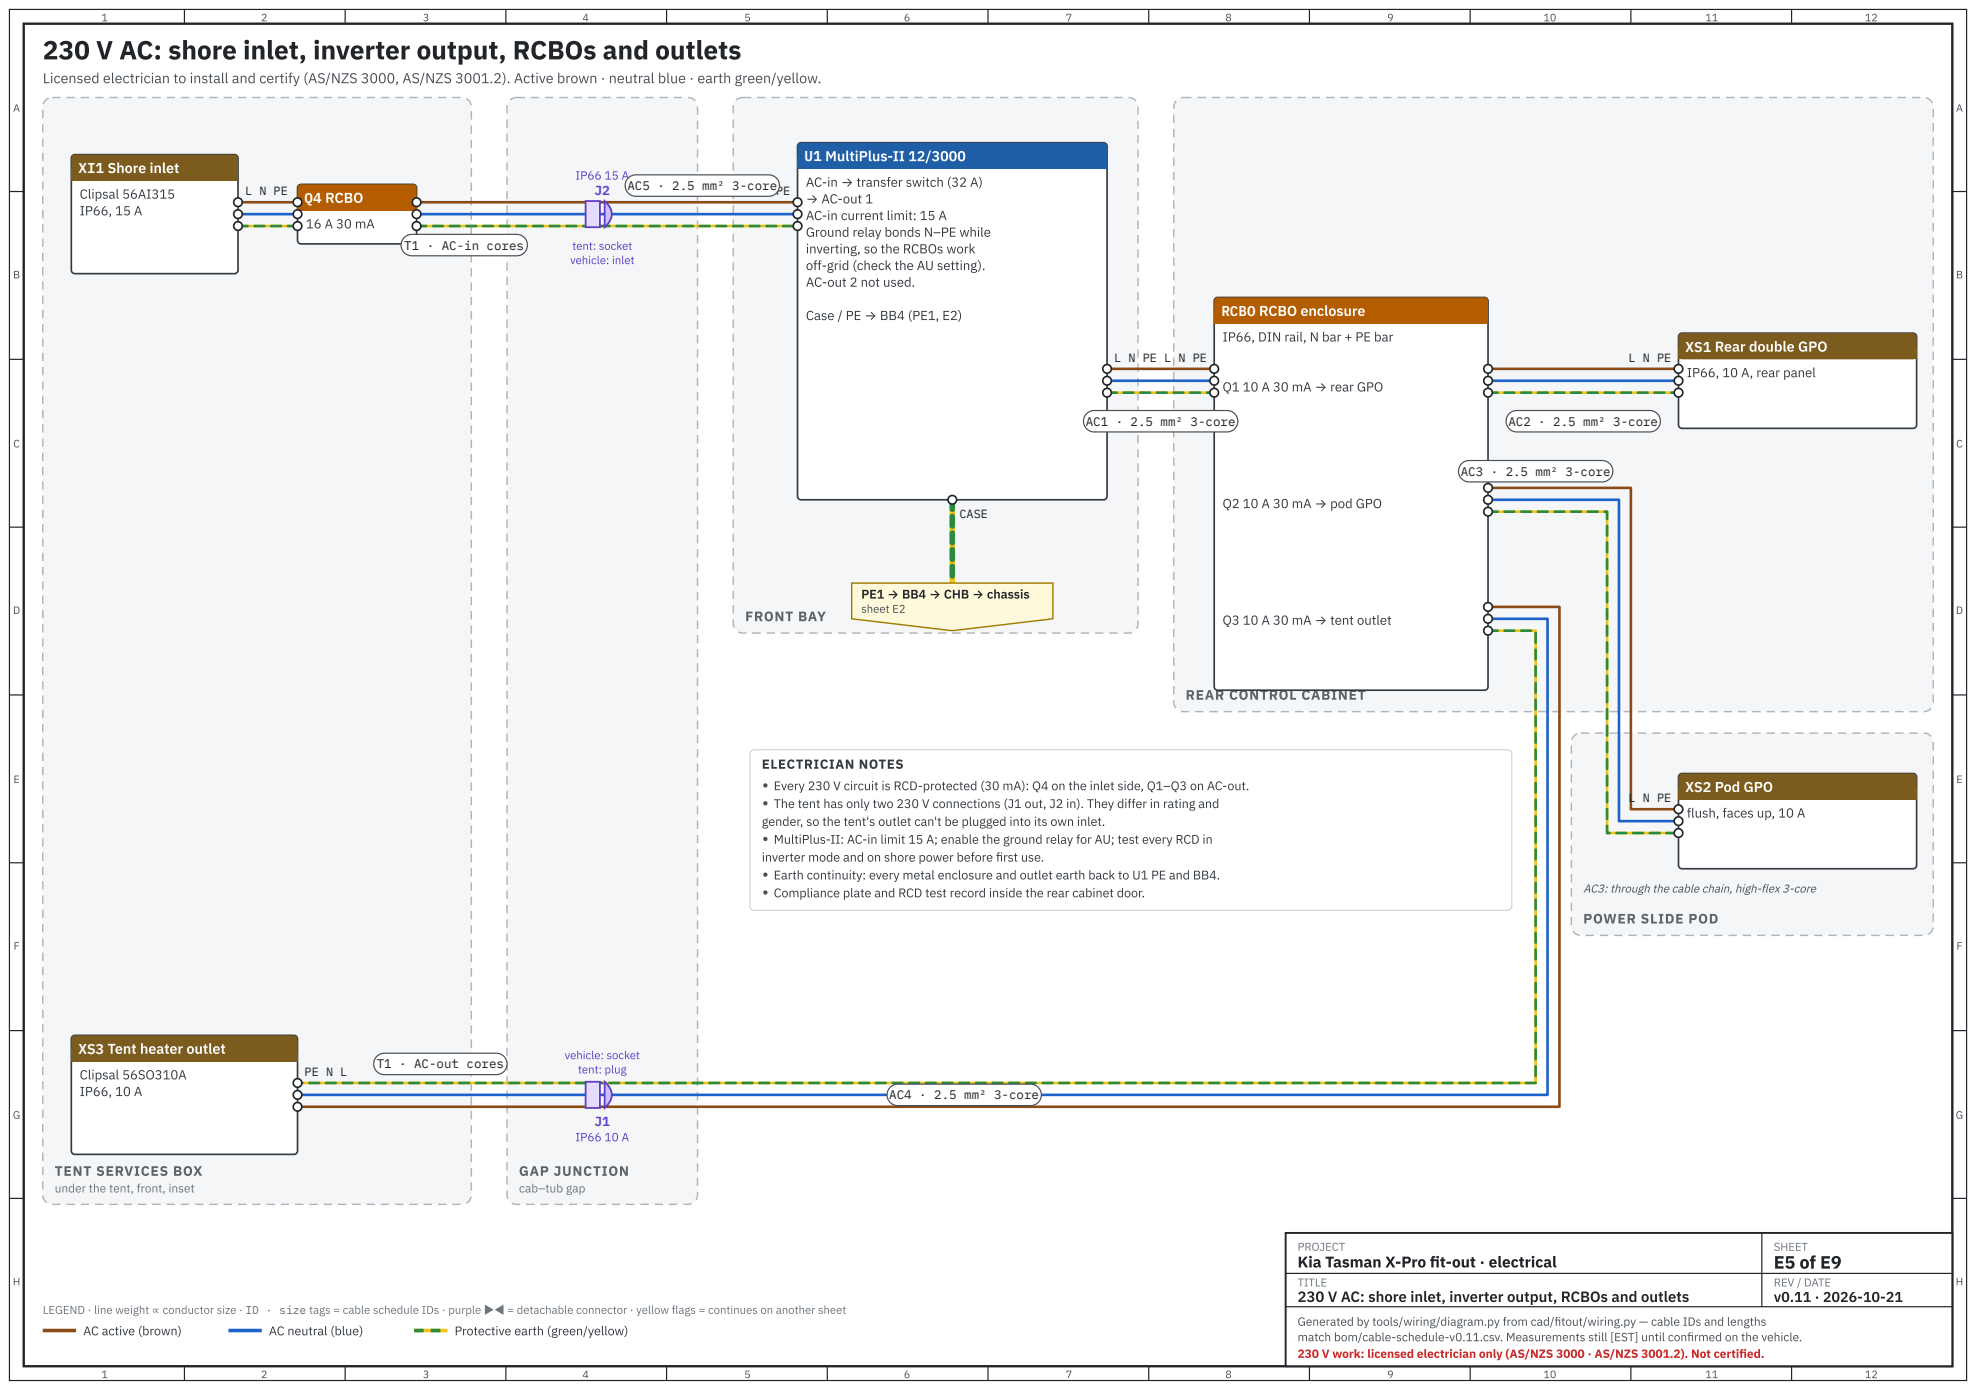
[picture p68: page 5]
SHEET E5 of E9; AC active (brown); AC neutral (blue); Protective earth (green/yellow); GAP JUNCTION; FRONT BAY; XI1 Shore inlet; Clipsal 56AI315; L N PE Q4 RCBO; U1 MultiPlus-II 12/3000; Case / PE → BB4 (PE1, E2); CASE; IP66, 10 A, rear panel; XS2 Pod GPO; Clipsal 56SO310A; AC5 · 2.5 mm² 3-core; AC1 · 2.5 mm² 3-core; AC2 · 2.5 mm² 3-core; AC3 · 2.5 mm² 3-core; AC4 · 2.5 mm² 3-core; PE1 → BB4 → CHB → chassis; sheet E2; tent: socket; vehicle: inlet; vehicle: socket; tent: plug; ELECTRICIAN NOTES

Licensed electrician to install and certify (AS/NZS 3000, AS/NZS 3001.2). Active brown · neutral blue · earth green/yellow.

AC-in → transfer switch (32 A)
→ AC-out 1
AC-in current limit: 15 A
Ground relay bonds N–PE while
inverting, so the RCBOs work
off-grid (check the AU setting).
AC-out 2 not used.

T1 · AC-in cores

RCBO RCBO enclosure

IP66, DIN rail, N bar + PE bar

XS1 Rear double GPO

Q1 10 A 30 mA → rear GPO

Q2 10 A 30 mA → pod GPO

Q3 10 A 30 mA → tent outlet

REAR CONTROL CABINET

Every 230 V circuit is RCD-protected (30 mA): Q4 on the inlet side, Q1–Q3 on AC-out.
The tent has only two 230 V connections (J1 out, J2 in). They differ in rating and
gender, so the tent's outlet can't be plugged into its own inlet.
MultiPlus-II: AC-in limit 15 A; enable the ground relay for AU; test every RCD in
inverter mode and on shore power before first use.
Earth continuity: every metal enclosure and outlet earth back to U1 PE and BB4.
Compliance plate and RCD test record inside the rear cabinet door.

flush, faces up, 10 A

AC3: through the cable chain, high-flex 3-core

POWER SLIDE POD

XS3 Tent heater outlet

T1 · AC-out cores

TENT SERVICES BOX

under the tent, front, inset

cab–tub gap

PROJECT
Kia Tasman X-Pro fit-out · electrical

230 V AC: shore inlet, inverter output, RCBOs and outlets

# Control and communications

Cerbo GX gathers every Victron device for the GX Touch, Home Assistant and VRM. Hard-wired switches at the rear panel.

MONITORING; Cerbo GX in the rear cabinet; U5 Cerbo GX MK2; Victron GX device, Venus OS ≥ 3.20; 3 × VE.Direct, 2 × VE.Bus (RJ45); 3 × USB, HDMI, Ethernet, Wi-Fi, BLE; VE.Can 1/2, relays, tank / temp /; digital inputs: unused; power: FB1 way 9, 2 A (CGX); PWR; HDMI; USB 3; VE.Bus; VE.Direct 1; VE.Direct 2; VE.Direct 3; USB 1; U6 GX Touch 50; 5" touch display, rear panel; VE.Bus U1 MultiPlus-II; VE.Direct P1 SmartShunt 500 A; VE.Direct U3 MPPT 100/50 (roof); VE.Direct U4 MPPT 75/15 (tent); VE.Direct U2 Orion XS 12/12-50A; HA Home Assistant; ST1 Starlink Mini; Wi-Fi router / uplink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
CONTROL CIRCUITS; switches on the rear panel; S1 Battery isolate switch; Blue Sea 2155 Contura; SPDT ON-ON with LED; rear panel; CTRL; LED; GND; QS1 ML-RBS 7713 control harness; red: CONTROL (high = close); yellow: LED OUTPUT; black: GROUND; verify colours vs Blue Sea doc; red; yel; blk; S2 Inverter on/off; SPST rocker, rear panel; U1 MultiPlus-II remote on/off; remove the factory L–H bridge; S3 Visor deploy / stow; momentary rocker + LED, rear panel; DEP STOW LED; U2 Orion XS remote on/off; H ← ignition 12 V (IGN); remove the L–H bridge; RBF ← BB1 via F10 2 A; bank side, always live · E2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

PROJECT
Kia Tasman X-Pro fit-out · electrical

SHEET
E6 of E9

Control and communications

DC + (red) | DC − (black) | Data (VE.Bus / VE.Direct / USB) | Control (12 V switched) | Signal / sense | Wireless (Wi-Fi / BLE)

S1 drives QS1 open/closed; QS1 latches, so S1 position is

the command and the LED confirms the contacts.

S2 open = MultiPlus fully off (inverter and charger).

Modes (on / charger only) are also on the GX Touch.

TENT SERVICES BOX; GAP JUNCTION BOX; vehicle side, IP66, cab–tub gap; VEHICLE; 230 V OUT · IP66 10 A; 12 V · Anderson SB50 red; PV · Anderson SB50 grey; XS3 Heater outlet; XI1 Shore inlet; Q4 RCBO; X5 Anderson SB50; tent 12 V (lights, fans); PVJ Tent PV junction; PV3 + PV4 in series (E4); AC4 ← Q3 RCBO; sheet E5; DO5 ← FB1 way 8 (30 A); sheet E3; PVT → QP2 → U4 MPPT 75/15; sheet E4; T1 · 2 × 2.5 mm² 3-core + 6 mm² twin; T2 · 6 mm²

E | E
F | F
G | G

# Detachable tent harness and gap junction

Four keyed connectors at the cab–tub gap. Unplug J1–J4, cap them, and the tent lifts off with its harness and services box.

PROJECT
Kia Tasman X-Pro fit-out · electrical

SHEET
E7 of E9

Detachable tent harness and gap junction

DC + (red) | DC − (black) | PV + | PV − | AC active (brown) | AC neutral (blue) | Protective earth (green/yellow)

under the tent, front, inset · stays with the tent

DO4 Starlink 4 mm² twin · pass-through gland (not detachable)

PVR roof PV 6 mm² solar twin · pass-through gland (not detachable)

J1 · 230 V OUT TO TENT · IP66 10 A (CLIPSAL 56 SERIES)

Pin | Function | Conductor | Vehicle side | Tent side
A | Active | 2.5 mm² brown | socket (live) | plug
N | Neutral | 2.5 mm² blue
E | Earth | 2.5 mm² green/yellow

J2 · 230 V SHORE IN · IP66 15 A INLET + EXTENSION SOCKET

Pin | Function | Conductor | Vehicle side | Tent side
A | Active (shore) | 2.5 mm² brown | appliance inlet | socket (live)
N | Neutral | 2.5 mm² blue
E | Earth | 2.5 mm² green/yellow

J3 · 12 V · ANDERSON SB50 RED

Pin | Function | Conductor
+ | 12 V + | 6 mm² red
− | 12 V − | 6 mm² black

J4 · PV · ANDERSON SB50 GREY

Pin | Function | Conductor
+ | PV + | 6 mm² solar
− | PV − | 6 mm² solar

DETACH / REFIT

1. Switch the inverter off (S2) and isolate shore power at the source.
2. Unplug J2 (shore in) first, then J1, J3, J4.
3. Fit the caps to all eight halves (IP66 caps / SB50 dust covers).
4. Unclip the harness from the lid-front saddles, then lift the tent.

Refit in reverse. SB50 colours are keyed: red and grey won't mate,

and J1/J2 differ in rating and gender, so nothing can cross-connect.

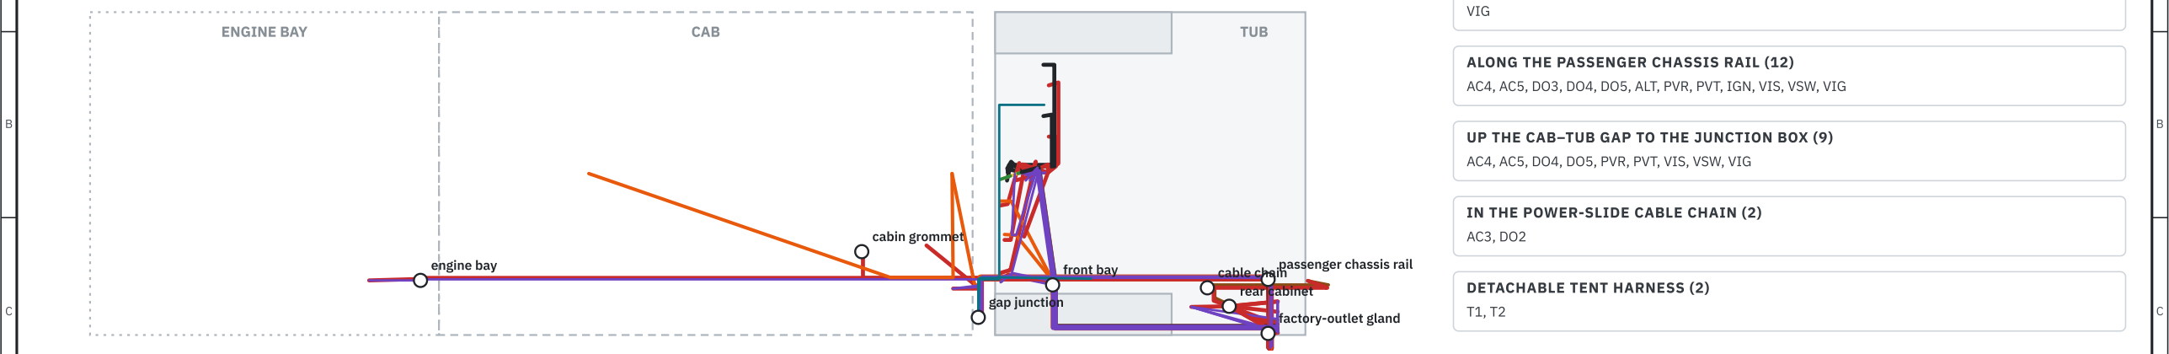
[picture p69: figure]
ENGINE BAY; CAB; TUB; factory-outlet gland; passenger chassis rail; gap junction; cabin grommet; engine bay; front bay; rear cabinet; cable chain; VIG; ALONG THE PASSENGER CHASSIS RAIL (12); IN THE POWER-SLIDE CABLE CHAIN (2); DETACHABLE TENT HARNESS (2)
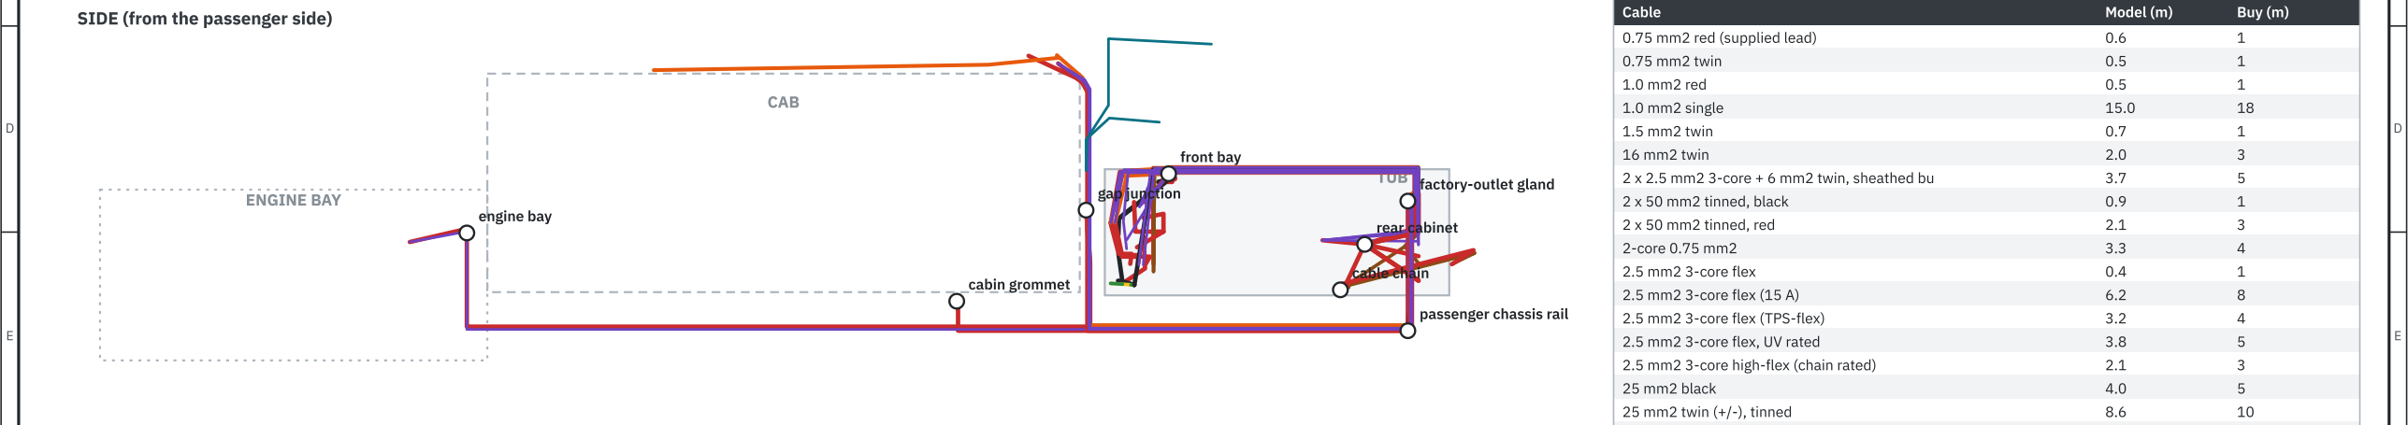
[picture p70: figure]
TUB; CAB; ENGINE BAY; factory-outlet gland; passenger chassis rail; gap junction; cabin grommet; engine bay; front bay; rear cabinet; cable chain; SIDE (from the passenger side); Cable; Model (m); Buy (m); 0.75 mm2 red (supplied lead); 0.75 mm2 twin; 1.0 mm2 red; 1.0 mm2 single; 1.5 mm2 twin; 16 mm2 twin; 2 x 50 mm2 tinned, black; 2 x 50 mm2 tinned, red; 2-core 0.75 mm2; 2.5 mm2 3-core flex; 2.5 mm2 3-core flex (15 A); 2.5 mm2 3-core flex (TPS-flex); 2.5 mm2 3-core flex, UV rated; 25 mm2 black; 25 mm2 twin (+/-), tinned

F | F
G | G

# Cable routes: plan and side view

Generated from the routed 3D model (travel state). Every cable leaves the tub through the factory-outlet gland.

PROJECT
Kia Tasman X-Pro fit-out · electrical

SHEET
E8 of E9

Cable routes: plan and side view

DC + (red) | DC − (black) | PV + | AC active (brown) | Protective earth (green/yellow) | Data (VE.Bus / VE.Direct / USB)

Control (12 V switched)

PLAN (from above, front of the vehicle to the left, driver side up)

Scale ≈ 1 : 26 on A3 · 50 cables · total 125.3 m (model + 10 % + 0.3 m per cable)

THROUGH THE FACTORY-OUTLET GLAND (13)

AC4, AC5, DO3, DO4, DO5, ALT, PVR, PVT, IGN, CHB, VIS, VSW

AC4, AC5, DO3, DO4, DO5, ALT, PVR, PVT, IGN, VIS, VSW, VIG

UP THE CAB–TUB GAP TO THE JUNCTION BOX (9)

AC4, AC5, DO4, DO5, PVR, PVT, VIS, VSW, VIG

CABLE TO BUY (FROM THE ROUTED MODEL)

2 x 2.5 mm2 3-core + 6 mm2 twin, sheathed bu | 3.7 | 5
2.5 mm2 3-core high-flex (chain rated) | 2.1 | 3
25 mm2 twin (red/black) | 3.4 | 4
3-core 0.75 mm2 (deploy, stow, LED) | 4.7 | 6
4 mm2 solar twin, high-flex (chain rated) | 4.5 | 6
4 mm2 twin | 1.2 | 2
4 mm2 twin + DC barrel lead | 5.0 | 6
4-core 1.0 mm2 (+12 V feed, control, LED, gr | 3.0 | 4
50 mm2 green/yellow | 0.4 | 1
6 mm2 solar twin (UV) | 14.3 | 17
6 mm2 twin | 14.9 | 18
6 mm2 twin high-flex | 2.0 | 3
70 mm2 tinned, black | 3.1 | 4
70 mm2 tinned, red | 2.4 | 3
GX Touch cable (HDMI + USB) | 0.8 | 1
RJ45 VE.Bus cable | 3.5 | 5
VE.Direct cables x3 | 4.1 | 5
VE.Direct to USB interface | 3.9 | 5

# Visor drive: slide, tilt and locking

The windscreen visor panel (PV5) slides out on two rails and tilts to 20°. One button at the rear panel; every motion is interlocked.

FEEDS; rear cabinet · E3, E6; ROOF PLATFORM; visor controller, front cross-member; VISOR MECHANISM; rails, carriages, hinge beam; U11 Visor controller; IP66 enclosure, platform front; 12 V logic (PLC / µC) + 2 × dual; H-bridge drivers, current sense; 3 motor channels: M2, M3, M4; latch driver: Y1 + Y2; 4 limit inputs: B1–B4; BZ1 buzzer on the lid; motion only while the button; is held (dead-man), 1 s to start timeout 25 s per step → fault; manual override: 8 mm hex on; M2 shaft end and both tilt drives; GND; DEP; STOW; LED; IGN; COM; M2 Slide gearmotor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
VISOR PANEL; moves with the carriages; PV5 250 W visor; semi-flex on honeycomb; PVV → MC4 3-way → PVR → U3; MPPT 100/50 · sheet E4; PVV · 4 mm²; SEQUENCE; Step; Deploy (hold DEP); Stow (hold STOW); INTERLOCKS AND SAFETY

PROJECT
Kia Tasman X-Pro fit-out · electrical

SHEET
E9 of E9

Visor drive: slide, tilt and locking

DC + (red) | DC − (black) | PV + | PV − | Control (12 V switched) | Signal / sense

IP67 roller-lever switches, NO; B4 is set 1° before the hard stop

high-flex, runs in an igus chain beside the left rail

1 | check IGN off, B1 + B3 closed | allowed any time (IGN on too)
2 | Y1/Y2 energise (pins out) | M3 + M4 tilt down until B3
3 | M2 extends until B2 | Y1/Y2 energise; M2 retracts to B1
4 | M3 + M4 tilt up to 20°, B4 = limit | Y1/Y2 off: springs lock the pins
5 | Y1/Y2 off; worms hold the panel | LED off = locked for travel

No deploy with the ignition on. Engine on while not stowed →

BZ1 sounds, LED flashes; nothing moves without the button.

M2 runs only with B3 closed: the panel slides flat, then tilts. Over-current on any channel → stop and back off 2 mm (pinch).

Mechanical stop at 22° keeps ≥ 87 mm to the glass even if

B4 fails; worm drives cannot be back-driven by wind or load.

Latches fail locked. Stow when gusts exceed ~40 km/h.

U11 draws < 20 mA idle; isolate with FB1 way 10.

# Schedules

# Cable schedule

## Lengths are measured along each cable's routed path in the 3D model, plus 10 % slack and

0.3 m for terminations.

B1P | Bank + | Battery 1 + (MRBF 300 A) | Bank + busbar | 70 mm² tinned, red | MRBF 300 A on terminal | 0.55 | vehicle
B1N | Bank - | Battery 1 - | Bank - busbar | 70 mm² tinned, black | - | 0.93 | vehicle
B2P | Bank + | Battery 2 + (MRBF 300 A) | Bank + busbar | 70 mm² tinned, red | MRBF 300 A on terminal | 0.83 | vehicle
B2N | Bank - | Battery 2 - | Bank - busbar | 70 mm² tinned, black | - | 1.21 | vehicle
RB1 | Main + | Bank + busbar | Remote battery switch IN | 70 mm² tinned, red | MRBF x2 upstream | 0.44 | vehicle
RB2 | Main + | Remote battery switch OUT | System + busbar | 70 mm² tinned, red | - | 0.59 | vehicle
SH1 | Main - | Bank - busbar | SmartShunt (battery side) | 70 mm² tinned, black | - | 0.38 | vehicle
SH2 | Main - | SmartShunt (system side) | System - busbar | 70 mm² tinned, black | - | 0.54 | vehicle
CT1 | Inverter + | System + busbar | Class-T 400 A | 2 x 50 mm² tinned, red | - | 0.94 | vehicle
INVP | Inverter + | Class-T 400 A | MultiPlus-II DC + | 2 x 50 mm² tinned, red | Class-T 400 A | 1.14 | vehicle
INVN | Inverter - | System - busbar | MultiPlus-II DC - | 2 x 50 mm² tinned, black | - | 0.86 | vehicle
ORO | Charging output | orion xs 50a | System +/- busbars (MIDI fuse) | 16 mm² twin | MIDI 70 A | 1.11 | vehicle
MPR | Charging output | mppt roof 100 30 | System +/- busbars (MIDI fuse) | 16 mm² twin | MIDI 60 A | 0.93 | vehicle
MPT | Charging output | mppt tent 75 15 | System +/- busbars (MIDI fuse) | 6 mm² twin | MIDI 20 A | 0.75 | vehicle
DCF | DC distribution | System + busbar (MEGA 100 A) | Rear DC fuse block | 25 mm² twin (red/black) | MEGA 100 A | 3.36 | vehicle
AC1 | AC out | MultiPlus-II AC-out 1 | RCBO enclosure | 2.5 mm² 3-core flex (TPS-flex) | MultiPlus + RCBOs | 3.21 | vehicle
AC2 | Rear GPO | RCBO 1 | Rear panel double GPO | 2.5 mm² 3-core flex | RCBO 10 A 30 mA | 0.4 | vehicle
AC3 | Slide GPO | RCBO 2 | Power-slide pod GPO | 2.5 mm² 3-core high-flex (chain rated) | RCBO 10 A 30 mA | 2.13 | vehicle
AC4 | Tent heater GPO | RCBO 3 | Gap junction -> tent services box GPO | 2.5 mm² 3-core flex, UV rated | RCBO 10 A 30 mA | 3.79 | vehicle
AC5 | Shore inlet | Gap junction (from tent 15 A inlet) | MultiPlus-II AC-in | 2.5 mm² 3-core flex (15 A) | RCBO 16 A 30 mA in the services box + MultiPlus AC-in limit 15 A | 6.15 | vehicle
DO1A | Rear Anderson 1 | DC fuse block | Rear panel Anderson 1 | 6 mm² twin | ATC 30 A | 0.63 | vehicle
DO1B | Rear Anderson 2 | DC fuse block | Rear panel Anderson 2 | 6 mm² twin | ATC 30 A | 0.62 | vehicle
DO1C | Rear USB-C x2 | DC fuse block | Rear panel USB-C x2 | 4 mm² twin | ATC 25 A | 0.57 | vehicle
DO1D | Rear 12 V socket | DC fuse block | Rear panel 12 V socket | 4 mm² twin | ATC 15 A | 0.61 | vehicle
DO2 | Slide DC | DC fuse block | Power-slide pod Anderson / 12 V | 6 mm² twin high-flex | ATC 30 A (+ inline 15 A in the pod) | 2.0 | vehicle
ID | CIRCUIT | FROM | TO | CABLE | PROTECTION | M | HARNESS

DO3 | Cabin compute feed | DC fuse block | Under-rear-seat compute box (SB50
| | | inlet)
6 mm² twin | ATC 15 A (+ BatteryProtect and per-device fuses in the

box)

4.18 | vehicle
DO4 | Starlink Mini | DC fuse block | Starlink Mini (roof) | 4 mm² twin + DC barrel lead | ATC 10 A | 5.0 | vehicle
DO5 | Tent 12 V | DC fuse block | Gap junction -> tent (Anderson SB50) | 6 mm² twin | ATC 30 A | 3.98 | vehicle
ALT | Alternator charge | Start battery (60 A MIDI) | Orion XS input | 25 mm² twin (+/-), tinned | 60 A at start battery | 8.62 | vehicle
PVR | Roof PV | Roof panels + visor (parallel, MC4 3-way branch) | MPPT 100/50 PV in | 6 mm² solar twin (UV) | 2-pole DC PV isolator 32 A | 6.9 | vehicle
PVT | Tent PV | Gap junction (from tent panels) | MPPT 75/15 PV in | 6 mm² solar twin (UV) | 2-pole DC PV isolator 32 A | 5.79 | vehicle
SW1 | Battery switch control | Rear panel ML-RBS switch (Blue Sea 2155) | ML-RBS control harness | 4-core 1.0 mm² (+12 V feed, control, LED, ground) | 2 A inline at bank + (RBF) | 2.98 | vehicle
RBF | Battery switch

control

Bank + busbar | ML-RBS control feed (inline 2 A) | 1.0 mm² red | ATC 2 A inline | 0.47 | vehicle
SHV | Shunt sense | Bank + busbar | SmartShunt Vbatt+ | 0.75 mm² red (supplied lead) | 1 A inline (supplied) | 0.64 | vehicle
FAN | Inverter fan | System + busbar | 92 mm thermostatic fan | 1.5 mm² twin | ATC 5 A inline | 0.67 | vehicle
CGX | Cerbo GX power | DC fuse block | Cerbo GX power in | 0.75 mm² twin | ATC 2 A | 0.5 | vehicle
IGN | Orion ignition sense | Engine-bay fuse box (add-a-fuse, ignition) | Orion XS remote H | 1.0 mm² single | ATC 2 A add-a-fuse | 8.64 | vehicle
PE1 | Inverter case earth | MultiPlus-II chassis earth stud | System - busbar | 50 mm² green/yellow | - | 0.42 | vehicle
CHB | Chassis bond | System - busbar | Chassis rail bond point | 25 mm² black | - | 4.02 | vehicle
SW2 | Inverter remote on/off | Rear panel switch | MultiPlus-II remote terminals | 2-core 0.75 mm² | - | 3.26 | vehicle
D1 | VE.Bus | Cerbo GX | MultiPlus-II | RJ45 VE.Bus cable | - | 3.55 | vehicle
D2 | VE.Direct | Cerbo GX VE.Direct 1-3 | SmartShunt / MPPT 100/50 / MPPT 75/15 | VE.Direct cables x3 | - | 4.08 | vehicle
D4 | VE.Direct | Cerbo GX USB | Orion XS VE.Direct | VE.Direct to USB interface | - | 3.92 | vehicle
D3 | Display | Cerbo GX (HDMI + USB) | GX Touch 50 | GX Touch cable (HDMI + USB) | - | 0.77 | vehicle
PVV | Visor PV | Visor panel (moving) | Roof PV branch (parallel with PV1/PV2) | 4 mm² solar twin, high-flex (chain rated) | - | 4.53 | vehicle
VIS | Visor drive power | DC fuse block (way 10) | Visor controller (roof) | 6 mm² twin | ATC 20 A | 4.77 | vehicle
VSW | Visor control | Rear panel visor button (S3) | Visor controller (roof) | 3-core 0.75 mm² (deploy, stow, LED) | - | 4.67 | vehicle
VIG | Visor interlock | Orion XS remote H (ignition, F9) | Visor controller interlock input | 1.0 mm² single | F9 2 A (shared) | 6.34 | vehicle
T1 | Tent harness | Tent services box | Gap junction plugs (240 V out, 240 V in, 12 V) | 2 x 2.5 mm² 3-core + 6 mm² twin, sheathed bundle | RCBO 16 A 30 mA (AC-in, in the services box) | 3.74 | tent
T2 | Tent PV harness | Tent panels | Gap junction (PV plug) | 6 mm² solar twin (UV) | - | 1.56 | tent
Protection | FB1 fuse block ways
ID | CIRCUIT | FROM | TO | CABLE | PROTECTION | M | HARNESS

F1 | MRBF terminal fuse (Blue Sea

5191)

300 A | Battery 1 + stud | B1P
F2 | MRBF terminal fuse (Blue Sea

5191)

300 A | Battery 2 + stud | B2P
F3 | Class-T fuse + holder (Blue Sea

5502)

400 A | BB3 system + bus | CT1, INVP (MultiPlus DC)
F4 | MIDI fuse | 70 A | BB3 stud | ORO (Orion XS output)
F5 | MIDI fuse | 60 A | BB3 stud | MPR (MPPT 100/50 output)
F6 | MIDI fuse | 20 A | BB3 stud | MPT (MPPT 75/15 output)
F7 | MEGA fuse | 100 A | BB3 stud | DCF (feed to FB1)
F8 | MIDI fuse + holder | 60 A | Start battery +, engine bay | ALT
F9 | Add-a-fuse, ignition circuit | 2 A | Engine-bay fuse box | IGN
F10 | Inline ATC holder | 2 A | BB1 bank + bus | RBF, SW1 (ML-RBS control)
F11 | Inline fuse (supplied with SmartShunt) | 1 A | BB1 bank + bus | SHV
F12 | Inline ATC holder | 5 A | BB3 stud | FAN
FB1 1–10 | ATC blade fuses in FB1 (Blue Sea 5026) | see E3 | Rear control cabinet | DO1A–DO5, CGX, VIS (way 10, 20 A)
F13 | ATC in FB2 | 15 A | Power slide pod | pod 12 V socket
FB3 | ATC fuse block behind a Smart BatteryProtect | per device | Compute box, under the rear seat | HA PC, router, PoE switch, fan
Q1–Q3 | RCBO 1P+N, 30 mA | 10 A | RCBO enclosure, rear cabinet | AC2, AC3, AC4
Q4 | RCBO 1P+N, 30 mA | 16 A | Tent services box | shore inlet → AC-in (T1, AC5)
QS1 | ML-RBS remote battery switch (Blue Sea 7713) | 500 A | Front bay | isolation, bank + → system +
QP1 / QP2 | 2-pole DC PV isolator | 32 A | Front bay, beside the MPPTs | PVR / PVT (servicing)
1 | Rear Anderson 1 | 30 A | DO1A
2 | Rear Anderson 2 | 30 A | DO1B
3 | Rear USB-C ×2 | 25 A | DO1C
4 | Rear 12 V socket | 15 A | DO1D
5 | Power slide pod | 30 A | DO2
6 | Cabin compute feed | 15 A | DO3
7 | Starlink Mini | 10 A | DO4
8 | Tent 12 V | 30 A | DO5
9 | Cerbo GX | 2 A | CGX
10 | Visor drive | 20 A | VIS
11 | spare | – | –
12 | spare | – | –

# Before power-up

Measure the real cable runs: these lengths come from [EST] positions in the model.

Confirm the ML-RBS control-wire colours and switch wiring against the Blue Sea 7713 instructions.

Set every charger to iTechworld's LiFePO₄ voltages; set the Orion XS input limit to 25–30 A.

Torque every stud, then re-check after the first corrugated road.

Electrician: earth continuity, polarity, RCD trip tests on shore power and in inverter mode.

# Component register

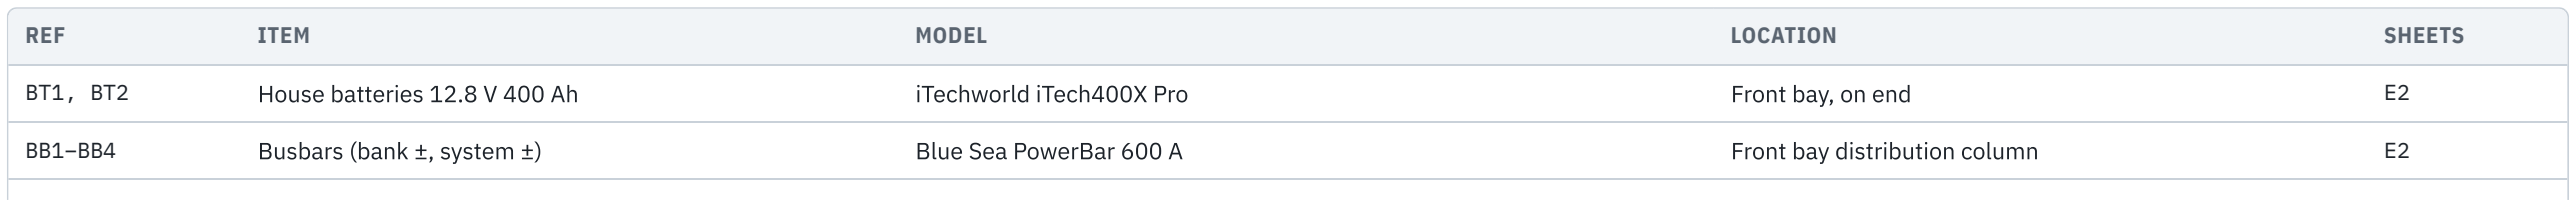
[picture p71: figure]
Busbars (bank ±, system ±); Blue Sea PowerBar 600 A; Front bay distribution column; REF; ITEM; MODEL; LOCATION; SHEETS

BT1, BT2 | House batteries 12.8 V 400 Ah | iTechworld iTech400X Pro | Front bay, on end | E2
REF | DEVICE | RATING | LOCATION | PROTECTS | WAY | CIRCUIT | ATC | CABLE

QS1 | Remote battery switch | Blue Sea ML-RBS 7713 (12 V) | Front bay | E2, E6
P1 | Battery monitor | Victron SmartShunt 500 A | Front bay | E2, E6
U1 | Inverter/charger | Victron MultiPlus-II 12/3000/120-32 230 V | Front bay, lying flat | E2, E5, E6
U2 | DC-DC charger | Victron Orion XS 12/12-50A | Charging board | E4, E6
U3 | Solar charger, roof | Victron SmartSolar MPPT 100/50 | Charging board | E4, E6
U4 | Solar charger, tent | Victron SmartSolar MPPT 75/15 | Charging board | E4, E6
M1 | Inverter fan | 92 mm 12 V thermostatic | Above the inverter | E2
FB1 | Fuse block 12-way + neg bus | Blue Sea 5026 | Rear control cabinet | E3
FB2 | Local fuse holder + studs | 2-way ATC | Power slide pod | E3
U12, FB3 | Compute box: BatteryProtect + 6-way ATC block | Victron SBP-65, Blue Sea 5025-class | Under the rear seat | E3
U5 | GX device | Victron Cerbo GX MK2 | Rear control cabinet | E3, E6
U6 | Display | Victron GX Touch 50 | Rear panel | E6
S1 | Battery isolate switch | Blue Sea 2155 Contura SPDT with LED | Rear panel | E6
S2 | Inverter on/off switch | SPST rocker | Rear panel | E6
S3 | Visor deploy / stow button | momentary ON-OFF-ON rocker with LED | Rear panel | E6, E9
RCBO | RCBO enclosure, Q1–Q3 | IP66 DIN enclosure, 3 × RCBO 10 A 30 mA | Rear control cabinet | E5
XS1 | Rear double GPO | IP66 10 A (Clipsal 56 series) | Rear panel | E5
XS2 | Pod GPO | Flush 10 A, faces up | Power slide pod | E5
XS3 | Tent heater outlet | Clipsal 56SO310A IP66 10 A | Tent services box | E5, E7
XI1, Q4 | Shore inlet + RCBO | Clipsal 56AI315 15 A + RCBO 16 A 30 mA | Tent services box | E5, E7
X1–X5 | Anderson SB50 sockets | Anderson SB50 red + flush housing | Rear panel ×2, pod, compute-box inlet, tent box | E3
X6, X7 | 12 V sockets | Narva / Blue Sea | Rear panel, pod | E3
U7, U8 | Dual USB-C sockets, 100 W PD + 20 W each | Treklo dual USB-C 120 W, 12–24 V | Rear panel ×2 | E3
J1 | 230 V out connector | IP66 10 A socket (vehicle) / plug (tent) | Gap junction box | E5, E7
J2 | 230 V in connector | IP66 15 A inlet (vehicle) / extension socket (tent) | Gap junction box | E5, E7
J3 | 12 V tent connector | Anderson SB50 red | Gap junction box | E3, E7
J4 | Tent PV connector | Anderson SB50 grey | Gap junction box | E4, E7
PV1, PV2 | Roof panels 190 W + 130 W | Victron BlueSolar (parallel) | Roof platform | E4
PV5 | Visor panel ~250 W | semi-flexible on honeycomb backing (parallel with PV1/PV2) | Slide-out visor | E4, E9
U11 | Visor controller | 12 V PLC / µC + 2 × dual H-bridge, IP66 box | Roof platform, front | E3, E9
M2 | Slide gearmotor | 12 V worm gearmotor, self-locking | Roof platform, rear cross-member | E9
M3, M4 | Tilt drives | 12 V worm rotary actuators | Hinge beam ends | E9
REF | ITEM | MODEL | LOCATION | SHEETS

Y1, Y2 | Front latches | 12 V solenoid, spring-locked (fail-locked) | Platform front | E9
B1–B4 | Limit switches | IP67 roller-lever, NO | Rails and hinge beam | E9
BZ1 | Not-stowed buzzer | 12 V piezo | Visor controller lid | E9
PV3, PV4 | Tent panels 2 × 100 W | Sunman eArc flexible (series) | Tent roof | E4
ST1 | Satellite internet | Starlink Mini | Roof platform, inside the frame | E3, E6
BT0, G1, FBX | Vehicle start battery, alternator, fuse box | factory | Engine bay | E4

Generated by tools/wiring/diagram.py from cad/fitout/wiring.py and the routed 3D model. Rebuild: cd cad && ../.venv/bin/python build.py && cd .. && python3 tools/wiring/diagram.py.

REF | ITEM | MODEL | LOCATION | SHEETS
