Kieran-who/kia-tasman-fitout/docs/measurements/measurement-sheet.html

KIA TASMAN X-PRO FIT-OUT · v0.14 · 2026-11-01

# Vehicle measurement sheet

Every dimension the 3D model still guesses: 109 items in nine areas. Fill these in, send back a photo of the pages (or the CSV), and the model gets updated. Then the cutting lists can be trusted. Each item shows what the model assumes now. A big difference from that is exactly what we need to catch. The Stage column shows the first build stage that depends on it (see docs/build-stages.md), and the 📷 box is for ticking off a photo.

### Before you start

- Park on level ground, normal tyre pressures, unladen, and note the fuel level.
- Everything is in mm, measured to the liner surface (what the furniture will touch) unless it says otherwise.
- Driver side = right (D), passenger side = left (P).
- Run masking tape along the tub centreline (half the wall-to-wall width, marked at the front and at the tailgate). That's Y = 0.
- "Front / mid / rear" in the tub means X ≈ 100, 750 and 1400 unless an item says otherwise.
- Photograph each item with the tape in shot and its ID written on masking tape.
- Measure twice. If two readings differ by more than 2 mm, write both.

### Tools

- 5 m tape and a 1 m steel rule
- 300 mm steel rule and digital calipers
- Straight edge ≥ 1.8 m (an aluminium level is ideal) and a spirit level
- Digital angle finder (a phone app works)
- Plumb bob or a laser line, string line
- Masking tape, marker, a radius gauge or a few coins

### Priority

- Stages 1 and 3 (tub, arches, fittings, chassis): needed before cutting anything for the battery bay, cabinets and slides.
- Stage 6 (lid, bars, tent): under-tent storage.
- Stages 2 and 7 (roof, windscreen): platform and visor.

D0 · Reference lines (datums) used on every sheet

Generated from cad/params.py by tools/measure/measure_sheet.py. The diagrams are schematic, drawn from the model's current guesses, so they may not look exactly like your ute. Measure what's really there.

## How to read the photo pages

These are your photos (sent 2026-11-01), marked up. Each mark carries the item ID used in the tables later in this pack.

| Blue dashed line: a reference (X0, Y0, Z0). Every measurement starts from one of these three. Set them up first (photo P1).
| Yellow arrow: measure from one end to the other, exactly between the two points shown.
| Red dot: a point to locate. Give its X (from the front wall), Z (from the rib tops) and, where asked, how far it is from the side wall.
| Red line: an edge to measure to (a face, step or bar).
| Red dashed box: a feature to size: its edges in X and Z, and how far it stands proud of (or recessed into) the wall.

### Three rules that make the numbers usable

1. X always from the front-wall straight edge (X0), along the tub. A laser is easiest: back of the laser on the straight edge, aim at a card held on the point. Y always square off the centreline tape (Y0), or "from the side wall" where an item says so. Z always up from the straight edge lying across the rib tops (Z0).
2. For "how far it stands in from the side wall": hold a straight edge flat on the side wall where it is flat (forward of the thing), and measure square from the straight edge to the thing. Not from the bodywork outside, not from the liner's textured high spots.
3. Take a photo of the tape at each reading with the item ID written on masking tape in the shot. A photo of a reading beats a number.

### Still to photograph

- Driver rear corner, square on (as P2). Your photo of it came through in the chat but not as a file; please re-attach it as a file so it can be marked up. It shows the C-shaped tie-down pocket (C11) and no outlet.
- Each tail-light housing from the tailgate, looking forward along the side wall, with a straight edge on the wall: shows C1/C2 "in".
- The outside shots you sent (rails, bars, tent latches, tail lights) are noted on the lid and tent items; re-send as files to mark up.

## Photo P1 · Whole tub from the tailgate

Standing at the open tailgate, looking forward. Driver side (D) is on the RIGHT, passenger (P) on the left.

X0 | Reference X = 0: the front wall Hold a straight edge (level) flat across the RAISED panels of the front wall, about 100 mm above the floor. Every X is measured from that edge, not from the bottom of the vertical grooves.
Z0 | Reference Z = 0: the floor Lay the straight edge across the floor ribs. Every height is measured from the TOPS of the ribs (the ridges), never the valleys.
Y0 | Reference Y = 0: the centreline Mark halfway between the two round floor plugs at the tailgate end, and halfway wall-to-wall at the front wall. Run masking tape between the two marks; Y is measured square off this line.
T1 | Floor length FROM inside face of the CLOSED tailgate TO the X0 straight edge On the centreline, at rib-top height. Laser: back of the laser flat on the closed tailgate, aim at a card held on the straight edge. Your photo reads 1.508 m: note where the back of the laser was.
W4 | Width between the arches FROM inner face of the P arch TO inner face of the D arch Just above the floor, square across, at X ≈ 100, 430 and 760 (three readings).

C13 | Notch in each arch top (near the front wall) FROM X0 / Z0 TO centre of the notch X and Z of the notch centre, its width and how deep it goes.
L16 | Lid front-corner bracket See photo P4 (driver front corner).
T17 | Round floor plugs FROM X0 and Y0 TO centre of each plug X, Y of each centre and the diameter.
L8 | Lid gas struts See photos P4 and P5.
L5 | Lid front member FROM top of the tub rail TO underside of the lid Gap at each corner with the lid closed (L5).

## Photo P2 · Passenger rear corner (square on)

Standing at the centreline, facing the passenger wall. The tailgate is to the LEFT, the cab to the right.

C2 | Tail-light housing (P) FROM X0 (front wall) TO the housing's front face, where it leaves the side wall (red line) At the floor, 270 high and just under the rail. Then how far it comes in: straight edge flat on the side wall FORWARD of the housing, measure square to it to the housing face, same three heights. Then Z of its bottom and top.
L15 | Lid rear stay FROM Z0 / X0 TO centre of each of the 2 bolts X and Z of both bolts; how far the bar stands off the wall at the bolts and at the top; bar width.
F1 | Factory 240 V outlet bezel FROM X0 / Z0 TO bezel edges X of the bezel's front and rear edges, Z of its top and bottom.
C8 | Outlet recess FROM X0 / Z0 TO edges of the recessed panel X front and rear, Z bottom and top, and how deep it is behind the wall face.
C7 | Vertical rib FROM X0 / Z0 TO rib centre X of the centre, width, how far it stands proud, Z where it stops.
C12 | Wall step (ledge line) FROM Z0 TO the step line Height of the step; then straight edge on the upper wall, measure in to the lower wall (step depth).
L9 | Star-knob clamps FROM X0, side wall, Z0 TO each knob X of each; how far its tip is from the side wall; Z of its lowest point.
L6 | Lid side skirt (UTE MASTER plate) and the rail below it FROM Z0 and the side wall TO lowest edge of each Z of the lowest edge of the skirt and of the aluminium rail; how far each stands in from the side wall.
L7 | Shackle / catch at the lid corner FROM lid underside TO lowest point How far it hangs below the lid, X of its centre.
Z0 | Floor reference Heights from the rib tops (P1).

## Photo P3 · Passenger rear corner, looking up at the lid hardware

Close to the passenger wall, looking up and back. Tailgate to the LEFT.

L7 | Shackle / catch FROM lid underside TO lowest point Hang depth and X.
L9 | Star knobs FROM side wall TO knob tip As P2.
L15 | Rear stay FROM lid corner (top) / bolts (bottom) TO – Top: X where it leaves the lid. Bottom: the 2 bolts (P2).
L6 | Aluminium lid rail along the wall top FROM side wall TO inner face of the rail How far in, and Z of its bottom edge.
C2 | Tail-light housing face As P2.
C12 | Wall step As P2.
C7 | Vertical rib As P2.

## Photo P4 · Driver front corner

Inside the tub near the driver arch, looking forward and right. Front wall on the LEFT, driver side wall on the right.

L16 | Lid front-corner bracket (angle with a plastic hook) FROM X0 / the side wall / Z0 TO bracket edges and the hook's bottom How far it stands off the front wall, how far its outer edge is from the side wall, its width, and Z of the BOTTOM of the hook.
C12 | Wall step over the arch FROM Z0 TO step line Height at the front and at the back of the arch.
C13 | Arch notch FROM X0 / Z0 TO notch centre As P1.
W3 | Arch top FROM Z0 TO top of the arch Height at the front, middle and rear of its top (W3); note where the top steps.
X0 | Front wall raised panel The X = 0 face (P1).
L8 | Gas strut, lower end FROM X0 / Z0 / side wall TO the strut's lower pivot X, Z and distance from the side wall of BOTH strut ends (lid closed); strut diameter.
L6 | Lid rail along the wall top FROM side wall TO inner face As P2.

## Photo P5 · Passenger front corner

Inside the tub near the passenger arch, looking forward and left. Front wall on the RIGHT.

L16 | Lid front-corner bracket As P4.
C12 | Wall step As P2, passenger side.
C13 | Arch notch As P1.
L8 | Gas strut As P4, passenger side.
L6 | Lid rail As P2.

## 1 · Tub: floor, walls and tailgate

D1 · Tub, plan view (from above)

D3 · Cross-section looking forward from the tailgate (driver side on the right)

Diagrams: D1, D3

ID | Measure | Model now | Your values (mm unless noted) | Stage | 📷
T1 | Floor length on the centreline 📷 P1FROM the inside face of the closed tailgate TO the X0 straight edge on the front wall, along the centreline tape at rib-top height (laser: back of the laser on the tailgate). Your laser photo read 1.508 m: say where the laser's back was | 1512TUB_L | mm | 1 3
T2 | Floor length beside the archesRear end of each arch → tailgate inside face, 50 mm in from the side wall | 652TL − ARCH_L | Driver Passenger | 3
T3 | Width wall to wall behind the archesFROM the passenger wall TO the driver wall, square across at X ≈ 1000 (between the arch and the rib), on the flat of the liner: at the floor, 270 high, and just under the lid rail | 1572TUB_W | Floor 270 high Rail | 1 3
T4 | Width at the tailgateFROM housing face TO housing face (between the two tail-light housings, C1/C2) at X ≈ 1460; and wall to wall just forward of the housings | 1572TUB_W | Housings Walls fwd | 3
T5 | Width above the arches at the frontWall to wall at X ≈ 50, just above arch height and at rail height | 1572TUB_W | Above arch Rail | 1
T6 | Tub depthRib top → top of the tub rail (inside edge), at each corner | 540TUB_D | Front D Front P Rear D Rear P | 1 3
T7 | Front wall leanLevel held vertical against the front wall: gap at rail height (+ = wall leans back) | 0 | mm | 1
T8 | Side wall leanSame on each side wall behind the arch (+ = tub wider at the top) | 0 | Driver Passenger | 3
T9 | Corner radiiFloor-to-wall radius, and the radius in the front corners (vertical) | – | Floor/wall Front corners | 1 3
T10 | Floor ribs (detail a)Rib height above the valleys, rib top width, pitch, how many, Y of the middle rib, X where they start and end | 14 / 45 / 100RIB_H, RIB_W, RIB_PITCH | Height Top width Pitch Count Mid rib Y Start X End X | 1 3
T11 | Liner thickness (detail f)Calipers on an exposed liner edge (rail lip or tailgate gap) | 8LINER_ALLOW | mm | 3
T12 | Liner typeDrop-in or spray-in? How is it fixed? Can it come out to bolt through the floor? | drop-in | | 1
T13 | Tub rail cap (detail f)Width of the rail's flat top, how far its inside lip overhangs the wall, lip depth | – | Cap width Lip overhang Lip depth | 3
T14 | Tailgate inner panelThickness inside face → outer skin at mid-height; note any handles or bulges facing the tub | 60TAILGATE_T | Thickness Bulges? | 3
T15 | Tailgate openingClear width between the latch pillars at the floor and at the top; height of the closed tailgate top above the floor | – / 525TAILGATE_H | Width floor Width top Height | 3
T16 | Tailgate openTailgate down: its top surface vs the tub floor (+ above / − below), its length from the hinge, the cable stay rating | – | Height diff Length Rating kg | 3
T17 | Holes in the floor 📷 P1X, Y of any drain holes or existing bolt holes (lift the liner if it's drop-in) | – | | 1

## 2 · Wheel arches

D2 · Tub, side section (looking at the passenger wall from the centre)

Diagrams: D1, D2, D3

ID | Measure | Model now | Your values (mm unless noted) | Stage | 📷
W1 | Arch startGap from the front wall to the front of each arch at the floor and at the top (0 if they meet) | 0 | D floor D top P floor P top | 1
W2 | Arch lengthFront → rear end of each arch along its inner face, at the floor and at the top | 860ARCH_L | D floor D top P floor P top | 1 3
W3 | Arch height 📷 P4Rib top → top of each arch at the front, middle and rear of its flat top | 290ARCH_H | D front D mid D rear P front P mid P rear | 1 3
W4 | Width between the arches (floor) 📷 P1FROM the inner face of the passenger arch TO the inner face of the driver arch, square across just above the floor, at X ≈ 100, 430 and 760 (photo P1) | 1170ARCH_GAP | Front Mid Rear | 1 3
W5 | Width between the arches (top)Same three positions, just below the top radius | 1170ARCH_GAP | Front Mid Rear | 1 3
W6 | Arch intrusionSide wall face → arch inner face at mid-length | 201ARCH_IN | Driver Passenger | 3
W7 | Arch top shapeFlat width of the top (wall → start of the radius) and the radius on its inboard edge | – / 70ARCH_R | D flat D radius P flat P radius | 3
W8 | Arch rear endVertical, sloped or curved? How far the top's rear edge sits forward of the floor's rear edge | vertical | Driver Passenger | 3
W9 | Arch well (detail e)The recess in each arch face: X of its front and rear edges, Z of its bottom and top, depth | 620–780 / 195–245 / 35ARCH_POCKET | D x0 D x1 D z0 D z1 D depth P x0 P x1 P z0 P z1 P depth | 3
W10 | Space above the archArch top → underside of the closed Load-Lid (lowest part of its frame), front and rear of each arch | 258UNDER_LID_Z − ARCH_H | D front D rear P front P rear | 3

## 3 · Factory fittings in the tub

D7 · Details (not to scale)

Diagrams: D1, D2, D7

ID | Measure | Model now | Your values (mm unless noted) | Stage | 📷
F1 | Factory 240 V outlet (detail d) 📷 P2Centre X from the front wall, centre Z above the floor, housing width × height, how far it stands proud | 1330 / 400FACTORY_OUTLET | X Z W H Proud | 1
F2 | Behind the outletWith the outlet removed: hole size in the steel, cavity depth behind (model: 49 mm between liner and skin), and the way out at the cavity bottom for a 50 mm and a 25 mm conduit (routes R14 / R15, sheet E12) | – / 49 | Hole W Hole H Cavity Exit | 1
F3 | Tie-down pointsEvery tie-down or rail: wall, X, Z, type and how far it stands proud | none on the arches | | 1 3
F4 | Other protrusionsBolt heads, cleats, liner bosses, light: position and how far they stand proud | – | | 3

## 3b · Rear corners: tail-light housings (added 2026-10-25; photo pages P1-P5)

D8 · Rear corner from above (passenger side shown; driver is the mirror image)

Diagrams: D8, D1, D2

ID | Measure | Model now | Your values (mm unless noted) | Stage | 📷
C1 | Tail-light housing, driverFROM X0 TO the housing's front face where it leaves the side wall (red line on P2, mirrored), and TO where it meets the tailgate seal. How far it comes in: straight edge flat on the side wall forward of it, measure square to the housing face, at the floor, 270 high and under the rail. Z of its bottom and top | 1332 / in 80 (photo est)TAIL_BULGE_L, TAIL_BULGE_IN | X start X end In floor In 270 In rail Z bottom Z top | 1 3
C2 | Tail-light housing, passenger 📷 P2, P3Same as C1 on the passenger (outlet) side: photo P2 | 1332 / in 80 (photo est)TAIL_BULGE_L, TAIL_BULGE_IN | X start X end In floor In 270 In rail Z bottom Z top | 1 3
C3 | Housing shapeFlat or curved face? Square, sloped or rounded front edge (sketch it)? Any lip where it meets the wall? Same both sides? | – | | 3
C4 | Access plugsEach push-rivet plug or cap on the housings: X, Z, diameter, what's behind it (lamp bolts, globe, wiring) and how much hand room it needs. Anything built here must leave these reachable | – | D X D Z D dia P X P Z P dia Hand room | 3
C5 | Clear length behind the archRear end of the arch → front face of the tail-light housing, 50 mm in from the side wall, at the floor, 270 high and just below the rail | 652TL − ARCH_L | D floor D 270 D rail P floor P 270 P rail | 3
C6 | Clear width beside the housingInner face of the housing → centreline of the tub at 270 high (shows how much is left outboard of the slides) | 786TUB_W / 2 | Driver Passenger | 3
C7 | Rib behind the arch 📷 P2, P3The vertical pressed rib between the arch and the outlet recess: X of its centre, width, how far it stands proud, full height or not | – | D X D width D proud P X P width P proud | 3
C8 | Outlet recess 📷 P2The recessed panel the factory outlet sits in: X of its front and rear edges, Z of its bottom and top, depth behind the wall face (photo P2: it looks lower and further forward than the model) | photo est X 1190, Z 210FACTORY_OUTLET | X front X rear Z bottom Z top Depth | 1
C9 | Arch top profilePhotos show a stepped arch top: X of each step and the height before and after it, each side; how far the rear end slopes | flat at 290ARCH_H | | 1 3
C10 | Clear height under the lid hardwareFROM the rib tops (Z0) UP TO the lowest lid part above (skirt, rail, knob or strut), 100 mm in from each side wall, at X ≈ 100, 450, 900, 1250 and 1450. This is the real ceiling for the cabinets and drawers | 548UNDER_LID_Z

| X100 | X450 | X900 | X1250 | X1450
Driver
Passenger
1 3
C11 | Tie-down pocket in each side wallThe C-shaped moulded pocket behind the arch (driver photo): X of its front and rear edges, Z of its bottom and top, depth. Is there a factory hook or loop in it? | – | D X0 D X1 D Z0 D Z1 D depth P same? | 3
C12 | Wall step (ledge line) 📷 P2, P3, P4, P5The horizontal step along each side wall (photos P2, P4, P5): Z of the step at the front, over the arch and at the rear; how deep the step is (straight edge on the upper wall, measure in to the lower wall) | – | D Z front D Z rear D depth P Z front P Z rear P depth | 1 3
C13 | Notch in each arch top 📷 P1, P4, P5The triangular notch near the front wall (photos P1, P4, P5): X and Z of its centre, width, depth | – | D X D Z D w D depth P X P Z | 3

## 4 · Load-Lid and Destroyer rails

D4 · Load-Lid, bars and tent, plan view (from above)

Diagrams: D2, D3, D4

ID | Measure | Model now | Your values (mm unless noted) | Stage | 📷
L1 | Lid sizeOverall length (along) and width (across) including edge trims | 1600 × 1720LID_L, LID_W | Length Width | 6
L2 | Lid front edgeLid front edge relative to the tub front wall face (− = ahead of the wall) | -25LID_X0 | mm | 6
L3 | Lid rear edgeLid rear edge relative to the closed tailgate's outer face (+ = overhangs) | – | mm | 6
L4 | Lid thicknessTop skin → lowest part of its perimeter frame | 45LID_T | mm | 3 6
L5 | Gap rail → lid 📷 P1Tub rail top → lid underside at the four corners | 8LID_CLEAR | FD FP RD RP | 3
L6 | Lid side skirt and lid rail (each side) 📷 P2, P3, P4, P5The UTE MASTER plate hanging below the lid, and the aluminium rail with holes under it (photos P2, P3): Z of the LOWEST edge of each (from the rib tops), and how far each stands in from the side wall. Full length, or where do they start and stop (X)? | skirt 490 / rail 488 (photo est)LID_SKIRT, LID_BASE_RAIL | Skirt Z Skirt in Rail Z Rail in X start X end | 1 3
L7 | Hinges and lock 📷 P2, P3Hinge type and positions; lock/latch positions and how far they reach into the tub | – | | 3
L8 | Gas struts (inside the tub, front) 📷 P1, P4, P5Lid closed. For BOTH ends of each strut: X (from X0), Z (from Z0) and distance from the side wall to the strut's centre; strut diameter (photos P1, P4, P5) | x 150–480, z 495–540 (photo est)LID_STRUT

| Low X | Low Z | Low in | High X | High Z | High in | Dia
Driver
Passenger
1 3
L9 | Star-knob clamps 📷 P2, P3Each star knob on the lid skirt (photos P2, P3): X, how far its tip is from the side wall, Z of its lowest point. How many per side? | 1160 / 1290 (photo est)LID_KNOBS_X

| D X | D in | D Z | P X | P in | P Z
Knob 1
Knob 2
Knob 3
3
L10 | Destroyer rails (detail b)Height above the lid top, width, length, X of the front and rear ends, Y of the rail centre from the centreline | 55 / 45 / – / 830LID_RAIL_H, LID_RAIL_W, LID_RAIL_Y | Height Width Length Front X Rear X Y | 6
L11 | Rail T-slot (detail b)Slot opening, slot depth, inner width, lip thickness; T-bolt size used | – | Opening Depth Inner w Lip Bolt | 6
L15 | Lid rear stays 📷 P2, P3The steel bar from each rear lid corner down to 2 bolts at the tail-light housing (photos P2, P3): X and Z of each bolt; X where the bar leaves the lid; how far the bar stands off the wall (top and bottom); bar width | bolts ~1322, Z 255 (photo est)LID_REAR_STAY

| Bolt1 X | Bolt1 Z | Bolt2 Z | Top X | Off top | Off bot | Width
Driver
Passenger
1 3
L16 | Lid front-corner brackets 📷 P1, P4, P5The angle bracket in each front corner with a plastic hook at its foot (photos P1, P4, P5): how far it stands off the front wall, how far its outer edge is from the side wall, its width, Z of the bottom of the hook | hook Z 285 (photo est)LID_FRONT_BRACKET

| Off front | From side | Width | Hook Z
Driver
Passenger
1
L12 | Lid top surfaceChequer pattern height; flat or crowned (straight edge across: gap at the centre) | flat | Pattern Crown | 6
L13 | Lid underside over the batteries (v0.14)Tub floor → lid underside at the driver front corner (X ≈ 100 and 250, Y ≈ 200 and 500): the battery top foam assumes 9 mm above the handle lugs | 548UNDER_LID_Z | X100 Y200 X100 Y500 X250 Y200 X250 Y500 | 1
L14 | Space for the water-can jacket (v0.14)Lid top → tent base underside over the water can, and lid top → the tent's under-rail; is a 30 mm jacket top possible? | 163.4TENT_Z0 − LID_TOP_Z | To base To rail | 6

## 5 · Rack bars and tent

Diagrams: D2, D3, D4, D7

ID | Measure | Model now | Your values (mm unless noted) | Stage | 📷
R1 | Bar positionsCentre line of each Vortex bar from the lid front edge (or from the tub front wall, say which) | 180 / 1080 (from tub wall)RACK_BAR_X | Front bar Rear bar Datum | 6
R2 | Bar length and overhangOverall length; overhang past each leg | 1500RACK_BAR_L | Length D overhang P overhang | 6
R3 | Bar sectionWidth × height of the bar; top slot width | 79 × 30RACK_BAR | W H Slot | 6
R4 | Bar heightLid top → underside of each bar beside each leg | 133.4TENT_GAP − bar | Front D Front P Rear D Rear P | 6
R5 | Legs / bracketsFootprint on the rail (along × across), leg height, part number | – | Footprint Height Part no. | 6
R6 | Tent under-railsY of each under-rail centre from the centreline; X of the rail ends | ±400TENT_UNDER_RAILS_CC | D Y P Y Front X Rear X | 6
R7 | Tent bolt tails (detail c)At each of the 4 crossings: bar underside → lowest point of bolt, nut or plate; plate size; bolt size | 60TENT_BOLT_DROP | Front D Front P Rear D Rear P Plate Bolt | 6
R8 | Gap lid → tentLid top → lowest part of the tent base at the front, middle and rear, both sides | 163.4TENT_GAP | Front D Front P Mid D Mid P Rear D Rear P | 6
R9 | Tent positionTent front and rear edges from the lid front edge; overhang past the lid edge each side | -10TENT_X0 | Front Rear D overhang P overhang | 6
R10 | Tent shapeClosed height (base → top of the roof bars), length of the front slope, top-bar spacing and length | 330 / 380 / 1040 / 890TENT_H, TENT_SLOPE_L, TENT_BAR_CC, TENT_BAR_L | Height Slope Bar c/c Bar length | 5
R11 | Ladder bracketWhere it is and how far it sticks out or down | – | | 6
R12 | Tent openHow far the open tent reaches past the driver side; floor height when open | – | Reach Floor height | -
R13 | Tent to cabTent front face → cab rear at tent-base height | – | mm | 4

## 6 · Body, cab gap and chassis

D5 · Vehicle side view (passenger side): heights from the ground, positions from the tub front wall

Diagrams: D5, D3

ID | Measure | Model now | Your values (mm unless noted) | Stage | 📷
B1 | Cab–tub gapCab back wall → tub front wall at the top, middle and bottom | 55CAB_REAR_X | Top Mid Bottom | 1 4
B2 | In the gapBody mounts, hoses, lines, wiring. Free space near the passenger top corner for a ~150 × 150 × 90 junction box? | – | Free W Free H Free D | 4
B3 | Tub heightGround → top of the tub rail at the tailgate and at the front corner (the floor is this minus T6) | 1460FLOOR_ABOVE_GROUND | Rear Front | 1
B4 | Rear wheel centrePlumb from the tub front edge and from the wheel centre; distance along the ground | 430REAR_AXLE_X | Driver Passenger | 1
B5 | Wheelbase checkFront → rear wheel centres | 3270WHEELBASE | Driver Passenger | -
B6 | Chassis railsCentre Y of each rail; top of the rail below the tub floor; rail width × height | ±470 / -150CHASSIS_RAIL_Y, CHASSIS_Z | D Y P Y Top Z W H | 1
B7 | Cable routeOutlet → passenger chassis rail → cab gap: obstacles, existing clips and holes | – | | 1
B8 | Tub undersideCross-member positions (X) under the tub floor, in case anything bolts through | – | | 1

## 7 · Roof, windscreen and platform

D6 · Roof crown: straight edge across the roof (repeat at the front, middle and rear)

Diagrams: D5, D6

ID | Measure | Model now | Your values (mm unless noted) | Stage | 📷
G1 | Header to tubHorizontal: top of the windscreen (header seal) → tub front wall (plumb line from the header) | 1790CAB_FRONT_X | mm | 2 7
G2 | Roof lengthHeader → rear edge of the roof skin | 1680 | mm | 2
G3 | Roof heightGround → roof skin on the centreline, 200 mm behind the header, middle, 100 mm from the rear | 1880ROOF_Z | Front Mid Rear | 2 7
G4 | Roof crown (D6)Straight edge across the roof: gap to the skin at each mark. Rows: front / mid / rear | flat

| P 700 | P 560 | P 350 | 0 | D 350 | D 560 | D 700
Front
Mid
Rear
2 7
G5 | Roof widthSkin width between the drip channels at the front, middle, rear | – | Front Mid Rear | 2
G6 | Roof mounting pointsHow many; X (from the header) and Y of each; thread; cover type | – | | 2
G7 | Roof railsHeight, foot positions; do they come off for the Wedgetail kit? | – | | 2
G8 | Roof itemsShark-fin antenna position and height; anything else on the roof | – | | 2 7
G9 | Windscreen angleAngle finder flat on the glass at the centre, from horizontal | – | degrees | 7
G10 | Windscreen sizeLength along the glass (header → bottom edge, centre) and width at the top | – | Length Width | 7
G11 | Bonnet rear edgeHeight above ground and horizontal distance from the header at the centre; top of the parked wipers | – | Height From header Wipers | 7
G12 | Platform (once fitted)Platform underside above the roof skin at the front and rear; front edge vs the header | 70PLAT_Z | Front Rear Front edge | 2 7
G13 | Overall heightGround → top of the closed tent; ground → top of the platform | 2006 | Tent Platform | -
G14 | Headlining and roof cablesHow far the headlining drops to reach the roof points; path for a cable roof → cab (which pillar?) | – | | 2

## 8 · Engine bay and cabin

ID | Measure | Model now | Your values (mm unless noted) | Stage | 📷
E1 | Start batteryType and size; terminal type; room for a MIDI fuse holder within 300 mm of the + terminal | – | | 1
E2 | Fuse boxLocation; fuse type (mini / micro2) for the add-a-fuse; an ignition-switched circuit to tap | – | | 1
E3 | AlternatorRated current on its label (amps) | unknown | Amps | 1
E4 | Engine bay → chassisPath for the 25 mm² twin from the start battery to the passenger chassis rail (R21); exhaust distance along the rail (R17–R19) | – | | 1
E5 | Under the rear seatSpace for the cabin outlet box: length × width × height, what's there now | 45 LCABIN_SEAT_BOX | L W H | 5
E6 | Cab floor grommetsExisting grommets that could take the cabin feed from the chassis rail (R20) | – | | 5
E8 | Cab back (C-pillar corner)Flat face up the passenger corner of the cab back for the 32 mm conduit (R25), and the gap between the cab top and the platform rear member | – | Width Gap | 2
E9 | Chassis rail webHeight of the passenger rail web and the free length for the two conduits from the tub to the cab-tub gap (R16 / R17) | 180 / – | Web H Free L | 1
E7 | Dash switch blanksFree switch blanks on the dash (optional visor stow switch) | – | | 7

## 9 · Equipment and vehicle details

ID | Measure | Model now | Your values (mm unless noted) | Stage | 📷
Q1 | FridgeConfirmed Dometic CFX3 45 (694 × 398 × 476): check the handle height and that the handles fold up for the straps | CFX3 45 | Model L W H Lid | 3
Q2 | Accessories fittedTow bar (ball weight), bull bar, side steps, snorkel, anything else | – | | -
Q3 | Compliance plateGVM, GCM, rear axle rating | GVM 3250 | GVM GCM Rear axle | -
Q4 | Weighbridge (optional)Front and rear axle weights, unladen, full fuel | – | Front Rear | -
Q5 | TyresSize and pressures | 265/70R17 | Size Pressures | -

## Photo checklist

- Whole tub from the tailgate, from each rear corner and from above (lid open)
- Each arch: side on, with a tape along it; close-up of each arch well with a rule in it
- Front wall and both front corners; the floor ribs with a rule across them
- Factory outlet: on, and removed showing the hole and what's behind
- Every tie-down and protrusion with a rule beside it
- Under the lid: hinges, lock, struts, clamps, any frame members
- Each rear corner (both sides): square-on to the side wall from the tub centre, from the tailgate looking forward, and from above with the lid open, with a tape along the floor and up the tail-light housing
- Destroyer rail end-on (T-slot profile) with calipers
- Each of the 4 tent-bolt crossings from the side, with a rule from the bar to the lowest point
- Cab–tub gap from above and below; chassis rail beside the gap
- Roof: straight edge across with the gaps visible; the roof mounting points uncovered
- Side profile of the windscreen and bonnet with a level for reference
- Engine bay: start battery, fuse box, route to the chassis; under the rear seat

## Notes and sketches
