Kieran-who/kia-tasman-fitout/docs/measurements/photos/p1-tub-from-tailgate.jpg

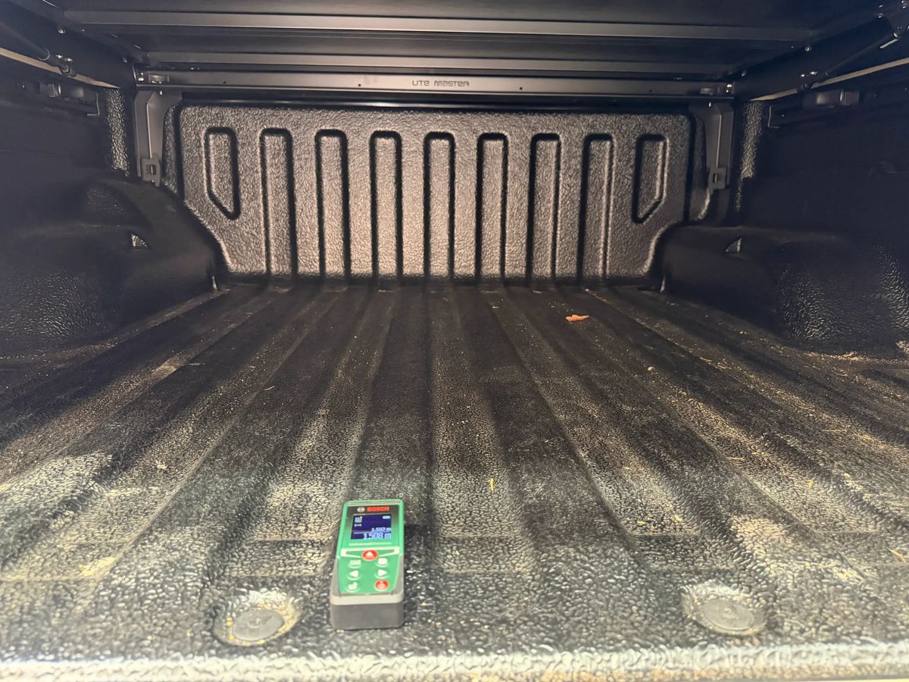
docs/measurements/photos/p1-tub-from-tailgate.jpg
