Kieran-who/kia-tasman-fitout/docs/measurements/photos/p2-passenger-rear-corner.jpg

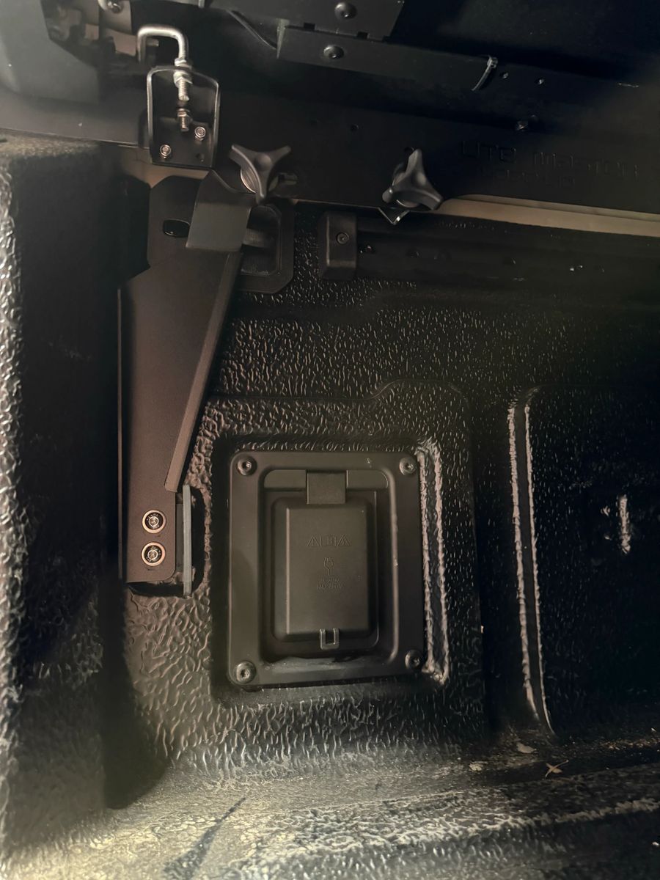
docs/measurements/photos/p2-passenger-rear-corner.jpg
