Kieran-who/kia-tasman-fitout/docs/measurements/photos/p3-passenger-rear-corner-up.jpg

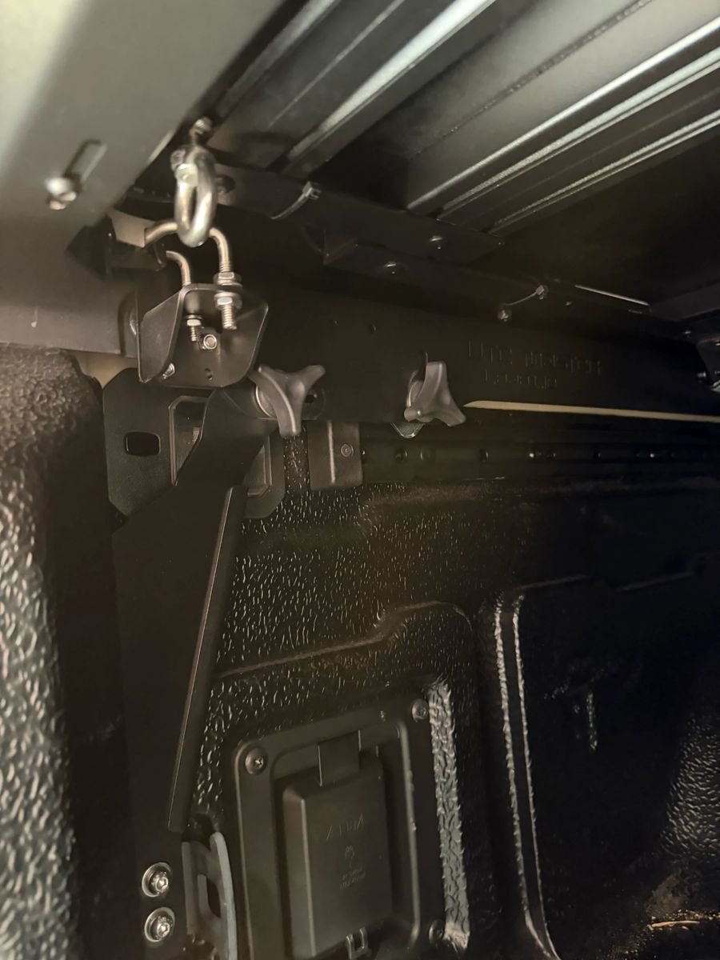
docs/measurements/photos/p3-passenger-rear-corner-up.jpg
