Kieran-who/kia-tasman-fitout/docs/measurements/photos/p4-driver-front-corner.jpg

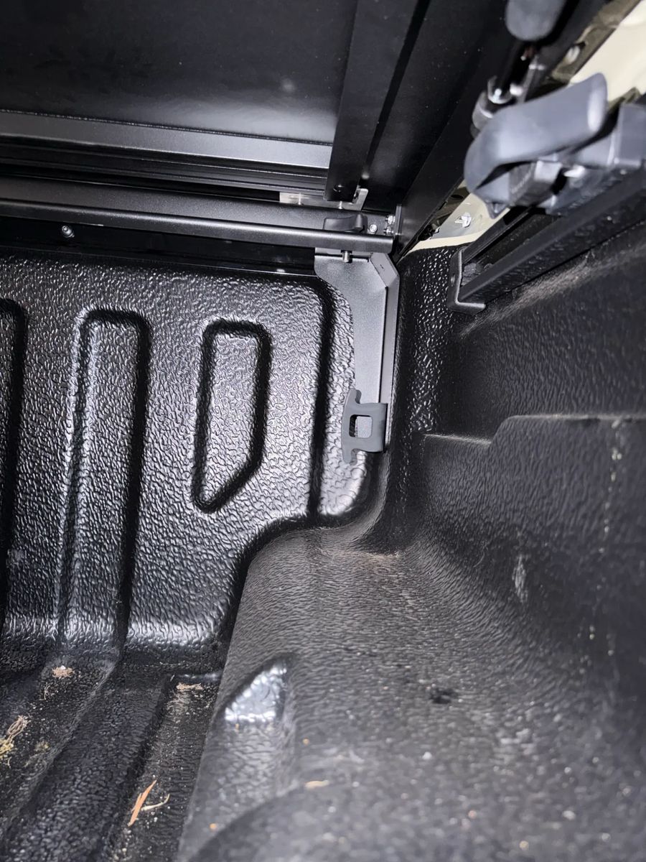
docs/measurements/photos/p4-driver-front-corner.jpg
