Kieran-who/kia-tasman-fitout/docs/measurements/photos/p5-passenger-front-corner.jpg

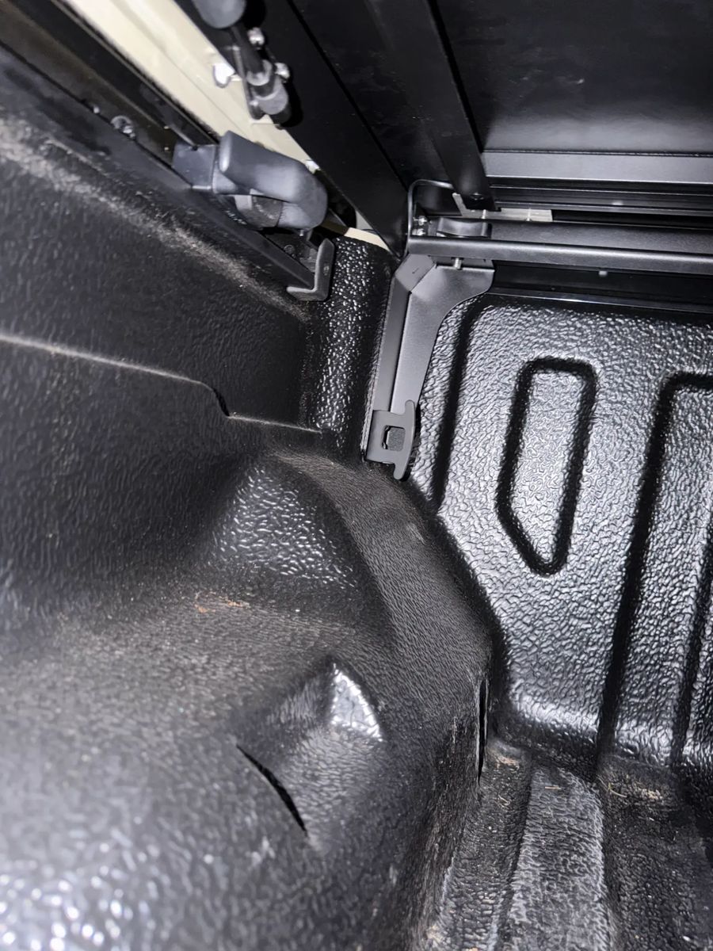
docs/measurements/photos/p5-passenger-front-corner.jpg
