Kieran-who/kia-tasman-fitout/(commit log)

2026-10-19 v0.1 concept: parametric tub/roof fit-out model, renders, research and product list
    - CadQuery parametric model (cad/params.py holds every dimension, flagged
    published / estimated / design) exporting GLB for a three.js viewer and a
    STEP of fabricated parts
    - Headless Playwright render pipeline and 8 labelled v0.1 renders
    - Front battery + inverter bay, two 4-runner heavy-duty slides with L-track
    and module receiver grid, passenger power cabinet + charging board,
    driver L-shaped water tank, Wedgetail roof platform with solar, cargo
    bars and Starlink Mini, tent-top solar
    - Design brief, v0.1 concept (electrical block diagram, weight budget,
    open questions), sourced research notes a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
2026-10-19 Add weight-reduction options analysis (water tank removal, single battery, full-length slides)
    Claude-Session: https://claude.ai/code/session_018UjLocRXJDvapqFXPBe5PS
2026-10-19 v0.2: higher-fidelity model, routed wiring, generated BOM/cut/cable lists, clash check
    - Split the CadQuery model into cad/fitout/ modules with materials and masses
    - Water tank replaced by driver-side utility drawer + over-arch tray
    - Victron Quattro 12/5000 lying flat beside batteries standing on end;
    2 x Class-T 400 A, 2 x 120 mm2 per pole, 1000 A busbars, single Orion XS
    - No pass-through in the load lid: all external wiring exits via the factory
    outlet hole, runs the chassis rail and detaches at a cab-tub gap junction
    - Tent on Rhino-Rack bars 163.4 mm above the lid, services box under the tent
    - Starlink Mini moved inside the roof platform frame (190 W + 130 W panels)
    - Slides: 2 l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
2026-10-19 v0.3: MultiPlus-II 12/3000, tailgate-only access, full-length upper drawers
    - Swap the Quattro for a MultiPlus-II 12/3000 lying flat beside the batteries
    on end; bay 320 mm deep, slides 1174 mm on 46" DZ9308 runners
    - Battery bank: MRBF 300 A per battery, equal-length 70 mm2 bank cables,
    Class-T 400 A + 2 x 50 mm2 inverter feed, SmartShunt 500 A
    - Blue Sea ML-RBS remote battery switch in the bay, switched from a rear
    control panel (lid can't be opened with the tent fitted)
    - Charging board (Orion XS, 2 x MPPT) moved to the front wall above the
    inverter; Cerbo, RCBOs and DC fuse block behind the hinged rear panel
    - Full-length upper drawers over both arches; lower control cabinet
    (p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
2026-10-19 WIP v0.4: under-mount slides, removable drawer dividers, 4 rear USB-C ports
    - Slides rebuilt with flat telescopic rails under 18 mm ply decks (deck top
    ~44 mm), decks 6 mm apart, rear roller supports, chain lane on the power
    slide's outboard edge; fridge well removed (~504 mm clear above the deck)
    - Upper drawers get aluminium divider slots (120 mm pitch) and lift-out
    dividers
    - Rear panel: 2 x dual USB-C PD (4 ports), 12 V moved to the Anderson row
    - Viewer: section-cut (clipx) option and section/drawers views
    - Rail section is a placeholder pending research (marked TBC)
    Claude-Session: https://claude.ai/code/session_018UjLocRXJ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
2026-10-19 v0.4: Rollon DE43 under-mount slides, charging rationale, 4 x USB-C, removable dividers
    - Slides: 2 x Rollon DE43 (flat-rated) under each 15 mm ply deck, deck top
    62 mm, decks 6 mm apart, rear roller supports, spring-plunger lock,
    pin-in legs; fridge well removed (486 mm clear above the deck)
    - Roof MPPT right-sized to SmartSolar 100/30; keep separate Orion XS +
    two MPPTs (combined chargers cap total output)
    - Rear panel 2 x dual USB-C (4 ports); upper drawer divider slots + lift-out
    - v0.4 renders incl. section through the slides, docs, product list,
    research notes, decision log
    Claude-Session: https://claude.ai/cod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
2026-10-19 v0.5: revert to DZ9308 side-mount runners with a covered continuous deck
    - Ply deck carried on 60x40x3 L-angles whose top leg reaches over the
    runners; both decks meet with a 6 mm gap - one continuous surface except
    the power slide's fridge well (deck top ~102 mm, 446 mm clear; 526 mm
    above the well's fridge tracks)
    - Fridge well restored (766 x ~425 mm), upright chain moved to a 50 mm lane
    on the power slide's outboard side (R63)
    - v0.5 renders incl. section, docs, product list, decision log
    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
2026-10-19 v0.6: edge-to-edge receiver grid, removable fridge-well filler, flush edge fences
    - Receiver rows 37.6 mm from each long edge (over the RHS side members, pins
    lock under the RHS top wall) and 35 mm from the deck ends; interior rows
    shared by both slides so modules swap sides
    - Removable well filler (15 mm ply on 18 mm risers, own L-track + grid),
    flush with the deck; option group, hidden by default in the viewer
    - Example flush edge fences + cross dividers (12 mm ply wall on 60x6 foot)
    - Example module pins snap to the grid, 8 x 32 mm
    - Build reports options separately; clash check treats filler/modules as
    alternatives to the example payload; viewer gains ?cam= and default-off layers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
2026-10-19 v0.7: fold-out telescopic legs stowed under the slides, arch hooks removed
    - Two legs per slide pivot on clevises on the carriage side members in the
    rear bay, fold across under the deck and clip; deployed they lock with a
    ball-lock pin and telescope (32/25/19 SHS) to the ground with a levelling foot
    - Legs only deploy once they clear the open tailgate (>= ~70 % extension)
    - Placeholder bed hooks removed; recessed well cut into each arch face [EST]
    - Example edge fences back to 150 mm
    - v0.7 renders, concept doc, product list, README and decision log
    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
2026-10-19 wiring: full circuit set for the v0.8 wiring diagram
    - Split rear-panel DC outlets into individually fused circuits (DO1A-D)
    - Add RBS control feed (RBF), SmartShunt sense (SHV), inverter fan (FAN),
    Cerbo power (CGX), Orion ignition sense (IGN), inverter case earth (PE1),
    chassis bond (CHB) and the Orion VE.Direct-USB link (D4)
    - Roof PV in parallel with 2-pole DC isolators; MPPT 100/30 fuse 40 A
    - build.py exports routed cable polylines + anchors to cad/out/cables.json
    - VERSION v0.8
    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
2026-10-19 Wiring diagram set E1-E8 generated from the routed cable model
    - tools/wiring: SVG drawing kit + generator for eight A3 sheets
    (overview/bundles, DC main, DC distribution, charging, 230 V AC,
    control/comms, tent harness + connector pinouts, route map)
    - Every schedule cable ID must appear on a sheet; bundles on E1/E8 are
    computed from the routed anchors
    - Standalone HTML with cable/protection/fuse-way/component schedules,
    and an A3 PDF (tools/render/wiring_pdf.mjs)
    - Product list v0.8 with the parts the full wiring adds
    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
2026-10-19 v0.8 interim build outputs + wiring README; ignore agent worktrees
    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
2026-10-19 v0.8 vehicle/lid/tent/roof detail: Tasman body, tub liner, Load-Lid, Vortex rack, Panther Horizon, Wedgetail roof
    - vehicle: liner per owner photo (ribs incl. behind the arches, arch relief + rounded well,
    step under the rail, recessed wall panels, factory outlet housing), rail caps with recessed
    tie-down rails and corner cleats, detailed tailgate in the unchanged open/closed envelope,
    tail lights, profiled Tasman X-Pro body (high bonnet + scoop, raked screen, A/B/C pillars,
    glass, squared arch cladding, bumpers, steps, mirrors), 265/70R17 tyres + 6-spoke rims at
    the published tracks, C-section chassis rails, axles, start battery + cabin box detail
    - lid: chamfered lid, front hinge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
2026-10-19 side bays: v0.8 detail pass for the drawers and the rear control cabinet
    - Upper drawers: dadoed carcass, ply-edge lamination lines, alu edge trim, 3-member 48" runners,
    finger-jointed 9 mm ply drawer boxes (split into real panels, bottom in grooves), true U-channel
    divider slots, lift-out dividers with finger holes, flush lockable paddle latch + carcass keeper.
    - Control panel: 3 mm overlay door on a vertical inboard piano hinge (a bottom hinge can't clear the
    socket bodies), EPDM gasket, quarter-turn latch on a 30x30 stile, real faces for the GX Touch 50,
    guarded Contura II rockers, IP66 double GPO with flip lids, 2 x dual USB-C, 2 x SB50 with dust covers,
    12 V socket with cap, e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
2026-10-19 product list v0.8: real sizes for the twin GPO, fuse block, divider channel and utility runners
    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
2026-10-19 bay: v0.8 detail pass on the battery + inverter bay
    Model every bay component on its published drawing/photos: MultiPlus-II
    12/3000 (blue cover, dark base, end caps, hanging bracket, see-through
    connection area with AC blocks, VE.Bus, DC +/-; glands, earth stud),
    92 mm fan on a plate bracket, Orion XS, SmartSolar 100/30 (published
    186 w x 130 h, finned heatsink) and 75/15, iTech400X Pro (orange lid,
    both M8 terminals at the top end, handle lugs), MRBF 5191, PowerBar
    2104 x4, ML-RBS 7713, Class-T 5502, SmartShunt 500 A, 4 MIDI/MEGA
    holders with link strap, lugs/boots, strap buckles, slotted rear guard.
    Adds anchors on the real terminals (inv_chassis_earth, inv_remote,
    orion_in/out/remote, mp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
2026-10-19 wiring: land cables on the bay's real terminal anchors (Orion in/out, MPPT PV/BAT, MIDI holders, inverter remote, shunt VE.Direct)
    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
2026-10-19 v0.8 detail: slides (DZ9308 profile, lock lever, pod outlets, link chain, legs) and example payload
    slides.py
    - Accuride DZ9308 46": real 3-member section (outer C, intermediate with ball-race
    returns, inner channel) from the 9308-E4 catalogue, M6 holes / pan screws on the
    38.1 centre line, ball hints, front lock lever, 5.75 kg per slide (catalogue,
    44"/48" interpolated; was 6.3).
    - Cassette: CSK floor bolts in base plates, cross ties and UHMW stops; carriage
    end plugs; deck screw lines and edge-cap screws; filleted edge cap; L-track
    profile with 1" pockets and dark core; flanged receiver bushes; well-pan drains,
    profiled well tracks; filler finger holes + track core.
    - Power pod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
2026-10-19 v0.8: all detail passes merged, power pod 85 mm, renders, wiring diagram regenerated, docs
    - Merge vehicle/lid/tent/roof, cabinets, bay and slides/payload detail
    - BULKHEAD_D 70 -> 85 so a real Clipsal Iconic double GPO fits the pod
    - 26 v0.8 renders from one combined shot list
    - Wiring sheets, page and PDF regenerated from the final routed model
    - docs/v0.8-concept.md, README, design brief
    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
2026-10-19 v0.9: v0.8 layout decisions resolved for minimum space
    - Distribution board gets a cable window; system - busbar lies flat on the
    base tray, so the MultiPlus DC/AC cables pass straight through
    - Rear panel: flush Iconic double GPO under a clear cover (fits 120x86)
    - Cable chain: igus E2.15.30 (37.8 mm wide) in the 50 mm lane, R75
    - Gas struts noted outside the tub (owner); tent fold-out driver side confirmed
    - v0.9 renders, wiring sheets/PDF, product list, docs
    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
2026-10-20 v0.10: under-tent storage concept
    - New cad/fitout/lid_storage.py: rivnut cross-bars clamped to the Destroyer
    rails, captive 30 L water, rear-loading drawer (table inside) between the
    tent-bolt lines, RotopaX 1 gal diesel, 2 kg extinguisher on a quick release
    - Tent mount clamp plates + bolt tails under the Vortex bars [EST]
    - Build summary reports the lid load against the 200 kg dynamic rating
    - Cargo counted as payload; viewer layers + under_tent view; renders, docs,
    product list v0.10
    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
2026-10-20 v0.11: motorised slide-out windscreen solar visor
    - cad/fitout/visor.py: guide rails under the platform, carriages driven by one worm
    gearmotor through a cross shaft and belts, hinge beam ahead of the windscreen header,
    two self-locking tilt drives (20 deg, hard stop 22 deg), fail-locked front latches
    - Roof load check (85.4 of ~100 kg); MPPT roof upgraded 100/30 -> 100/50, F5 60 A
    - New cables VIS, VSW, VIG, PVV; FB1 way 10 feeds the visor drive
    - Wiring sheet E9 (controller, motors, latches, limit switches, interlocks, sequence);
    E1, E3, E4, E6 updated; v0.11 HTML/PDF
    - docs/v0.11-concept.md, bom/product-list-v0.11.csv, renders/v0.11, viewer views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
2026-10-20 Costing: rate table for cable and raw material, costing script, README cost section (prices to follow)
    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
2026-10-20 Cost every product: real AU prices with sources where found, estimates elsewhere
    - bom/product-list-v0.11.csv: unit/line price inc GST, price type (actual, estimate,
    owned, in cables, in materials), source URL and date checked; fixed the split
    drag-chain row
    - tools/costing.py prices products + cable + raw material and writes
    bom/cost-summary-v0.11.csv, bom/cost-history.csv and the README cost section
    - Parts total v0.11: A$27,474 inc GST (53% real prices)
    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
2026-10-20 Build stages: seven-stage sequence with per-stage parts cost
    - docs/build-stages.md: order, what each stage gives, what to prepare for later
    stages (bay space, rear-panel cut-outs, draw-cords, visor cables pulled with the
    roof run, AC3 laid in the drag chain), options to spread further
    - product list gains a stage column; bom/stages.csv + bom/stage-map.csv assign
    cables and fabricated material by stage
    - tools/costing.py writes bom/cost-by-stage-v0.11.csv and the stage tables in the
    README and the build-stages doc
    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
2026-10-20 Measurement sheet: every estimated dimension, with diagrams and fill-in boxes
    - tools/measure/measure_sheet.py builds an A4 printout from cad/params.py: 90 items in
    nine areas (tub, arches, fittings, lid and rails, bars and tent, body and chassis,
    roof and windscreen, engine bay and cabin, equipment), each with the value the
    model assumes now, the build stage it blocks and a photo tick box
    - eight schematic diagrams with numbered callouts (datums, tub plan, side section,
    cross-section, lid/bars/tent plan, vehicle side, roof crown, details)
    - docs/measurements/: HTML, PDF, SVG diagrams and measurements.csv for digital entry
    Clau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
2026-10-20 Smart ute hardware research: HA + Frigate PC, cameras, thermal, tablet, network
    docs/smart-ute-research.md: recommended parts and alternatives, STARVIS 3 status
    (IMX908 announced, no IP cameras yet), system architecture, Frigate config outline,
    power budget by mode, cost estimate (recommended vs value build), heat risks, road
    rule 299 notes, quotes and measurements needed, and sources.
    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
2026-10-20 Smart ute research: defer thermal, drop 4G, cheaper tablet and network
    - Thermal camera and dash screen moved to a deferred phase-2 section
    - Router: Teltonika RUTM10 (no cellular); PoE: PC's 4 PoE ports + one TSW101
    replaces the TSW202 + Orion-Tr 12/48
    - Tablet: Redmi Pad 2 Pro (12,000 mAh, 80% charge limit) with a budget comparison
    table (Lenovo Idea Tab Plus, OPPO Pad SE, Tab A11+, Redmi Pad 2, TCL NXTPAPER)
    - Power budget and cost re-done: about A$7.4-8.7k recommended, A$6.35-7.05k value
    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
2026-10-20 Smart switching proposal: HA control with hard-wired manual override
    docs/smart-switching.md: inverter via VE.Bus mode (HA Victron GX select, S2 kept as
    master off), one Smart BatteryProtect per switched 12 V circuit with ON/OFF/AUTO
    rockers, AUTO contacts from Cerbo relays + GX IO-Extender 150 (+ a Shelly Plus Uni
    under the seat), fail-safe defaults (fridge pod fails on, Starlink fails off), loads
    never put under HA (ML-RBS, Cerbo, PC feed), automations, parts and cost.
    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
2026-10-21 Outlets and switching: pod and cabin without USB-C, cabin becomes the compute feed
    - Power-slide pod: Anderson, 12 V and 230 V only (dual USB-C sockets removed from the model)
    - Cabin feed DO3 becomes the 15 A feed to the under-seat compute box (SB50 inlet,
    BatteryProtect, per-device fuses); no outlets in the cabin
    - Rear USB-C: 2 x Treklo dual 120 W (100 W PD + 20 W each); feed DO1C upsized to
    4 mm2 / ATC 25 A (both flat out draw ~22 A, the old 10 A fuse was too small)
    - Smart switching reduced to Starlink and tent rockers (S4, S5) plus the camera
    switch; cabin, pod and rear outlets always on; tablet on the Tasman's own USB-C
    - Wiring E1/E3 + schedules, product list, stages, research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
2026-10-21 v0.12: cable chain flat under the power deck, full-width decks, pod fed from the bay
    - igus E2.15 R75 chain laid on its side on a 3 mm glide tray under the
    power deck; outboard lane removed so the power deck widens 529 -> 579 mm
    - Fridge-well pan raised to 54 mm (tallest fridge ~490 mm); pan L-tracks
    replaced by flush tie-down rings
    - Pod 12 V (DO2) fed from an MRBF 30 A (F17) on the system + busbar,
    routed down behind the inverter into the slide front; AC3 follows;
    FB1 way 5 spare
    - Pod USB-C removed; wiring E1-E9, costing, stages, measurement sheet,
    docs and renders regenerated
    Claude-Session: https://claude.ai/code/session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
2026-10-21 v0.13: routed wiring network, route sheets, electrical audit fixes, fridge handle straps
    Wiring model
    - Cables now follow 33 named runs (R01-R33) with containment and fixing:
    divided 120 mm tray (230 V | 12 V), wall channel, gland plate rows,
    cabinet slot + 230 V gland, NW48 / orange conduits on P-clips, hollow
    platform end member, chain separator; lane-packed bundles, twins as
    + / - cores; conduits, clips and grommets in the viewer
    - cad/cable_check.py: every cable against every solid part (139 -> 0)
    - Tent harness split T1A (230 V) / T1D (12 V + PV); T2 via the front hinge
    - bom/route-schedule; route column in the cable schedule
    Wiring diagram: 15 sheets
    - New to-scale route sheet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
2026-10-23 Research: KickAss house battery alternatives vs the iTech400X Pro
    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
2026-10-23 Cold-weather proposal (battery and water heating); correct iTech400X Pro specs and price
    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
2026-10-23 v0.14: cold-weather heating for the battery bank and the water can
    - Battery bay: closed-cell foam (20 mm rear, 15 mm inboard, 6 mm top, 4 mm front
    and outer above the arch); 2 x 50 W silicone pads on the batteries' facing sides
    between the cage straps, each with a 50 C cut-out; TH1 thermostat + relay box
    behind the gap (+3 / +8 C), probe on battery 2.
    - Charge backstop: Victron temperature sensor TS1 on battery 1 + (replaces SHV),
    SmartShunt Aux, DVCC shared temperature, chargers' low-temp cut-off +3 C.
    - Water can: foam jacket (30 mm top grooved for the tent rail, 18-20 mm sides and
    end, cap end open), 50 W pad between the cross-bars under the can, TH2 + F19 5 A
    in the tent ser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
2026-10-25 Measurement sheet: rear corners and tail-light housings (C1-C10)
    The tail-light housings intrude at both rear corners (owner photos), reversing
    the v0.3 assumption. New group 3b: housing size each side, shape, access plugs,
    clear length behind the arch, clear width beside the housing, rib behind the
    arch, outlet recess, stepped arch top, lid hardware below the rail; photo list
    item; dashed placeholders and callouts on drawings D1 and D2. Design brief
    records the correction; params note updated (value stays 0 until measured).
    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
2026-11-01 Tub photos: photo-estimated housings and lid hardware; marked-up measurement guide
    - Model (est='photo'): tail-light housings 180 x 80 both sides; Load-Lid rail and
    side skirt along both wall tops, star knobs, rear stays to 2 bolts at each housing,
    front-corner brackets with hooks; gas struts moved inside the tub at the front.
    Outlet photo position recorded (FACTORY_OUTLET_PHOTO).
    - clash.py / cable_check.py list conflicts with photo-estimated parts separately:
    design 0 / 0; photo-estimate conflicts 79 / 110 (travel), at the rear corners and
    along the wall tops - the re-plan once measured.
    - Measurement sheet: photo guide (owner photos P1-P5 marked with reference lines,
    start/end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
